WhiteFossa/yiff-l/Hardware/Antennas equivalents/photo_2020-12-26_08-08-45.jpg

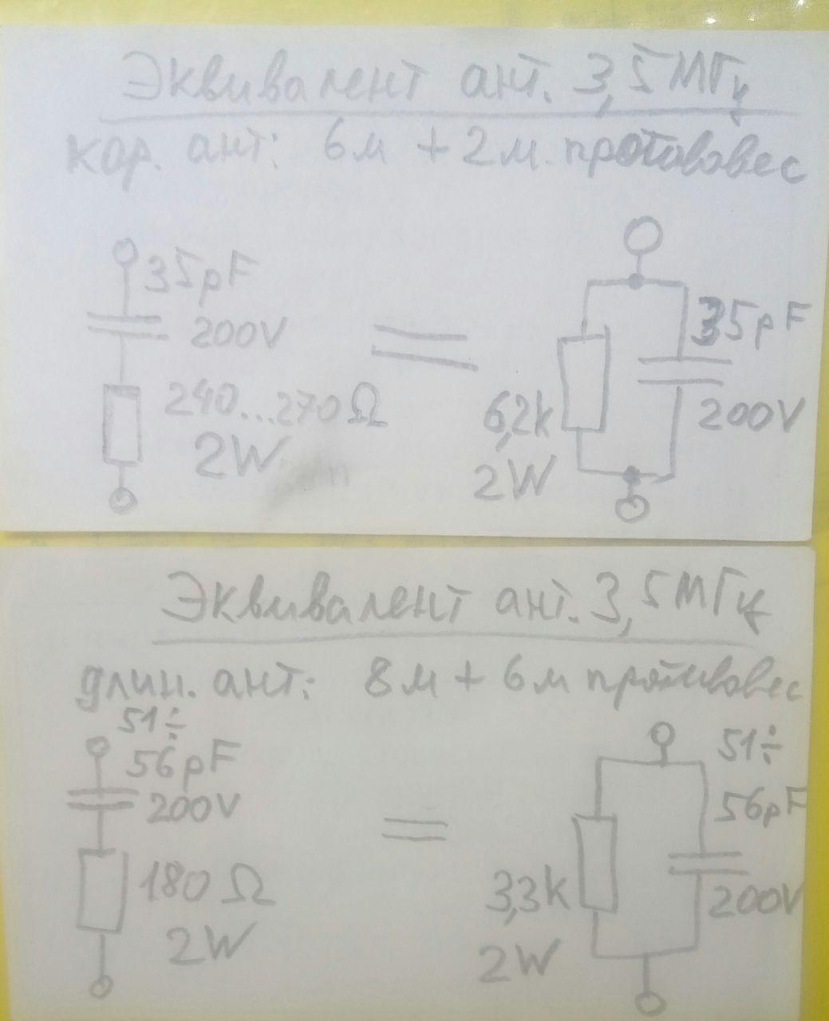
Hardware/Antennas equivalents/photo_2020-12-26_08-08-45.jpg
