WhiteFossa/yiff-l/README.md

3rd party code used:
https://github.com/mpaland/printf - MIT
