WhiteFossa/yiff-l/Hardware/Schematic v1/Full schematic/Full schematic.html

# /mnt/nfs/th/sps/fossa/Projects/Electronics/yiff-l/Hardware/Full schematic/Full schematic/Full schematic.sch

Чт 24 июн 2021 15:16:40

Eeschema 5.1.10-1.fc34

Component Count:329

Ref | Qnty | Value | Part | Datasheet | Description | Vendor
C1 | 1 | 100uFx16V | Device:CP | ~ | Polarized capacitor
C2, C3, C4, C5, C7, C8, C18, C24, C54, C56, C59, C61, C62, C64, C65, C66, C68, C69, C70, C74, C86, C94, C98, C99, C100, C108, C109, C112 | 28 | 0.1uF | Device:C | ~ | Unpolarized capacitor
C6, C30, C37, C38, C39, C41, C42, C43, C51, C55, C71, C77, C96, C97 | 14 | 1nF | Device:C | ~ | Unpolarized capacitor
C9, C10, C11, C12 | 4 | 22uFx16V | Device:CP | ~ | Polarized capacitor
C13 | 1 | 1uF | Device:C | ~ | Unpolarized capacitor
C14, C15, C16, C17, C23, C34, C35, C45, C46, C47, C52, C57, C60, C67, C85 | 15 | 4.7uF | Device:C | ~ | Unpolarized capacitor
C19 | 1 | 150pF | Device:C | ~ | Unpolarized capacitor
C20 | 1 | 220pF | Device:C | ~ | Unpolarized capacitor
C21, C22, C26, C27, C28, C32, C63, C73, C76, C78, C81, C93, C95 | 13 | 10nF | Device:C | ~ | Unpolarized capacitor
C25 | 1 | 180pF | Device:C | ~ | Unpolarized capacitor
C29 | 1 | 1000uF x 10V | Device:CP | ~ | Polarized capacitor
C31, C44, C120, C121, C122, C123, C124, C125 | 8 | 47pF | Device:C | ~ | Unpolarized capacitor
C33, C114, C115, C116, C117, C118, C119 | 7 | 100pF | Device:C | ~ | Unpolarized capacitor
C36, C113 | 2 | 56pF | Device:C | ~ | Unpolarized capacitor
C40 | 1 | 10uFx25V tantalum | Device:CP | ~ | Polarized capacitor
C48, C49, C50 | 3 | 220uFx6.3V | Device:CP | ~ | Polarized capacitor
C53, C58 | 2 | 1000uF x 25V | Device:CP | ~ | Polarized capacitor
C72, C84 | 2 | 75pF | Device:C | ~ | Unpolarized capacitor
C75 | 1 | 100uFx6.3V | Device:CP | ~ | Polarized capacitor
C79, C80 | 2 | 22pF | Device:C | ~ | Unpolarized capacitor
C82, C83 | 2 | 8pF | Device:C | ~ | Unpolarized capacitor
C87, C88, C89, C90, C91, C92 | 6 | 390pF | Device:C | ~ | Unpolarized capacitor
C101 | 1 | 20pF | Device:C | ~ | Unpolarized capacitor
C102, C103, C104, C105, C106, C107 | 6 | 200pF | Device:C | ~ | Unpolarized capacitor
C110 | 1 | 100uF x 16V | Device:CP | ~ | Polarized capacitor
C111 | 1 | 22uF x 10V | Device:CP | ~ | Polarized capacitor
C126, C127, C128, C129, C130, C131 | 6 | 24pF | Device:C | ~ | Unpolarized capacitor
C132, C133, C134, C135, C136, C137 | 6 | 12pF | Device:C | ~ | Unpolarized capacitor
D1, D2, D3, D8, D9, D10, D11, D13 | 8 | 1N4148W | Diode:1N4148W | https://www.vishay.com/docs/85748/1n4148w.pdf | 75V 0.15A Fast Switching Diode, SOD-123
D4, D5, D6, D7 | 4 | MBR0520 | Device:D_Schottky | ~ | Schottky diode
D12 | 1 | 1N5819 | Device:D_Schottky | ~ | Schottky diode
D14 | 1 | 1N4728A | Diode:1N47xxA | https://www.vishay.com/docs/85816/1n4728a.pdf | 1300mW Silicon planar power Zener diodes, DO-41
DA1 | 1 | AD825 | Fossa_library:AD825
J1, J6, J9 | 3 | Conn_01x02_Male | Connector:Conn_01x02_Male | ~ | Generic connector, single row, 01x02, script generated (kicad-library-utils/schlib/autogen/connector/)
J2 | 1 | Reset | Connector:Conn_01x02_Male | ~ | Generic connector, single row, 01x02, script generated (kicad-library-utils/schlib/autogen/connector/)
J3 | 1 | Encoder | Connector:Conn_01x04_Male | ~ | Generic connector, single row, 01x04, script generated (kicad-library-utils/schlib/autogen/connector/)
J4 | 1 | Failure LED | Connector:Conn_01x02_Male | ~ | Generic connector, single row, 01x02, script generated (kicad-library-utils/schlib/autogen/connector/)
J5 | 1 | Bluetooth | Connector:Conn_01x04_Male | ~ | Generic connector, single row, 01x04, script generated (kicad-library-utils/schlib/autogen/connector/)
J7 | 1 | Display | Connector:Conn_01x04_Male | ~ | Generic connector, single row, 01x04, script generated (kicad-library-utils/schlib/autogen/connector/)
J8 | 1 | Buttons | Connector:Conn_01x03_Male | ~ | Generic connector, single row, 01x03, script generated (kicad-library-utils/schlib/autogen/connector/)
J10 | 1 | Conn_01x01_Male | Connector:Conn_01x01_Male | ~ | Generic connector, single row, 01x01, script generated (kicad-library-utils/schlib/autogen/connector/)
JP1 | 1 | BOOT0 | Jumper:Jumper_3_Bridged12 | ~ | Jumper, 3-pole, pins 1+2 closed/bridged
JP2 | 1 | BOOT1 | Jumper:Jumper_3_Bridged12 | ~ | Jumper, 3-pole, pins 1+2 closed/bridged
JP3 | 1 | SWDIO | Device:Jumper | ~ | Jumper, normally closed
JP4 | 1 | SWCLK | Device:Jumper | ~ | Jumper, normally closed
K1, K2, K3, K4, K5, K6 | 6 | EDR101A0500 | Fossa_library:EDR101A0500 | https://standexelectronics.com/de/produkte/ms-reed-relais/ | Standex Meder MS reed relay, SPST, Closing Contact
L1, L3, L4, L5, L11 | 5 | 10uH | Device:L | ~ | Inductor
L2, L9 | 2 | 3.3uH | Device:L | ~ | Inductor
L6, L7 | 2 | 4.7uH | Device:L | ~ | Inductor
L8 | 1 | 50uH | Device:L | ~ | Inductor
L10 | 1 | 150uH | Device:L | ~ | Inductor
L12 | 1 | 21uH | Device:L | ~ | Inductor
L13 | 1 | 200nH | Device:L | ~ | Inductor
L14 | 1 | 300nH | Device:L | ~ | Inductor
L15 | 1 | 23.5nH | Device:L | ~ | Inductor
Q1, Q2, Q3, Q4, Q5, Q11, Q13, Q15, Q17, Q19 | 10 | BC847 | Transistor_BJT:BC847 | http://www.infineon.com/dgdl/Infineon-BC847SERIES_BC848SERIES_BC849SERIES_BC850SERIES-DS-v01_01-en.pdf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 | 0.1A Ic, 45V Vce, NPN Transistor, SOT-23
Q6, Q8, Q9, Q10, Q18, Q21 | 6 | IRLML6402 | Transistor_FET:IRLML6402 | https://www.infineon.com/dgdl/irlml6402pbf.pdf?fileId=5546d462533600a401535668d5c2263c | -3.7A Id, -20V Vds, 65mOhm Rds, P-Channel HEXFET Power MOSFET, SOT-23
Q7 | 1 | IRF4905 | Transistor_FET:IRF4905 | http://www.infineon.com/dgdl/irf4905.pdf?fileId=5546d462533600a4015355e32165197c | -74A Id, -55V Vds, Single P-Channel HEXFET Power MOSFET, 20mOhm Ron, TO-220AB
Q12 | 1 | IRFZ44 | Device:Q_NMOS_GDS | ~ | N-MOSFET transistor, gate/drain/source
Q14 | 1 | BSS138 | Transistor_FET:BSS138 | https://www.onsemi.com/pub/Collateral/BSS138-D.PDF | 50V Vds, 0.22A Id, N-Channel MOSFET, SOT-23
Q16 | 1 | IRF610 | Device:Q_NMOS_GDS | ~ | N-MOSFET transistor, gate/drain/source
Q20 | 1 | BFS17 | Device:Q_NPN_BEC | ~ | NPN transistor, base/emitter/collector
Q22 | 1 | AFT05MS003N | Device:Q_NMOS_GSD | ~ | N-MOSFET transistor, gate/source/drain
Q23, Q24, Q25, Q26, Q27, Q28 | 6 | IRLML2502 | Device:Q_NMOS_GSD | ~ | N-MOSFET transistor, gate/source/drain
R1, R2, R3, R25, R26, R27, R52, R54, R61, R89, R93, R94, R95, R96, R97 | 15 | 100 | Device:R | ~ | Resistor
R4, R5, R11, R17 | 4 | 47k | Device:R | ~ | Resistor
R6, R7, R8, R9, R10, R12, R13, R14, R15, R16, R23, R37, R39, R41, R43, R68, R69, R77, R79, R81 | 20 | 10k | Device:R | ~ | Resistor
R18, R19, R20, R21, R22, R42, R74, R85 | 8 | 10 | Device:R | ~ | Resistor
R24, R48, R64, R65, R67, R70, R73, R78, R80, R84, R86, R87, R88, R90, R91, R92 | 16 | 4.7k | Device:R | ~ | Resistor
R28 | 1 | 1.3k | Device:R | ~ | Resistor
R29 | 1 | 150k | Device:R | ~ | Resistor
R30 | 1 | 12k | Device:R | ~ | Resistor
R31 | 1 | 300 | Device:R | ~ | Resistor
R32, R35 | 2 | 13k | Device:R | ~ | Resistor
R33, R62 | 2 | 3.9k | Device:R | ~ | Resistor
R34 | 1 | 120k | Device:R | ~ | Resistor
R36 | 1 | 51k | Device:R | ~ | Resistor
R38, R75 | 2 | 39k | Device:R | ~ | Resistor
R40, R50, R58 | 3 | 30k | Device:R | ~ | Resistor
R44, R53, R60, R83 | 4 | 1k | Device:R | ~ | Resistor
R45, R46, R47, R49 | 4 | 1 | Device:R | ~ | Resistor
R51, R59 | 2 | 6.8k | Device:R | ~ | Resistor
R55 | 1 | 36k | Device:R | ~ | Resistor
R56 | 1 | 4.3k | Device:R | ~ | Resistor
R57 | 1 | 56k | Device:R | ~ | Resistor
R63 | 1 | 2k | Device:R | ~ | Resistor
R66 | 1 | 33k | Device:R | ~ | Resistor
R71 | 1 | 220k | Device:R | ~ | Resistor
R72 | 1 | 11k | Device:R | ~ | Resistor
R76 | 1 | 33 | Device:R | ~ | Resistor
R82 | 1 | 6.2k | Device:R | ~ | Resistor
RV1, RV2 | 2 | 20k | Device:R_POT | ~ | Potentiometer
U1, U2 | 2 | 74LVC2T45DC | Logic_LevelTranslator:74LVC2T45DC | https://assets.nexperia.com/documents/data-sheet/74LVC_LVCH2T45.pdf | Dual supply translating transceiver, 3-state, 2-bit, VSSOP-8
U3 | 1 | AD9835 | Fossa_library:AD9835
U4 | 1 | LM27313XMF | Regulator_Switching:LM27313XMF | http://www.ti.com/lit/ds/symlink/lm27313.pdf | 1A, 28Vout Boost Voltage Regulator, 1.6MHz Frequency, SOT-23-5
U5, U6, U7 | 3 | LM2734X | Regulator_Switching:LM2734X | http://www.ti.com/lit/ds/symlink/lm2734.pdf | 1A Step-Down DC-DC Regulator, Adjustable Output Voltage, 1.6MHz, TSOT-23-5
U8 | 1 | UC3843_SOIC8 | Regulator_Controller:UC3843_SOIC8 | http://www.ti.com/lit/ds/symlink/uc3842.pdf | Current-Mode PWM Controllers, 100% Duty Cycle, 8.4V/7.6V UVLO, SOIC-8
U9 | 1 | AD5245BRJZ10 | Fossa_library:AD5245
U10 | 1 | ICS501 | Fossa_library:ICS501
U11 | 1 | STM32F103C8Tx | MCU_ST_STM32F1:STM32F103C8Tx | http://www.st.com/st-web-ui/static/active/en/resource/technical/document/datasheet/CD00161566.pdf | ARM Cortex-M3 MCU, 64KB flash, 20KB RAM, 72MHz, 2-3.6V, 37 GPIO, LQFP-48
U12 | 1 | CAT24C256 | Memory_EEPROM:CAT24C256 | https://www.onsemi.cn/PowerSolutions/document/CAT24C256-D.PDF | 256 kb CMOS Serial EEPROM, DIP-8/SOIC-8/TSSOP-8/DFN-8
X1 | 1 | 50MHz | Oscillator:CXO_DIP8 | http://cdn-reichelt.de/documents/datenblatt/B400/OSZI.pdf | Crystal Clock Oscillator, DIP8-style metal package
Y1 | 1 | 8MHz | Device:Crystal | ~ | Two pin crystal
Y2 | 1 | 32768Hz | Device:Crystal | ~ | Two pin crystal
