WhiteFossa/yiff-l/Software/Docs/Smartphone to Fox protocol.odt

Smartphone to Fox communication protocol description

by White Fossa aka Artyom Vetrov.

License: AGPLv3+

# Common packet format

Exchange between smartphone and fox is made via Bluetooth-RFCOMM (i.e. via virtual UART).

All packets (both directions) have the same basic structure:

| Full packet length | Payload | CRC
Size | 1 byte | 1-59 bytes | 4 bytes
Description | Full packet length (i.e. including CRC and packet length byte). Value must be [6-64] (fox-side buffer is 64 bytes length). | Just a payload, here can be anything. | Standard CRC32, calculated over full packet length and payload fields.

Packets with wrong full length (i.e. not from [6-64] range) is discarded immediately.

CRC32 is re-calculated on the receiving side after packet reception, packets with incorrect CRC is discarded too.

# Payload type

First byte of payload always specify type of it. Next types are currently supported:

Payload type | Description | First byte value
Command to fox | Command, issued by smartphone. This type of packet is always sent by smartphone and never by the fox. | 0x00
Response to command | Response to the command from smartphone. Can be sent only by the fox and only as a response to command. | 0x01
Event from fox | Issued by fox when something is happened. Always issued without previous command. | 0x02

# Sleepmodes

All commands with correct CRC reset sleepmodes timer, causing fox to remain active with display turned on. To avoid sleeping it is recommended to use “No operation” command.

# Set date and time

Issue this command to set fox date and time.

This command will fail if fox is armed!

Payload format:

Payload byte | Value | Description
0 | 0x00 | Command to fox
1 | 0x00 | Set date and time
2 | 0-99 | Year of XXI century
3 | 1-12 | Month (1 is January)
4 | 1-31 | Day of month
5 | 1-7 | Day of week (1 is Monday)
6 | 0-23 | Hour
7 | 0-59 | Minute
8 | 0-59 | Second

Total payload length: 9 bytes.

Fox will answer:

Payload byte | Value | Description
0 | 0x01 | Response to command
1 | 0x00 | Set date and time
2 | 0x00 or 0x01 | Is successful? 0x00 if successful, 0x01 if not (for example if time is incorrect).

# Set fox name

Issue this command to set fox name. Note, that setting name also update the bluetooth device name, so it is possible that new pairing will be required.

This command will fail if fox is armed!

Payload format:

Payload byte | Value | Description
0 | 0x00 | Command to fox
1 | 0x01 | Set fox name
2 | 1-32 | Name length
3-35 | Name bytes | Fox name (without null termination)

Fox will answer:

Payload byte | Value | Description
0 | 0x01 | Response to command
1 | 0x01 | Set fox name
2 | 0x00 or 0x01 | Is successful? 0x00 if successful, 0x01 if not (for example if name is too long).

# Get fox name

Issue this command to get fox name.

Payload format:

Payload byte | Value | Description
0 | 0x00 | Command to fox
1 | 0x02 | Get fox name

Fox will answer:

Payload byte | Value | Description
0 | 0x01 | Response to command
1 | 0x02 | Get fox name
2 | 1-32 | Fox name length
3-35 | Name bytes | Fox name (without null termination)

# Get profiles count

Issue this command to get count of profiles inside a fox.

Payload format:

Payload byte | Value | Description
0 | 0x00 | Command to fox
1 | 0x03 | Get profiles count

Fox will answer:

Payload byte | Value | Description
0 | 0x01 | Response to command
1 | 0x03 | Get profiles count
2 | 1-255 | Profiles count

# Get profile name

Issue this command to given profile name.

Payload format:

Payload byte | Value | Description
0 | 0x00 | Command to fox
1 | 0x04 | Get profile name
2 | 0-255 | Profile ID

Fox will answer:

Payload byte | Value | Description
0 | 0x01 | Response to command
1 | 0x04 | Get profile name
2 | 0x00 or 0x01 | Is successful? 0x00 if successful, 0x01 if not (when profile ID is wrong).
3 | 0-255 | Profile ID
4 | 1-16 | Profile name length (have no meaning if not successful)
5-21 | Name bytes | Profile name (without null termination)

# Add new profile

Issue this command to add a new profile.

This command will fail if fox is armed!

Payload format:

Payload byte | Value | Description
0 | 0x00 | Command to fox
1 | 0x05 | Add profile

Fox will answer:

Payload byte | Value | Description
0 | 0x01 | Response to command
1 | 0x05 | Add profile
2 | 0x00 or 0x01 | Is successful? 0x00 if successful, 0x01 if not (when there is too much profiles).

# Get current profile ID

Issue this command to get current profile ID

Payload format:

Payload byte | Value | Description
0 | 0x00 | Command to fox
1 | 0x06 | Get current profile ID

Fox will answer:

Payload byte | Value | Description
0 | 0x01 | Response to command
1 | 0x06 | Get current profile ID
2 | 0-255 | Current profile ID

# Switch to profile

Issue this command to switch to given profile and load fox settings from it.

This command will fail if fox is armed!

Payload format:

Payload byte | Value | Description
0 | 0x00 | Command to fox
1 | 0x07 | Switch to profile
2 | 0-255 | Profile ID to switch

Fox will answer:

Payload byte | Value | Description
0 | 0x01 | Response to command
1 | 0x07 | Switch to profile
2 | 0x00 or 0x01 | Is successful? 0x00 if successful, 0x01 if not (when profile ID is incorrect).

# Set profile name

Issue this command to set current profile name.

This command will fail if fox is armed!

Payload format:

Payload byte | Value | Description
0 | 0x00 | Command to fox
1 | 0x08 | Set profile name
2 | 1-16 | Profile name length
3-18 | Name bytes | Profile name

Fox will answer:

Payload byte | Value | Description
0 | 0x01 | Response to command
1 | 0x08 | Set profile name
2 | 0x00 or 0x01 | Is successful? 0x00 if successful, 0x01 if not (if name length is incorrect).

# Get frequency

Issue this command to get fox frequency

Payload format:

Payload byte | Value | Description
0 | 0x00 | Command to fox
1 | 0x09 | Get frequency

Fox will answer:

Payload byte | Value | Description
0 | 0x01 | Response to command
1 | 0x09 | Get frequency
2 | 0x00 or 0x01 | Is 144MHz? If 0x00 then fox in 3.5MHz range (80m), if 0x01 – then in 144MHz range (2m)
3-6 | uint32_t with frequency, least significant byte first | Fox frequency in Hz

# Set frequency

Issue this command to set fox frequency.

Allowed frequency ranges:

- 3500000 – 3650000 Hz for 3.5MHz range
- 144000000 – 146000000 Hz for 144MHz range

This command will fail if fox is armed!

Payload format:

Payload byte | Value | Description
0 | 0x00 | Command to fox
1 | 0x0A | Set frequency
2 | 0x00 or 0x01 | Is 144MHz? If 0x00 then fox in 3.5MHz range (80m), if 0x01 – then in 144MHz range (2m)
3-6 | uint32_t with frequency, least significant byte first | Fox frequency in Hz

Fox will answer:

Payload byte | Value | Description
0 | 0x01 | Response to command
1 | 0x0A | Set frequency
2 | 0x00 or 0x01 | Is successful? 0x00 if successful, 0x01 if not (if frequency outside allowed ranges).

# Get code

Issue this command to get fox code.

Payload format:

Payload byte | Value | Description
0 | 0x00 | Command to fox
1 | 0x0B | Get fox code

Fox will answer:

Payload byte | Value | Description
0 | 0x01 | Response to command
1 | 0x0B | Get fox code
2 | 0-6 | Fox code: 0 – Finish (MO) 1- Fox #1 (MOE) 2 – Fox #2 (MOI) 3 – Fox #3 (MOS) 4 – Fox #4 (MOH) 5 – Fox #5 (MO5) 6 – Beacon (S)

# Set code

Issue this command to set fox code.

This command will fail if fox is armed!

Payload format:

Payload byte | Value | Description
0 | 0x00 | Command to fox
1 | 0x0C | Set fox code
2 | 0-6 | Fox code: 0 – Finish (MO) 1- Fox #1 (MOE) 2 – Fox #2 (MOI) 3 – Fox #3 (MOS) 4 – Fox #4 (MOH) 5 – Fox #5 (MO5) 6 – Beacon (S)

Fox will answer:

Payload byte | Value | Description
0 | 0x01 | Response to command
1 | 0x0C | Set fox code
2 | 0x00 or 0x01 | Is successful? 0x00 if successful, 0x01 if not (if requested invalid code).

# Get speed

Issue this command to get fox speed.

Payload format:

Payload byte | Value | Description
0 | 0x00 | Command to fox
1 | 0x0D | Get fox speed

Fox will answer:

Payload byte | Value | Description
0 | 0x01 | Response to command
1 | 0x0D | Get fox speed
2 | 0x00 or 0x01 | Fox speed: 0x00 – slow, 0x01 – fast

# Set speed

Issue this command to set fox speed.

This command will fail if fox is armed!

Payload format:

Payload byte | Value | Description
0 | 0x00 | Command to fox
1 | 0x0E | Set fox speed
2 | 0x00 or 0x01 | Fox speed: 0x00 – slow, 0x01 – fast

Fox will answer:

Payload byte | Value | Description
0 | 0x01 | Response to command
1 | 0x0E | Set fox speed
2 | 0x00 or 0x01 | Is successful? 0x00 if successful, 0x01 if not (if requested invalid speed).

# Get cycle

Issue this command to get fox cycle parameters.

Payload format:

Payload byte | Value | Description
0 | 0x00 | Command to fox
1 | 0x0F | Get fox cycle parameters

Fox will answer:

Payload byte | Value | Description
0 | 0x01 | Response to command
1 | 0x0F | Get fox cycle parameters
2 | 0x00 or 0x01 | Is continuous transmission? 0x00 – cyclic transmission, 0x01 – continuous transmission
3-4 | uint16_t, least significant byte first | Transmission time (in seconds), applicable only for cyclic transmission
5-6 | uint16_t, least significant byte first | Pause time (in seconds), applicable only for cyclic transmission

# Set cycle

Issue this command to set fox cycle parameters.

This command will fail if fox is armed!

Payload format:

Payload byte | Value | Description
0 | 0x00 | Command to fox
1 | 0x10 | Set fox cycle parameters
2 | 0x00 or 0x01 | Is continuous transmission? 0x00 – cyclic transmission, 0x01 – continuous transmission
3-4 | uint16_t, least significant byte first | Transmission time (in seconds), applicable only for cyclic transmission, but you must send it in any cases
5-6 | uint16_t, least significant byte first | Pause time (in seconds), applicable only for cyclic transmission, but you must send it in any cases

Fox will answer:

Payload byte | Value | Description
0 | 0x01 | Response to command
1 | 0x10 | Set fox cycle parameters
2 | 0x00 or 0x01 | Is successful? 0x00 if successful, 0x01 if not (too short durations).

# Get ending tone duration

Issue this command to get ending tone duration.

Payload format:

Payload byte | Value | Description
0 | 0x00 | Command to fox
1 | 0x11 | Get ending tone duration

Fox will answer:

Payload byte | Value | Description
0 | 0x01 | Response to command
1 | 0x11 | Get ending tone duration
2 | uint8_t | Ending tone duration in seconds

# Set ending tone duration

Issue this command to set ending tone duration.

This command will fail if fox is armed!

Payload format:

Payload byte | Value | Description
0 | 0x00 | Command to fox
1 | 0x12 | Set ending tone duration
2 | uin8_t | Ending tone duration in seconds

Fox will answer:

Payload byte | Value | Description
0 | 0x01 | Response to command
1 | 0x12 | Set ending tone duration
2 | 0x00 or 0x01 | Is successful? 0x00 if successful, 0x01 if not (too long ending tone).

# Get begin and end times

Issue this command to get times when fox will turn on and off.

Payload format:

Payload byte | Value | Description
0 | 0x00 | Command to fox
1 | 0x13 | Get begin and end times

Fox will answer:

Payload byte | Value | Description
0 | 0x01 | Response to command
1 | 0x13 | Get begin and end times
2-5 | uint32_t, least significant byte first | Begin time (seconds since midnight)
6-9 | uin32_t, least significant byte first | End time (seconds since midnight)

# Is fox armed?

Issue this command to check is fox armed or not. If armed, then it will start to transmit at Begin Time and end at End Time (see “Get begin and end times” command). If fox not armed, it will be in standby forever.

Payload format:

Payload byte | Value | Description
0 | 0x00 | Command to fox
1 | 0x14 | Is fox armed?

Fox will answer:

Payload byte | Value | Description
0 | 0x01 | Response to command
1 | 0x14 | Is fox armed?
2 | 0x00 or 0x01 | 0x00 if not armed, 0x01 if armed

# Arm fox

Issue this command to arm fox. Armed fox will start to transmit at previously set time.

Payload format:

Payload byte | Value | Description
0 | 0x00 | Command to fox
1 | 0x15 | Arm fox

Fox will answer:

Payload byte | Value | Description
0 | 0x01 | Response to command
1 | 0x15 | Arm fox
2 | 0x00 or 0x01 | Is successful? 0x00 if successful, 0x01 if not (fox already armed, for example)

Note, that successful answer doesn’t mean that fox is armed, it just signalizing that arming process is started.

# Disarm fox

Issue this command to disarm fox. If fox in countdown before start, then countdown will be aborted and fox will switch to standby mode, if fox already transmitting – transmission will be cancelled.

This command will fail if fox is NOT armed!

This command will fail if antenna matching in progress!

Payload format:

Payload byte | Value | Description
0 | 0x00 | Command to fox
1 | 0x16 | Disarm fox

Fox will answer:

Payload byte | Value | Description
0 | 0x01 | Response to command
1 | 0x16 | Disarm fox
2 | 0x00 or 0x01 | Is successful? 0x00 if successful, 0x01 if not (internal error during disarming)

# Set begin and end times

Issue this command to set times when fox will turn on and off.

This command will fail if fox is armed!

Payload format:

Payload byte | Value | Description
0 | 0x00 | Command to fox
1 | 0x17 | Set begin and end times
2-5 | uint32_t, least significant byte first | Begin time (seconds since midnight)
6-9 | uin32_t, least significant byte first | End time (seconds since midnight)

Fox will answer:

Payload byte | Value | Description
0 | 0x01 | Response to command
1 | 0x17 | Set begin and end times
2 | 0x00 or 0x01 | Is successful? 0x00 if successful, 0x01 if not (End time is earlier or equal to begin time)

# Get output power

Issue this command to get fox output power (float, in watts). Note, that output power is determined only for 3.5MHz mode, for 144MHz fox just returns hardcoded value.

Payload format:

Payload byte | Value | Description
0 | 0x00 | Command to fox
1 | 0x18 | Get fox power

Fox will answer:

Payload byte | Value | Description
0 | 0x01 | Response to command
1 | 0x18 | Get fox power
2-5 | float | Fox power in watts

# Set output power

Issue this command to set fox output power (float, in watts). Note, that power is settable only for 3.5MHz mode, if fox in 144MHz mode, then this command will always fail.

This command will fail if fox is armed!

Payload format:

Payload byte | Value | Description
0 | 0x00 | Command to fox
1 | 0x19 | Set fox power
2-5 | float | Fox power in watts

Fox will answer:

Payload byte | Value | Description
0 | 0x01 | Response to command
1 | 0x19 | Set fox power
2 | 0x00 or 0x01 | Is successful? 0x00 if successful, 0x01 if not (incorrect power or 144MHz mode)

# Get battery level

Issue this command to get battery level. Level is represented as a float, where 0 is fully discharged and 1 is fully charged.

Payload format:

Payload byte | Value | Description
0 | 0x00 | Command to fox
1 | 0x1A | Get battery level

Fox will answer:

Payload byte | Value | Description
0 | 0x01 | Response to command
1 | 0x1A | Get battery level
2-5 | float | Battery level [0-1]

# Get 3.5MHz antenna voltage level (ADC)

This is service command, not intended to regular use. Issue it to get 3.5MHz antenna voltage level in ADC measurements (i.e. not in volts, but raw ADC value, averaged).

Payload format:

Payload byte | Value | Description
0 | 0x00 | Command to fox
1 | 0x1B | Get 3.5MHz antenna level (ADC)

Fox will answer:

Payload byte | Value | Description
0 | 0x01 | Response to command
1 | 0x1B | Get 3.5MHz antenna level (ADC)
2-5 | float | Averaged antenna voltage

# Get battery voltage level (ADC)

This is service command, not intended to regular use. Issue it to get battery voltage level in ADC measurements (i.e. not in volts, but raw ADC value, averaged).

Payload format:

Payload byte | Value | Description
0 | 0x00 | Command to fox
1 | 0x1C | Get battery level (ADC)

Fox will answer:

Payload byte | Value | Description
0 | 0x01 | Response to command
1 | 0x1C | Get battery level (ADC)
2-5 | float | Averaged battery voltage

# Get 3.5MHz output stage power voltage level (ADC)

This is service command, not intended to regular use. Issue it to get 3.5MHz output stage power voltage level in ADC measurements (i.e. not in volts, but raw ADC value, averaged).

Payload format:

Payload byte | Value | Description
0 | 0x00 | Command to fox
1 | 0x1D | Get 3.5MHz output stage power voltage (ADC)

Fox will answer:

Payload byte | Value | Description
0 | 0x01 | Response to command
1 | 0x1D | Get 3.5MHz output stage power voltage (ADC)
2-5 | float | Averaged power source voltage

# Get battery voltage level

This is service command, not intended to regular use. Issue it to get battery voltage level in volts.

Payload format:

Payload byte | Value | Description
0 | 0x00 | Command to fox
1 | 0x1E | Get battery level (volts)

Fox will answer:

Payload byte | Value | Description
0 | 0x01 | Response to command
1 | 0x1E | Get battery level (volts)
2-5 | float | Averaged battery voltage

# Get 3.5MHz output stage power voltage level

This is service command, not intended to regular use. Issue it to get 3.5MHz output stage power voltage level in volts.

Payload format:

Payload byte | Value | Description
0 | 0x00 | Command to fox
1 | 0x1F | Get 3.5MHz output stage power voltage (volts)

Fox will answer:

Payload byte | Value | Description
0 | 0x01 | Response to command
1 | 0x1F | Get 3.5MHz output stage power voltage (volts)
2-5 | float | Averaged power source voltage

# Get last failure code

This is service command, not intended to regular use. Issue it to get last failure code from fox.

Payload format:

Payload byte | Value | Description
0 | 0x00 | Command to fox
1 | 0x20 | Get last failure code

Fox will answer:

Payload byte | Value | Description
0 | 0x01 | Response to command
1 | 0x20 | Get last failure code
2-5 | uint32_t | Last failure code

# No operation

This command causes no operation. Execute it just to prevent fox from going to sleepmode.

Payload format:

Payload byte | Value | Description
0 | 0x00 | Command to fox
1 | 0x21 | No operation

Fox will answer:

Payload byte | Value | Description
0 | 0x01 | Response to command
1 | 0x21 | No operation

# Get identification data

This command causes fox to identify herself.

Payload format:

Payload byte | Value | Description
0 | 0x00 | Command to fox
1 | 0x22 | Get identification data

Fox will answer:

Payload byte | Value | Description
0 | 0x01 | Response to command
1 | 0x22 | Get identification data
2-5 | uint32_t | Signature. Must be 0xF055AF06 if this device is a fox
6-7 | uint16_t | Protocol version, must be 0x01
8-9 | uint16_t | Hardware revision
10-11 | uint16_t | Software version (for given hardware). It is possible that two versions can exist with the same number for different hardware revisions.
12-15 | uint32_t | Fox serial number.

# Get antenna matching status

This command causes fox to provide antenna matching status.

Payload format:

Payload byte | Value | Description
0 | 0x00 | Command to fox
1 | 0x23 | Get antenna matching status

Fox will answer:

Payload byte | Value | Description
0 | 0x01 | Response to command
1 | 0x23 | Get antenna matching status
2 | uint8_t | Status: 0 – matching never was initiated 1 – matching in progress 2 – matching completed
3 | uint8_t | New for app: 0x00 if app saw this matching 0x01 if not
4 | uint8_t | Total matcher positions
5 | uint8_t | Current matcher position (starting from 0)
6-9 | float | Current antenna voltage
10 | uint8_t | Current best match position
11-14 | float | Current best match voltage (in volts)

# Get antenna matching data

This command causes fox to return data about one matcher position.

Payload format:

Payload byte | Value | Description
0 | 0x00 | Command to fox
1 | 0x24 | Get antenna matching data
2 | uint8_t | Requested position

Fox will answer:

Payload byte | Value | Description
0 | 0x01 | Response to command
1 | 0x24 | Get antenna matching data
2 | uint8_t | 0x00 if successful 0x01 if requested position is incorrect
3-6 | float | Requested position antenna voltage (in volts)

# Mark matching data as seen

This command marks matching data as seen by app

Payload format:

Payload byte | Value | Description
0 | 0x00 | Command to fox
1 | 0x25 | Mark matching as seen

Fox will answer:

Payload byte | Value | Description
0 | 0x01 | Response to command
1 | 0x25 | Mark matching as seen

# Check for profile settings changes

This command checks if there are any profile settings changes since last call of this command. Only changes, made via fox controls will be reported. Profile switch itself doesn’t count as change.

Payload format:

Payload byte | Value | Description
0 | 0x00 | Command to fox
1 | 0x26 | Check for profile settings changes

Fox will answer:

Payload byte | Value | Description
0 | 0x01 | Response to command
1 | 0x26 | Check for profile settings changes
2 | uint8_t | 0x00 – no changes 0x01 – there were some changes

# Reset last failure code

This command resets last failure code to 0 (i.e. to OK).

Payload format:

Payload byte | Value | Description
0 | 0x00 | Command to fox
1 | 0x27 | Reset last failure code

Fox will answer:

Payload byte | Value | Description
0 | 0x01 | Response to command
1 | 0x27 | Reset last failure code

# Update serial number

Use this command to update fox serial number (for example after EEPROM damage).

Payload format:

Payload byte | Value | Description
0 | 0x00 | Command to fox
1 | 0x28 | Update serial number
2-5 | uint32_t | New serial number

Fox will answer:

Payload byte | Value | Description
0 | 0x01 | Response to command
1 | 0x28 | Update serial number

# Get Ubatt(ADC) to Ubatt(Volts) factors

Use this command to get factors, used to convert ADC value to battery voltage. Ubatt(Volts) = A * Ubatt(ADC) + B

Payload format:

Payload byte | Value | Description
0 | 0x00 | Command to fox
1 | 0x29 | Get Ubatt(ADC) to Ubatt(Volts) factors

Fox will answer:

Payload byte | Value | Description
0 | 0x01 | Response to command
1 | 0x29 | Get Ubatt(ADC) to Ubatt(Volts) factors
2-5 | float | Factor A
6-9 | float | Factor B

# Set Ubatt(ADC) to Ubatt(Volts) factors

Use this command to set factors, used to convert ADC value to battery voltage. Ubatt(Volts) = A * Ubatt(ADC) + B. Note, that there is no values control at the fox side.

Payload format:

Payload byte | Value | Description
0 | 0x00 | Command to fox
1 | 0x2A | Set Ubatt(ADC) to Ubatt(Volts) factors
2 | uint8_t | Reset: 0x00 – do not reset factors to factory defaults; 0x01 – reset factors to factory defaults. In case of reset Factor A and Factor B are ignored.
3-6 | float | Factor A
7-10 | float | Factor B

Fox will answer:

Payload byte | Value | Description
0 | 0x01 | Response to command
1 | 0x2A | Set Ubatt(ADC) to Ubatt(Volts) factors
2 | uint8_t | 0x00 if successful, 0x01 if not. For now it always successful.

# Get Ubatt(Volts) to battery level factors

Use this command to get factors, used to convert battery voltage to battery level. Level = A * Ubatt(Volts) + B

Payload format:

Payload byte | Value | Description
0 | 0x00 | Command to fox
1 | 0x2B | Get Ubatt(Volts) to level factors

Fox will answer:

Payload byte | Value | Description
0 | 0x01 | Response to command
1 | 0x2B | Get Ubatt(Volts) to level factors
2-5 | float | Factor A
6-9 | float | Factor B

# Set Ubatt(Volts) to battery level factors

Use this command to set factors, used to convert battery voltage to battery level. Level = A * Ubatt(Volts) + B. Note, that there is no values control at the fox side.

Payload format:

Payload byte | Value | Description
0 | 0x00 | Command to fox
1 | 0x2C | Set Ubatt(Volts) to level factors
2 | uint8_t | Reset: 0x00 – do not reset factors to factory defaults; 0x01 – reset factors to factory defaults. In case of reset Factor A and Factor B are ignored.
3-6 | float | Factor A
7-10 | float | Factor B

Fox will answer:

Payload byte | Value | Description
0 | 0x01 | Response to command
1 | 0x2C | Set Ubatt(Volts) to level factors
2 | uint8_t | 0x00 if successful, 0x01 if not. For now it always successful.

# Get U80m(ADC) to U80m(Volts) factors

Use this command to get factors, used to convert ADC measurements to 80 meters output stage supply voltage. U80m(Volts) = A * U80m(ADC) + B

Payload format:

Payload byte | Value | Description
0 | 0x00 | Command to fox
1 | 0x2D | Get U80m(ADC) to U80m(Volts) factors

Fox will answer:

Payload byte | Value | Description
0 | 0x01 | Response to command
1 | 0x2D | Get U80m(ADC) to U80m(Volts) factors
2-5 | float | Factor A
6-9 | float | Factor B

# Set U80m(ADC) to U80m(Volts) factors

Use this command to set factors, used to convert ADC measurements to 80 meters output stage supply voltage. U80m(Volts) = A * U80m(ADC) + B Note, that there is no values control at the fox side.

Payload format:

Payload byte | Value | Description
0 | 0x00 | Command to fox
1 | 0x2E | Set U80m(ADC) to U80m(Volts) factors
2 | uint8_t | Reset: 0x00 – do not reset factors to factory defaults; 0x01 – reset factors to factory defaults. In case of reset Factor A and Factor B are ignored.
3-6 | float | Factor A
7-10 | float | Factor B

Fox will answer:

Payload byte | Value | Description
0 | 0x01 | Response to command
1 | 0x2E | Set U80m(ADC) to U80m(Volts) factors
2 | uint8_t | 0x00 if successful, 0x01 if not. For now it always successful.

# Get P80m to U80m factors

Use this command to get factors, used to convert 80 meters output power to 80 meters output stage supply voltage. U80m = A * P80m + B

Payload format:

Payload byte | Value | Description
0 | 0x00 | Command to fox
1 | 0x2F | Get P80m to U80m factors

Fox will answer:

Payload byte | Value | Description
0 | 0x01 | Response to command
1 | 0x2F | Get P80m to U80m factors
2-5 | float | Factor A
6-9 | float | Factor B

# Set P80m to U80m factors

Use this command to set factors, used to convert 80 meters output power to 80 meters output stage supply voltage. U80m = A * P80m + B Note, that there is no values control at the fox side.

Payload format:

Payload byte | Value | Description
0 | 0x00 | Command to fox
1 | 0x30 | Set P80m to U80m factors
2 | uint8_t | Reset: 0x00 – do not reset factors to factory defaults; 0x01 – reset factors to factory defaults. In case of reset Factor A and Factor B are ignored.
3-6 | float | Factor A
7-10 | float | Factor B

Fox will answer:

Payload byte | Value | Description
0 | 0x01 | Response to command
1 | 0x30 | Set P80m to U80m factors
2 | uint8_t | 0x00 if successful, 0x01 if not. For now it always successful.

# Get 3.5MHz antenna voltage level

This is service command, not intended to regular use. Issue it to get 3.5MHz antenna voltage level in volts (averaged).

Payload format:

Payload byte | Value | Description
0 | 0x00 | Command to fox
1 | 0x31 | Get 3.5MHz antenna level (volts)

Fox will answer:

Payload byte | Value | Description
0 | 0x01 | Response to command
1 | 0x31 | Get 3.5MHz antenna level (volts)
2-5 | float | Averaged antenna voltage

# Get Uant(ADC) to Uant(volts) factors

Use this command to get factors, used to convert raw ADC value to 80 meters antenna voltage. Uant(volts) = A * Uant(ADC) + B

Payload format:

Payload byte | Value | Description
0 | 0x00 | Command to fox
1 | 0x32 | Get Uant(ADC) to Uant(volts) factors

Fox will answer:

Payload byte | Value | Description
0 | 0x01 | Response to command
1 | 0x32 | Get Uant(ADC) to Uant(volts) factors
2-5 | float | Factor A
6-9 | float | Factor B

# Set Uant(ADC) to Uant(volts) factors

Use this command to set factors, used to convert raw ADC value to 80 meters antenna voltage. Uant(volts) = A * Uant(ADC) + B Note, that there is no values control at the fox side.

Payload format:

Payload byte | Value | Description
0 | 0x00 | Command to fox
1 | 0x33 | Set Uant(ADC) to Uant(volts) factors
2 | uint8_t | Reset: 0x00 – do not reset factors to factory defaults; 0x01 – reset factors to factory defaults. In case of reset Factor A and Factor B are ignored.
3-6 | float | Factor A
7-10 | float | Factor B

Fox will answer:

Payload byte | Value | Description
0 | 0x01 | Response to command
1 | 0x33 | Set Uant(ADC) to Uant(volts) factors
2 | uint8_t | 0x00 if successful, 0x01 if not. For now it always successful.

# Force TX on

This is the service command, forcing fox to enable transmitter (carrier on 80m, modulated carrier on 2m). Fox must not be armed when this command is issued.

Payload format:

Payload byte | Value | Description
0 | 0x00 | Command to fox
1 | 0x34 | Force TX on

Fox will answer:

Payload byte | Value | Description
0 | 0x01 | Response to command
1 | 0x34 | Force TX on
2 | 0x00 or 0x01 | Is successful? 0x00 if successful, 0x01 if not (fox is armed, for example)

# Return to normal operations after force TX on

Issue this command to return to normal operations after forcing TX on.

Payload format:

Payload byte | Value | Description
0 | 0x00 | Command to fox
1 | 0x35 | Return to normal operations after forcing TX on

Fox will answer:

Payload byte | Value | Description
0 | 0x01 | Response to command
1 | 0x35 | Return to normal operations after forcing TX on
2 | 0x00 or 0x01 | Is successful? 0x00 if successful, 0x01 if not (fox was not in force TX mode, for example)

# Get RTC calibration value

This is service command, returning RTC calibration value.

Payload format:

Payload byte | Value | Description
0 | 0x00 | Command to fox
1 | 0x36 | Get RTC calibration value

Fox will answer:

Payload byte | Value | Description
0 | 0x01 | Response to command
1 | 0x36 | Get RTC calibration value
2 | [0x00;0x7F] | RTC calibration value. 0x00 – fastest RTC 0x7F – slowest RTC

# Set RTC calibration value

This is service command, used to set RTC calibration value.

Payload format:

Payload byte | Value | Description
0 | 0x00 | Command to fox
1 | 0x37 | Set RTC calibration value
1 | [0x00;0x7F] | RTC calibration value. 0x00 – fastest RTC 0x7F – slowest RTC

Fox will answer:

Payload byte | Value | Description
0 | 0x01 | Response to command
1 | 0x37 | Set RTC calibration value
2 | uint8_t | Is successful? 0x00 if successful, 0x01 if not (incorrect calibration value)

# Get disarm on discharge value

Service command. Get disarm-on discharge value, meaning if battery level drops to this (or below this) value (in percents), then armed fox will disarm.

Payload format:

Payload byte | Value | Description
0 | 0x00 | Command to fox
1 | 0x38 | Get disarm on discharge value

Fox will answer:

Payload byte | Value | Description
0 | 0x01 | Response to command
1 | 0x38 | Get disarm on discharge value
2-5 | float | Disarm on discharge value, where 0 is battery 0% and 1 is battery 100%.

# Set disarm on discharge value

Service command. Set disarm-on discharge value, meaning if battery level drops to this (or below this) value (in percents), then armed fox will disarm.

Payload format:

Payload byte | Value | Description
0 | 0x00 | Command to fox
1 | 0x39 | Set disarm on discharge value
2-5 | float | Disarm on discharge value, in battery percents / 100.

Fox will answer:

Payload byte | Value | Description
0 | 0x01 | Response to command
1 | 0x39 | Set disarm on discharge value
2 | uint8_t | Is successful? 0x00 if successful, 0x01 if not (incorrect value)

# Entering sleepmode event

This is an event, signalizing that fox is going to sleepmode immediately after it. Control software have to drop connection after it.

Payload byte | Value | Description
0 | 0x02 | Event
1 | 0x01 | Entering sleepmode
