WhiteFossa/yiff-l/Hardware/Prototype 2/Filter response.ods

Frequency (MHz) | Before | After | k
18 | 1 | 0.8 | 0.8
19 | 0.95 | 0.7 | 0.736842105263158
20 | 0.9 | 0.5 | 0.555555555555556
21 | 0.9 | 0.4 | 0.444444444444444
22 | 1 | 0.3 | 0.3
23 | 1.2 | 0.25 | 0.208333333333333
24 | 1.4 | 0.25 | 0.178571428571429
25 | 1.4 | 0.25 | 0.178571428571429
