WhiteFossa/yiff-l/Hardware/Old/Prototype 2/Full schematic/Full schematic.html

# /mnt/nfs/th/sps/fossa/Projects/Electronics/yiff-l/Hardware/Full schematic/Full schematic/Full schematic.sch

Ср 10 мар 2021 17:36:54

Eeschema 5.1.9-1.fc33

Component Count:163

Ref | Qnty | Value | Part | Datasheet | Description | Vendor
C1, C2, C3, C4, C5, C6, C7, C11, C16, C17, C18, C20, C21, C23, C24, C26, C27, C31, C43, C53 | 20 | 0.1uF | Device:C | ~ | Unpolarized capacitor
C8, C9, C22, C30 | 4 | 10nF | Device:C | ~ | Unpolarized capacitor
C10 | 1 | 470uF x 6V | Device:CP | ~ | Polarized capacitor
C12, C51 | 2 | 470uF x 10V | Device:CP | ~ | Polarized capacitor
C13, C15, C61, C62, C63, C64, C65, C66 | 8 | 47pF | Device:C | ~ | Unpolarized capacitor
C14, C54 | 2 | 56pF | Device:C | ~ | Unpolarized capacitor
C19 | 1 | 470uFx16V | Device:CP | ~ | Polarized capacitor
C25 | 1 | 1000uF x 25V | Device:CP | ~ | Polarized capacitor
C28, C33, C41, C42 | 4 | 1nF | Device:C | ~ | Unpolarized capacitor
C29, C34 | 2 | 75pF | Device:C | ~ | Unpolarized capacitor
C32, C52 | 2 | 470uFx6.3V | Device:CP | ~ | Polarized capacitor
C35, C36, C37, C38, C39, C40 | 6 | 390pF | Device:C | ~ | Unpolarized capacitor
C44 | 1 | 20pF | Device:C | ~ | Unpolarized capacitor
C45, C46, C47, C48, C49, C50 | 6 | 200pF | Device:C | ~ | Unpolarized capacitor
C55, C56, C57, C58, C59, C60 | 6 | 100pF | Device:C | ~ | Unpolarized capacitor
C67, C68, C69, C70, C71, C72 | 6 | 24pF | Device:C | ~ | Unpolarized capacitor
C73, C74, C75, C76, C77, C78 | 6 | 12pF | Device:C | ~ | Unpolarized capacitor
D1 | 1 | 1N4148W | Diode:1N4148W | https://www.vishay.com/docs/85748/1n4148w.pdf | 75V 0.15A Fast Switching Diode, SOD-123
D2 | 1 | 1N4728A | Diode:1N47xxA | https://www.vishay.com/docs/85816/1n4728a.pdf | 1300mW Silicon planar power Zener diodes, DO-41
DA1 | 1 | AD825 | Fossa_library:AD825
J1, J4 | 2 | Conn_01x04_Male | Connector:Conn_01x04_Male | ~ | Generic connector, single row, 01x04, script generated (kicad-library-utils/schlib/autogen/connector/)
J2, J5 | 2 | Conn_01x03_Male | Connector:Conn_01x03_Male | ~ | Generic connector, single row, 01x03, script generated (kicad-library-utils/schlib/autogen/connector/)
J3, J6, J7, J8 | 4 | Conn_01x02_Male | Connector:Conn_01x02_Male | ~ | Generic connector, single row, 01x02, script generated (kicad-library-utils/schlib/autogen/connector/)
J9 | 1 | Conn_01x07_Male | Connector:Conn_01x07_Male | ~ | Generic connector, single row, 01x07, script generated (kicad-library-utils/schlib/autogen/connector/)
K1, K2, K3, K4, K5, K6 | 6 | EDR101A0500 | Fossa_library:EDR101A0500 | https://standexelectronics.com/de/produkte/ms-reed-relais/ | Standex Meder MS reed relay, SPST, Closing Contact
L1, L4 | 2 | 3.3uH | Device:L | ~ | Inductor
L2, L3 | 2 | 4.7uH | Device:L | ~ | Inductor
L5 | 1 | 10uH | Device:L | ~ | Inductor
L6 | 1 | 21uH | Device:L | ~ | Inductor
L7 | 1 | 200nH | Device:L | ~ | Inductor
L8 | 1 | 300nH | Device:L | ~ | Inductor
L9 | 1 | 23.5nH | Device:L | ~ | Inductor
Q1, Q3 | 2 | BC847 | Transistor_BJT:BC847 | http://www.infineon.com/dgdl/Infineon-BC847SERIES_BC848SERIES_BC849SERIES_BC850SERIES-DS-v01_01-en.pdf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 | 0.1A Ic, 45V Vce, NPN Transistor, SOT-23
Q2, Q5 | 2 | BSS138 | Transistor_FET:BSS138 | https://www.onsemi.com/pub/Collateral/BSS138-D.PDF | 50V Vds, 0.22A Id, N-Channel MOSFET, SOT-23
Q4 | 1 | IRF610 | Device:Q_NMOS_GDS | ~ | N-MOSFET transistor, gate/drain/source
Q6 | 1 | BFS17 | Device:Q_NPN_BEC | ~ | NPN transistor, base/emitter/collector
Q7 | 1 | AFT05MS003N | Device:Q_NMOS_GSD | ~ | N-MOSFET transistor, gate/source/drain
Q8, Q9, Q10, Q11, Q12, Q13 | 6 | IRLML2502 | Device:Q_NMOS_GSD | ~ | N-MOSFET transistor, gate/source/drain
R1, R2, R3, R4, R5, R6, R12, R14, R19, R24, R33, R34, R35, R36, R37, R38 | 16 | 100 | Device:R | ~ | Resistor
R7 | 1 | 300 | Device:R | ~ | Resistor
R8, R20 | 2 | 3.9k | Device:R | ~ | Resistor
R9, R22, R23 | 3 | 4.7k | Device:R | ~ | Resistor
R10, R16 | 2 | 30k | Device:R | ~ | Resistor
R11, R17 | 2 | 6.8k | Device:R | ~ | Resistor
R13, R18, R32 | 3 | 1k | Device:R | ~ | Resistor
R15 | 1 | 56k | Device:R | ~ | Resistor
R21 | 1 | 2k | Device:R | ~ | Resistor
R25 | 1 | 47k | Device:R | ~ | Resistor
R26 | 1 | 220k | Device:R | ~ | Resistor
R27 | 1 | 11k | Device:R | ~ | Resistor
R28 | 1 | 39k | Device:R | ~ | Resistor
R29 | 1 | 33 | Device:R | ~ | Resistor
R30 | 1 | 10k | Device:R | ~ | Resistor
R31 | 1 | 6.2k | Device:R | ~ | Resistor
RV1, RV2 | 2 | 20k | Device:R_POT | ~ | Potentiometer
U1, U2 | 2 | 74LVC2T45DC | Logic_LevelTranslator:74LVC2T45DC | https://assets.nexperia.com/documents/data-sheet/74LVC_LVCH2T45.pdf | Dual supply translating transceiver, 3-state, 2-bit, VSSOP-8
U3 | 1 | AD9835 | Fossa_library:AD9835
U4 | 1 | ICS501 | Fossa_library:ICS501
X1 | 1 | 50MHz | Oscillator:CXO_DIP8 | http://cdn-reichelt.de/documents/datenblatt/B400/OSZI.pdf | Crystal Clock Oscillator, DIP8-style metal package
