WhiteFossa/yiff-l/Hardware/Old/Prototype 1/Power vs Upower.ods

Upower | Ur (p-p) | Urms | Pout | Iin | Pin | Efficiency
12 | 68 | 48.0832611206852 | 10.5090909090909 | 0.34 | 4.08 | 2.57575757575757
12.5 | 70 | 49.4974746830583 | 11.1363636363636 | 0.35 | 4.375 | 2.54545454545454
13 | 72 | 50.9116882454314 | 11.7818181818182 | 0.36 | 4.68 | 2.51748251748252
13.5 | 74 | 52.3259018078045 | 12.4454545454545 | 0.36 | 4.86 | 2.56079311634867
14 | 76 | 53.7401153701776 | 13.1272727272727 | 0.37 | 5.18 | 2.53422253422253
14.5 | 78 | 55.1543289325507 | 13.8272727272727 | 0.38 | 5.51 | 2.50948688335258
15 | 80 | 56.5685424949238 | 14.5454545454545 | 0.38 | 5.7 | 2.5518341307815
15.5 | 82 | 57.9827560572969 | 15.2818181818182 | 0.4 | 6.2 | 2.46480938416422
16 | 82 | 57.9827560572969 | 15.2818181818182 | 0.4 | 6.4 | 2.38778409090909
16.5 | 84 | 59.39696961967 | 16.0363636363636 | 0.4 | 6.6 | 2.4297520661157
17 | 86 | 60.8111831820431 | 16.8090909090909 | 0.41 | 6.97 | 2.41163427677057
17.5 | 86 | 60.8111831820431 | 16.8090909090909 | 0.41 | 7.175 | 2.34273044029142
18 | 88 | 62.2253967444162 | 17.6 | 0.42 | 7.56 | 2.32804232804233
18.5 | 90 | 63.6396103067893 | 18.4090909090909 | 0.42 | 7.77 | 2.36925236925237
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
