WhiteFossa/yiff-l/Hardware/3D Printable/Antenna 2m/Antenna 2m - base.FCStd

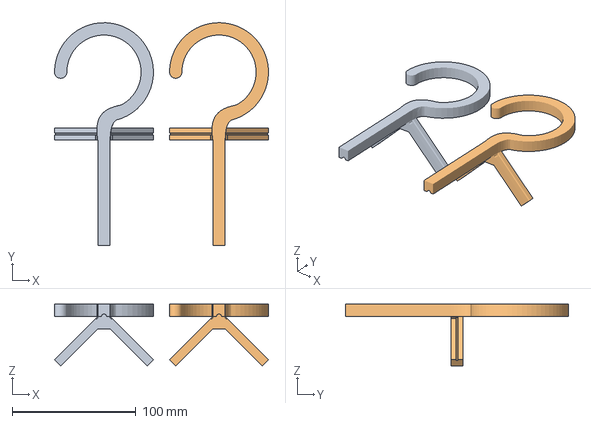
[picture p2: CAD file, 2022-02-08]
Hardware/3D Printable/Antenna 2m/Antenna 2m - base.FCStd
173.0 x 180.0 x 50.0 mm
Fusion (Meshed)
