WhiteFossa/yiff-l/Hardware/3D Printable/Case - top (Meshed).stl

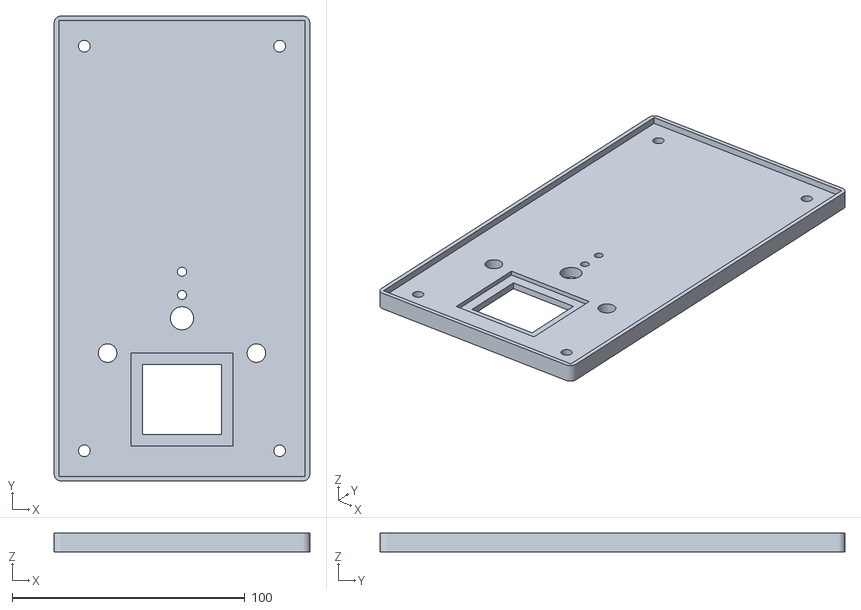
[picture p3: CAD file, 2021-07-16]
Hardware/3D Printable/Case - top (Meshed).stl
110.0 x 200.0 x 8.00
