WhiteFossa/yiff-l/Hardware/3D Printable/Antenna 2m/Antenna 2m - wire tip.FCStd

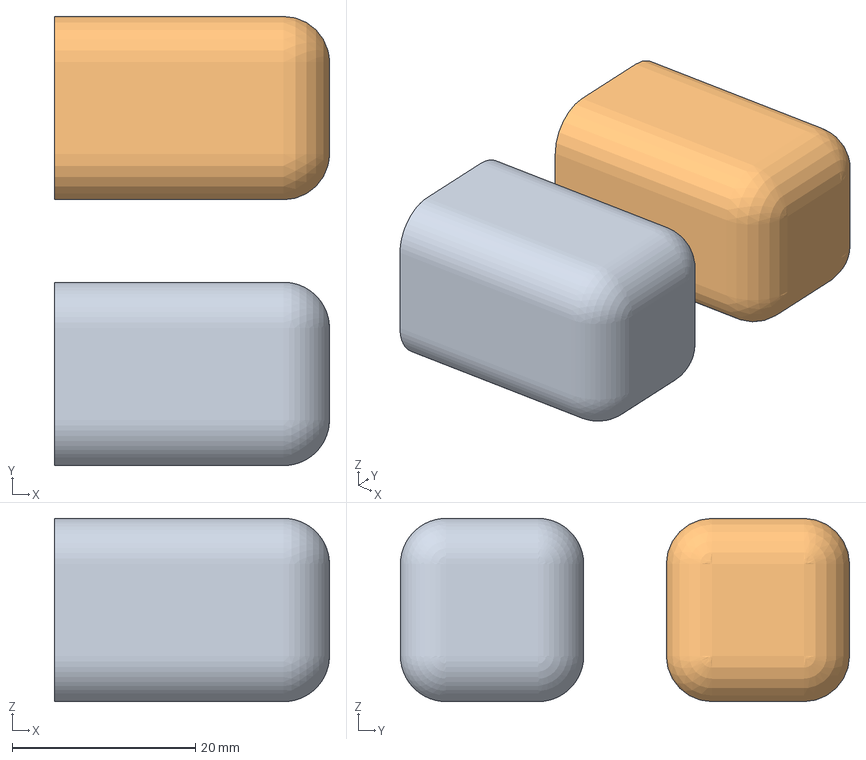
[picture p4: CAD file, 2022-02-08]
Hardware/3D Printable/Antenna 2m/Antenna 2m - wire tip.FCStd
30.0 x 49.0 x 20.0 mm
Fillet001 (Meshed)
