WhiteFossa/yiff-l/Hardware/3D Printable/Case - top.FCStd

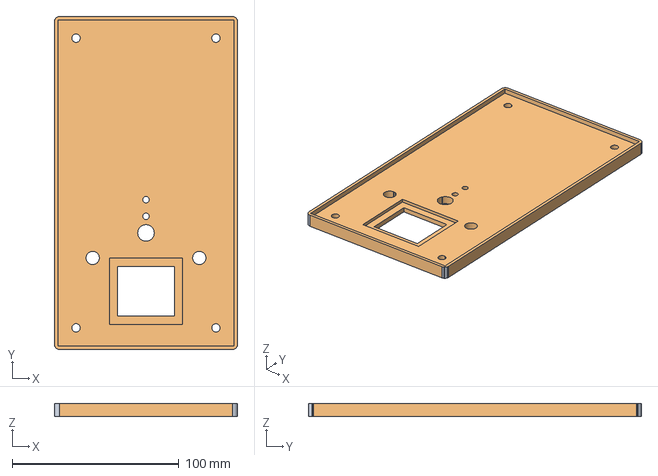
[picture p5: CAD file, 2021-07-16]
Hardware/3D Printable/Case - top.FCStd
110.0 x 200.0 x 8.00 mm
Case - top (Meshed)
