WhiteFossa/yiff-l/Hardware/3D Printable/PCB fixers.FCStd

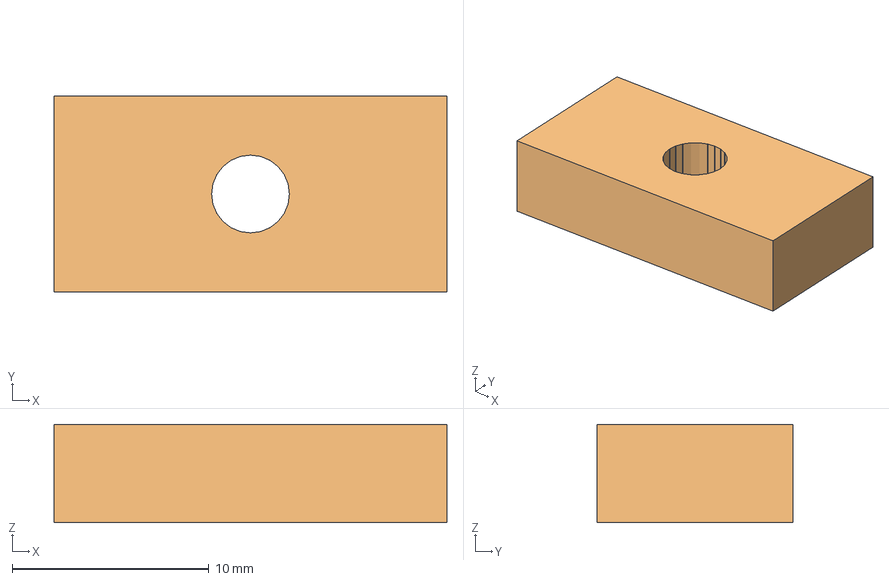
[picture p6: CAD file, 2021-07-13]
Hardware/3D Printable/PCB fixers.FCStd
20.0 x 10.0 x 5.00 mm
PCB Fixer (Meshed)
