WhiteFossa/yiff-l/Hardware/3D Printable/PCB Fixer (Meshed).stl

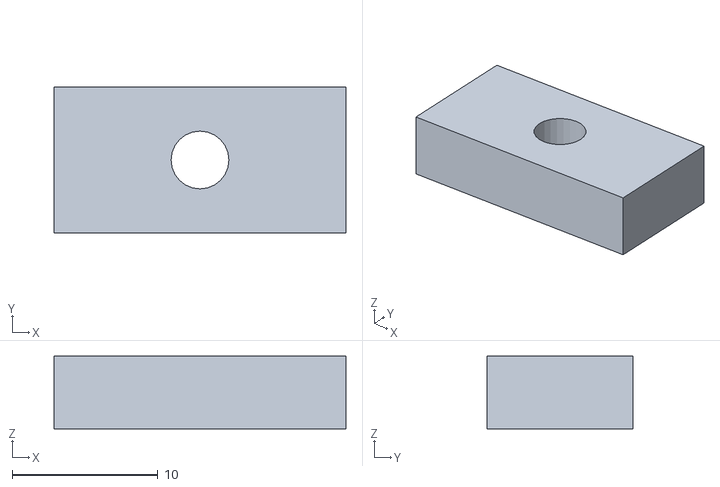
[picture p7: CAD file, 2021-07-13]
Hardware/3D Printable/PCB Fixer (Meshed).stl
20.0 x 10.0 x 5.00
