WhiteFossa/yiff-l/Hardware/3D Printable/Case - bottom.FCStd

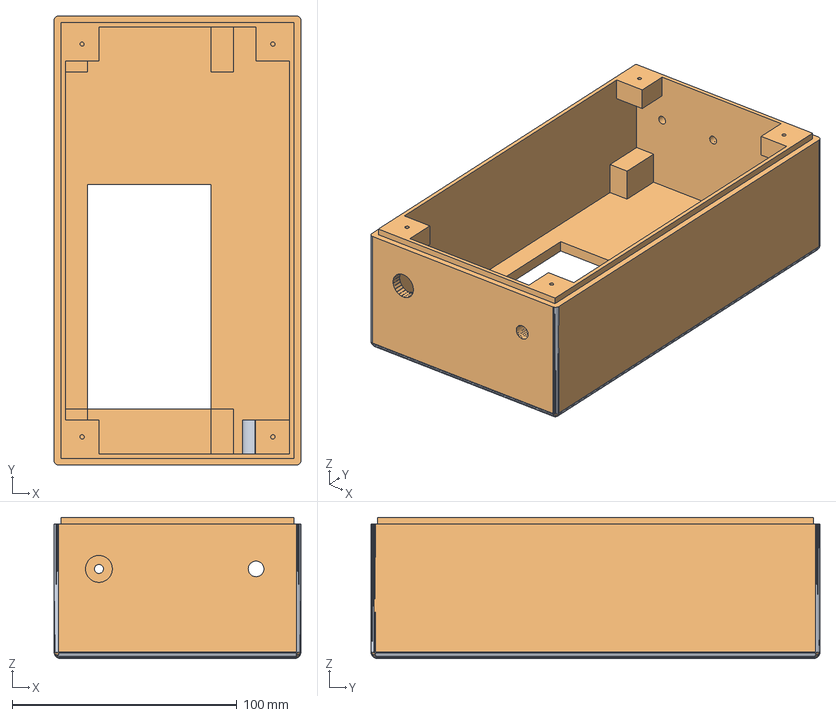
[picture p8: CAD file, 2021-07-10]
Hardware/3D Printable/Case - bottom.FCStd
110.0 x 200.0 x 63.0 mm
Case - bottom (Meshed)
