WhiteFossa/yiff-l/Hardware/3D Printable/Case - bottom (Meshed).stl

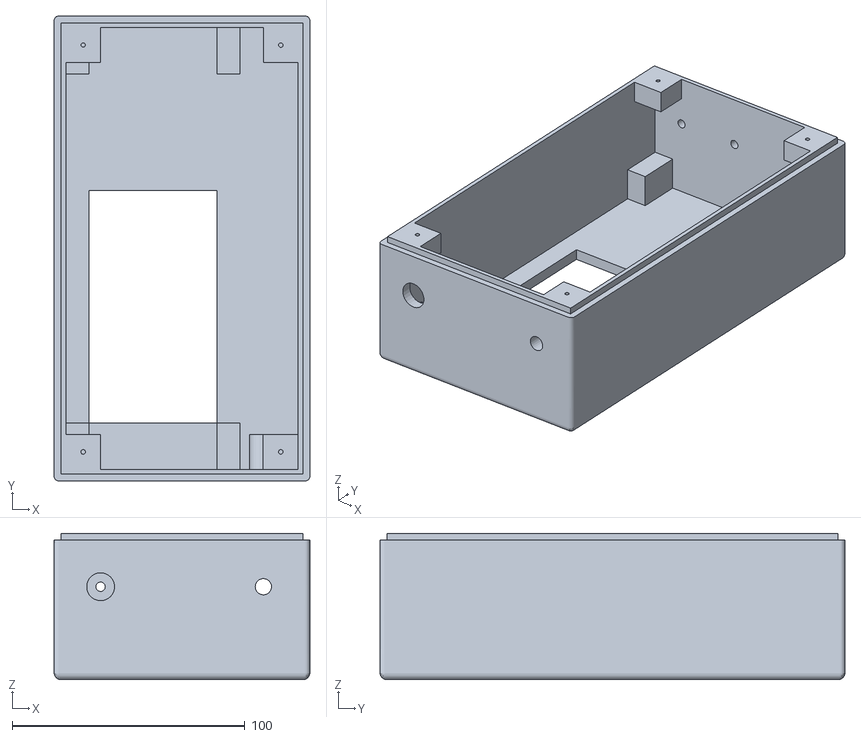
[picture p9: CAD file, 2021-07-10]
Hardware/3D Printable/Case - bottom (Meshed).stl
110.0 x 200.0 x 63.0
