WhiteFossa/yiff-l/(list of files, cad)

Other CAD files:
Hardware/3D Printable/Antenna 2m/Antenna 2m - base.stl
Hardware/3D Printable/Antenna 2m/Antenna 2m - wire tip.stl
