WhiteFossa/yiff-l/Hardware/Schematic v1/Calibrations/U80m calibration.odt

3.5MHz output stage power source calibration

Voltage vs ADC measurement:

U80m (volts) | Power (watts)
12 | 2.62727272727273
12.5 | 2.78409090909091
13 | 2.94545454545455
13.5 | 3.11136363636364
14 | 3.28181818181818
14.5 | 3.45681818181818
15 | 3.63636363636364
15.5 | 3.82045454545455
16 | 3.82045454545455
16.5 | 4.00909090909091
17 | 4.20227272727273
17.5 | 4.20227272727273
18 | 4.4
18.5 | 4.60227272727273
19 | 4.60227272727273
19.5 | 4.80909090909091

U = aP + b, where P is 3.5MHz tract output power.

a= {Umax-Umin} over {Pmax-Pmin} b= {Umin cdot Pmax-Umax cdot Pmin} over {Pmax-Pmin}

For mine, pre-series exemplar, a = 3.440, b= 2.952
