WhiteFossa/yiff-l/Hardware/Schematic v1/Calibrations/Power 80m calibration.odt

3.5MHz output stage power source calibration

DAC | ADC | Voltage
0 | 3357 | 21.5
16 | 3008 | 19.3
32 | 2731 | 17.6
48 | 2507 | 16.2
64 | 2322 | 15.0
80 | 2168 | 14.0
96 | 2033 | 13.2
112 | 1919 | 12.5
128 | 1821 | 11.9
144 | 1734 | 11.3
160 | 1657 | 10.8
176 | 1589 | 10.4
192 | 1527 | 10.0
208 | 1471 | 9.7
224 | 1421 | 9.3
240 | 1375 | 9.0
255 | 1335 | 8.8

Voltage vs ADC measurement:

ADC | Voltage
3357 | 21.5
3008 | 19.3
2731 | 17.6
2507 | 16.2
2322 | 15.0
2168 | 14.0
2033 | 13.2
1919 | 12.5
1821 | 11.9
1734 | 11.3
1657 | 10.8
1589 | 10.4
1527 | 10.0
1471 | 9.7
1421 | 9.3
1375 | 9.0
1335 | 8.8

U = aX + b, where X is ADC measurement.

a= {Umax-Umin} over {Xmax-Xmin} b= {Umin cdot Xmax-Umax cdot Xmin} over {Xmax-Xmin}

For mine, pre-series exemplar, a = 0.006281, b=0.4150

Voltage vs DAC value:

DAC | Voltage
0 | 21.5
16 | 19.3
32 | 17.6
48 | 16.2
64 | 15.0
80 | 14.0
96 | 13.2
112 | 12.5
128 | 11.9
144 | 11.3
160 | 10.8
176 | 10.4
192 | 10.0
208 | 9.7
224 | 9.3
240 | 9.0
255 | 8.8
