WhiteFossa/yiff-l/Hardware/Schematic v1/Calibrations/Battery calibration.odt

Battery calibration.

Assuming 6V as fully drained battery and 8V as fully charged.

ADC | Voltage | Charge percent
2302 | 6.0 | 0
2381 | 6.2 | 10
2462 | 6.4 | 20
2553 | 6.6 | 30
2624 | 6.8 | 40
2706 | 7.0 | 50
2790 | 7.2 | 60
2871 | 7.4 | 70
2959 | 7.6 | 80
3036 | 7.8 | 90
3119 | 8.0 | 100

U = aX + b, where X is ADC measurement.

a= {Umax-Umin} over {Xmax-Xmin} b= {Umin cdot Xmax-Umax cdot Xmin} over {Xmax-Xmin}

For mine, pre-series exemplar, a = 0.002448, b=0.3647
