WhiteFossa/yiff-l/Hardware/Schematic v1/Calibrations/Power vs Upower.ods

Upower | Ur (p-p) | Urms | Pout | Iin | Pin | Efficiency
12 | 68 | 24.0416305603426 | 2.62727272727273 | 0.34 | 4.08 | 0.643939393939394
12.5 | 70 | 24.7487373415292 | 2.78409090909091 | 0.35 | 4.375 | 0.636363636363636
13 | 72 | 25.4558441227157 | 2.94545454545455 | 0.36 | 4.68 | 0.629370629370629
13.5 | 74 | 26.1629509039023 | 3.11136363636364 | 0.36 | 4.86 | 0.640198279087168
14 | 76 | 26.8700576850888 | 3.28181818181818 | 0.37 | 5.18 | 0.633555633555633
14.5 | 78 | 27.5771644662754 | 3.45681818181818 | 0.38 | 5.51 | 0.627371720838145
15 | 80 | 28.2842712474619 | 3.63636363636364 | 0.38 | 5.7 | 0.637958532695375
15.5 | 82 | 28.9913780286484 | 3.82045454545455 | 0.4 | 6.2 | 0.616202346041056
16 | 82 | 28.9913780286484 | 3.82045454545455 | 0.4 | 6.4 | 0.596946022727273
16.5 | 84 | 29.698484809835 | 4.00909090909091 | 0.4 | 6.6 | 0.607438016528926
17 | 86 | 30.4055915910215 | 4.20227272727273 | 0.41 | 6.97 | 0.602908569192644
17.5 | 86 | 30.4055915910215 | 4.20227272727273 | 0.41 | 7.175 | 0.585682610072854
18 | 88 | 31.1126983722081 | 4.4 | 0.42 | 7.56 | 0.582010582010582
18.5 | 90 | 31.8198051533946 | 4.60227272727273 | 0.42 | 7.77 | 0.592313092313092
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
