WhiteFossa/yiff-l/Hardware/Schematic v1/Full schematic/Full schematic.pdf

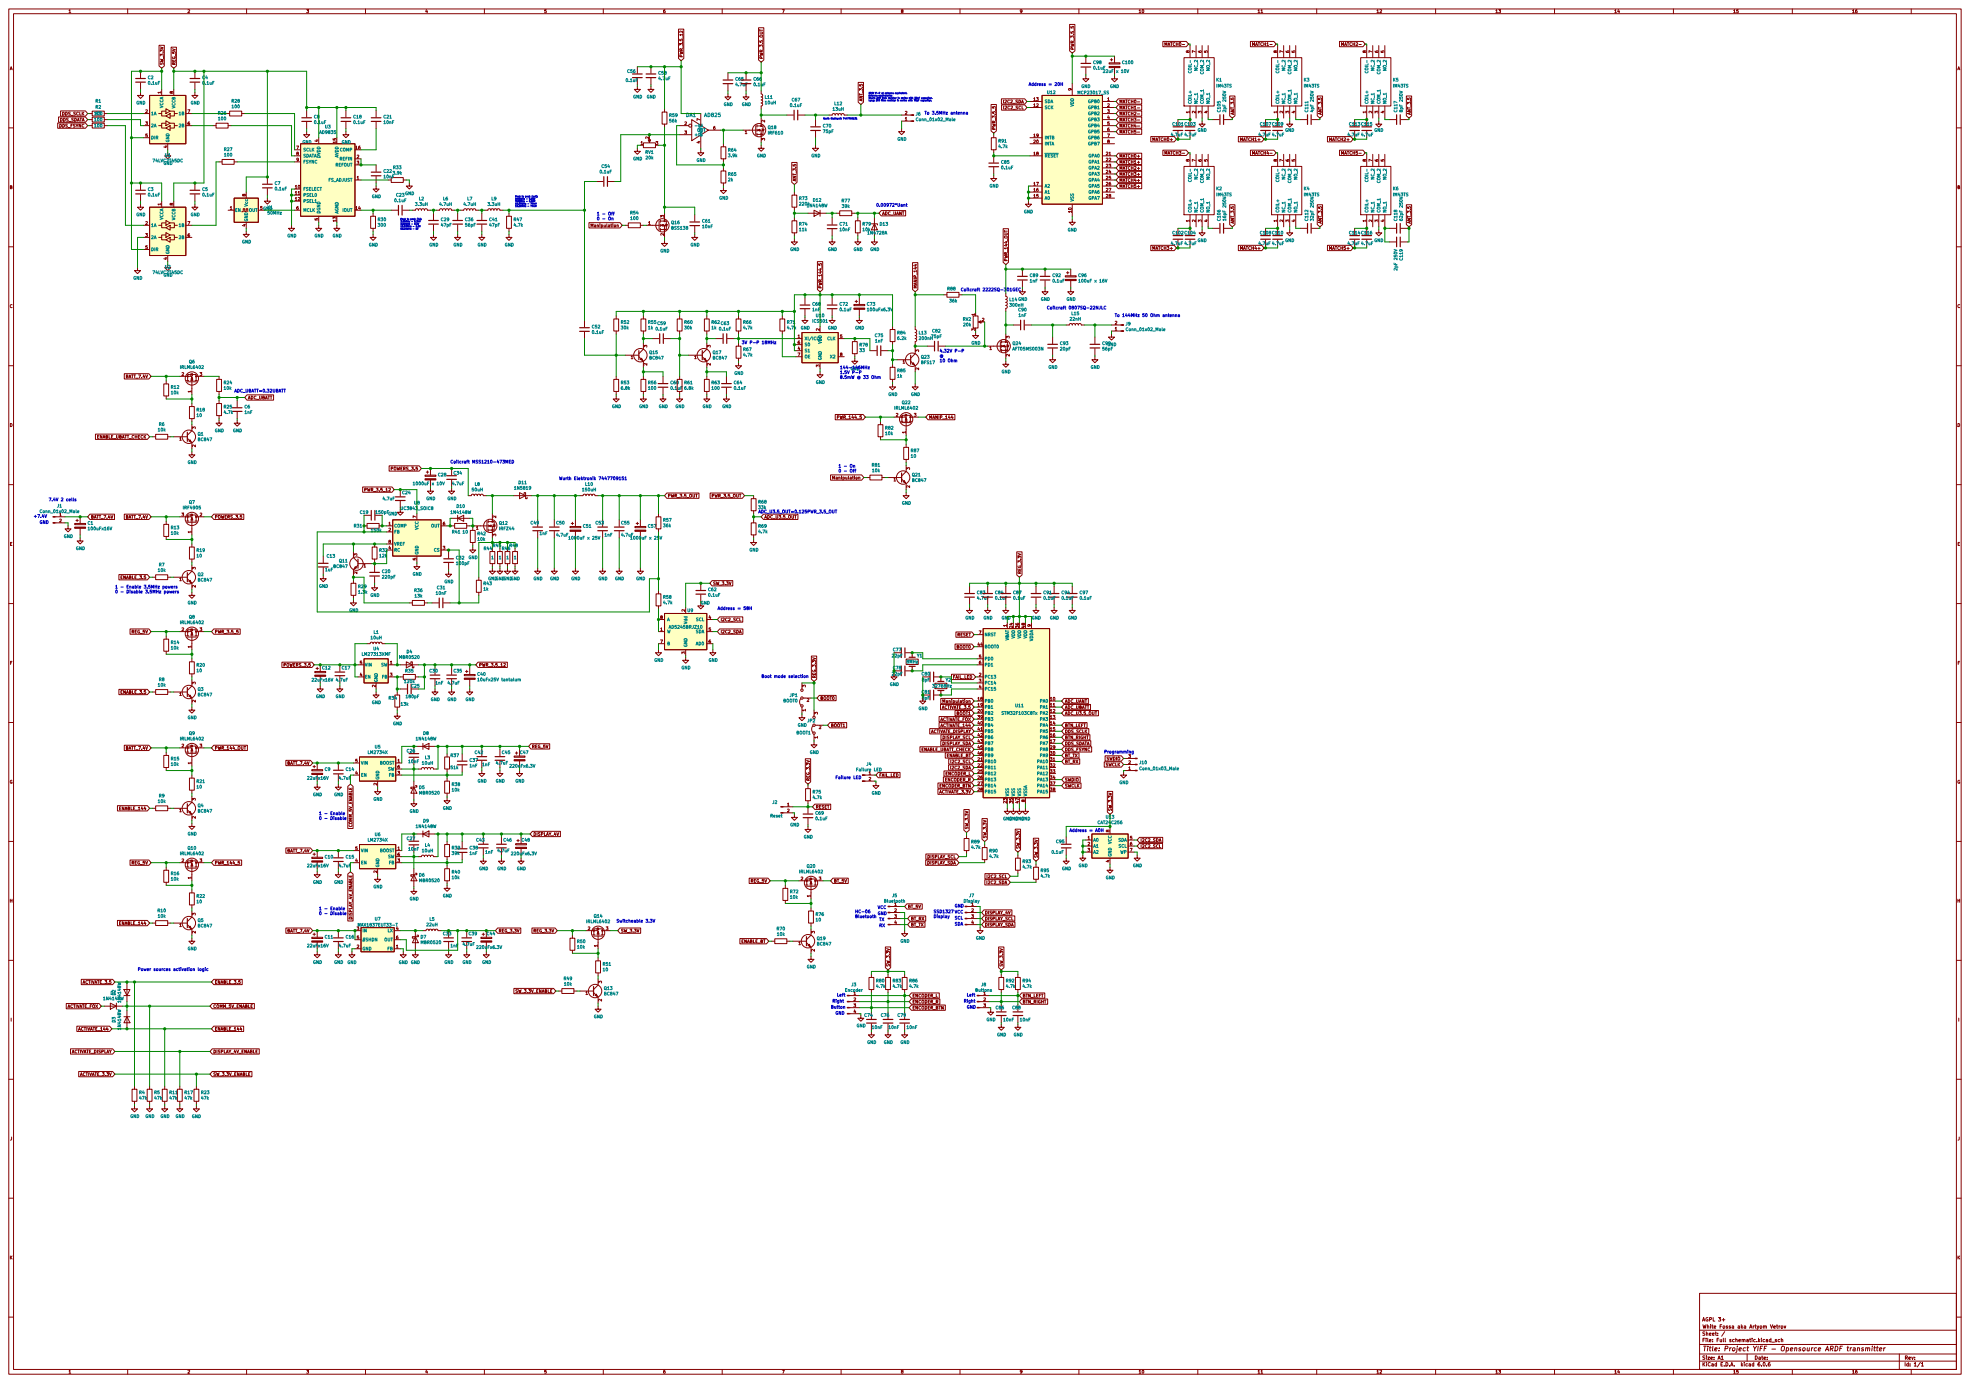
[picture p14: page 1]

5 MCLK 6 SCLK 7 SDATA 8 FSYNC 9 U3 AD9835 C8

To 3.5MHz antenna Wurth Elektronik 7447709151

Peak to peak (out): 3.50MHz - 0.96V

Peak to peak (in): 3.50MHz - 0.34V

2 FB 3 EN 4 VIN 5 SW 6 U5
ENABLE_BT COMM_5V_ENABLE

2 FB 3 EN 4 VIN 5 SW 6 U6

File: Full schematic.kicad_sch Sheet: / White Fossa aka Artyom Vetrov AGPL 3+

Id: 1/1 Title: Project YIFF - Opensource ARDF transmitter
