WhiteFossa/yiff-l/Hardware/Schematic v0/Full schematic/Full schematic.pdf

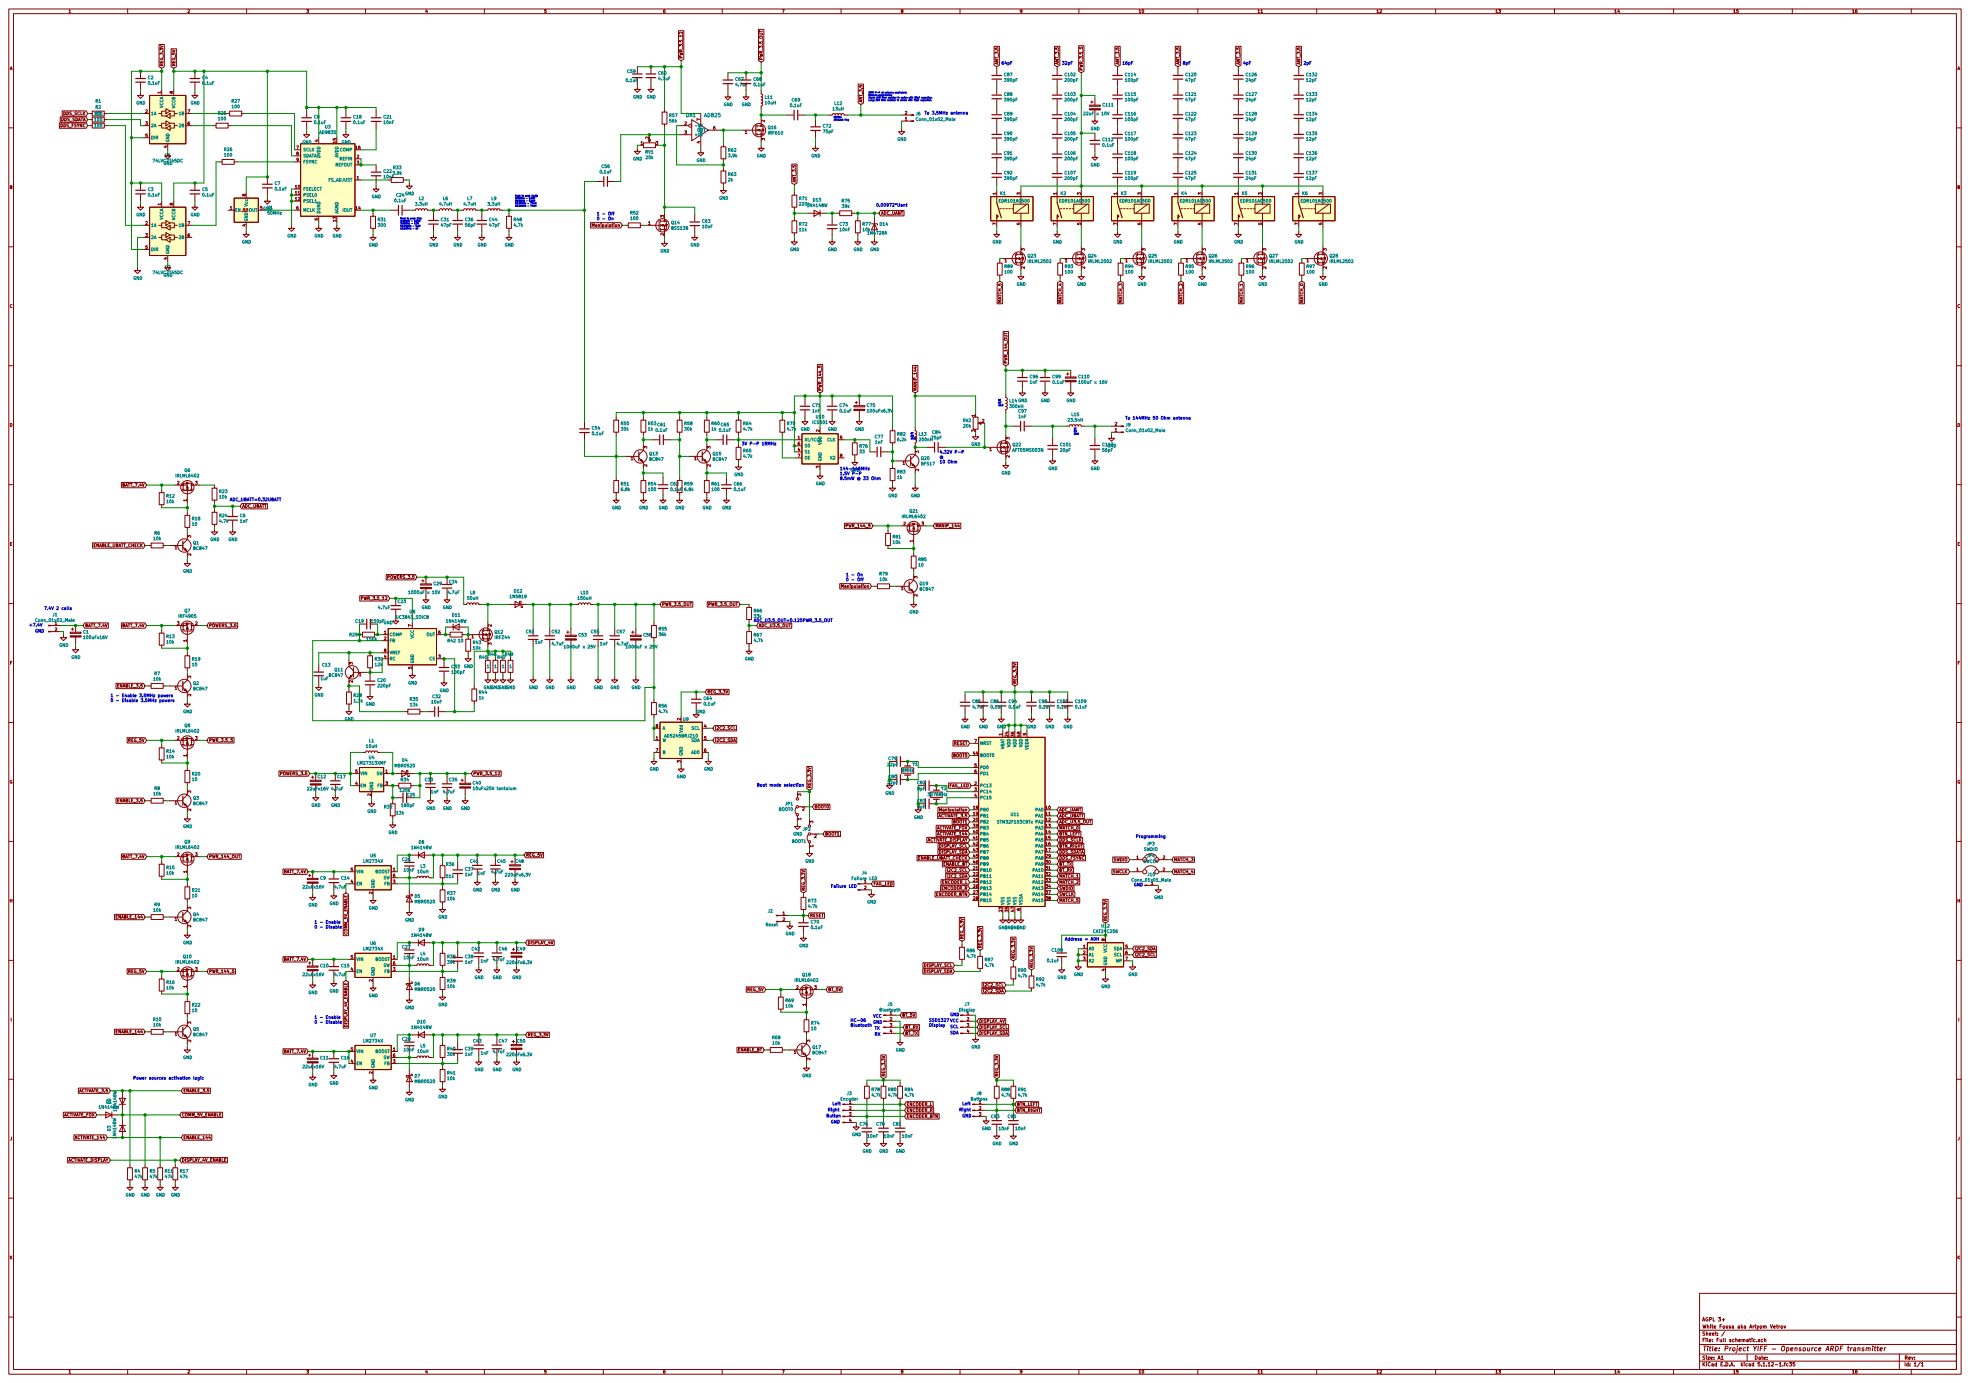
[picture p15: page 1]

Peak to peak (out): 3.50MHz - 0.96V

Peak to peak (in): 3.50MHz - 0.34V

Id: 1/1 Title: Project YIFF - Opensource ARDF transmitter File: Full schematic.sch Sheet: / White Fossa aka Artyom Vetrov AGPL 3+
