WhiteFossa/yiff-l/Hardware/Old/Prototype 1/Full schematic/Full schematic.pdf

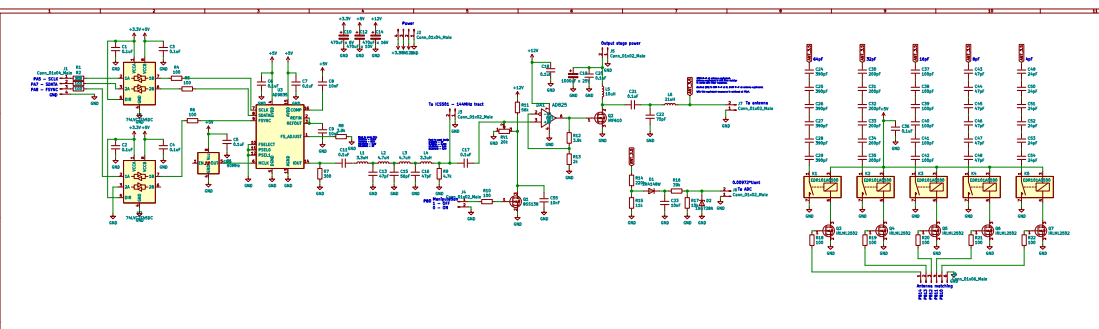
[picture p16: page 1]

200V P-P at antenna equivalent. Antenna equivalent is 240 Ohm resistor

5 MCLK 6 SCLK 7 SDATA 8 FSYNC 9 U3 AD9835 R18

Id: 1/1 Title: File: Full schematic.sch Sheet: /
