WhiteFossa/yiff-l/Hardware/Prototype 2/Full schematic/Full schematic.kicad_pcb

## KiCad design Hardware/Prototype 2/Full schematic/Full schematic.kicad_pcb (2021-03-25, an earlier design)

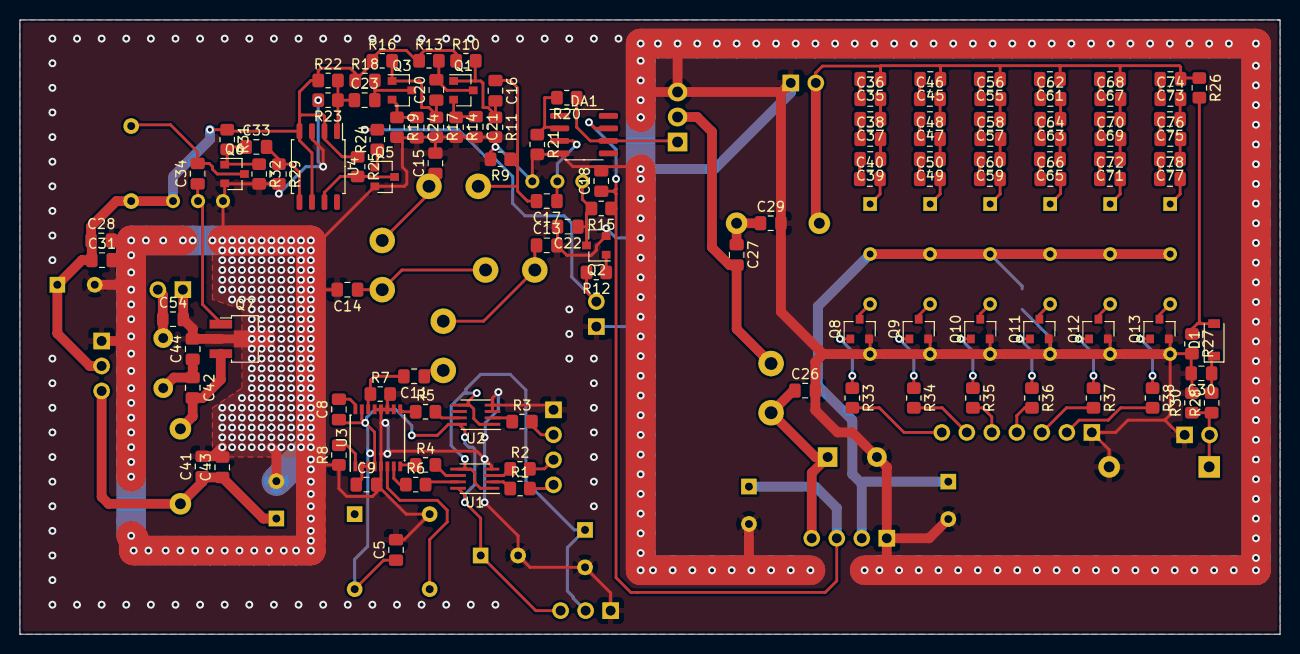
[picture p29: board Hardware/Prototype 2/Full schematic/Full schematic.kicad_pcb from above]

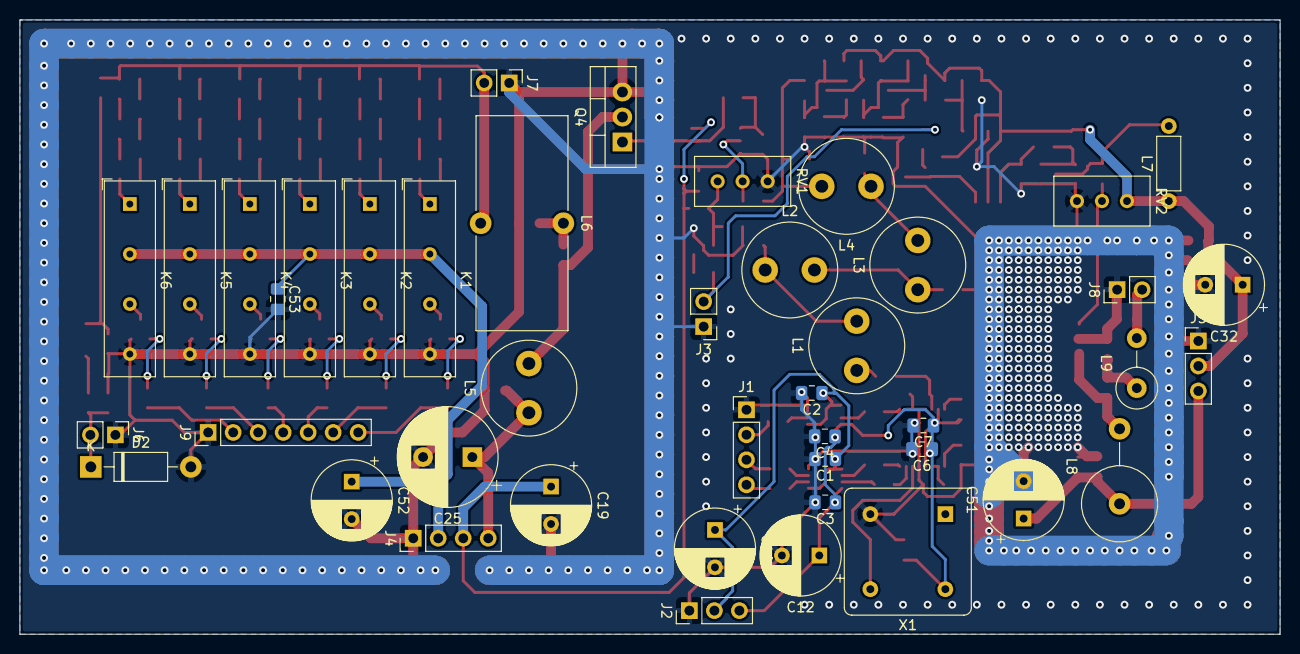
[picture p30: board Hardware/Prototype 2/Full schematic/Full schematic.kicad_pcb from below]

Board: 2 copper layers, 128.0 x 62.4 mm, 163 parts (43 on the bottom side), 112 nets.

Parts:
C1, C2, C3, C4, C5, C6, C7, C11, C16, C17, C18, C20, C21, C23, C24, C26, C27, C31, C43, C53: 0.1uF; C_0805_2012Metric_Pad1.18x1.45mm_HandSolder
C8, C9, C22, C30: 10nF; C_0805_2012Metric_Pad1.18x1.45mm_HandSolder
C10: 470uF x 6V; CP_Radial_D8.0mm_P3.80mm
C12, C51: 470uF x 10V; CP_Radial_D8.0mm_P3.80mm
C13, C15, C61, C62, C63, C64, C65, C66: 47pF; C_0805_2012Metric_Pad1.18x1.45mm_HandSolder
C14, C54: 56pF; C_0805_2012Metric_Pad1.18x1.45mm_HandSolder
C19: 470uFx16V; CP_Radial_D8.0mm_P3.80mm
C25: 1000uF x 25V; CP_Radial_D10.0mm_P5.00mm
C28, C33, C41, C42: 1nF; C_0805_2012Metric_Pad1.18x1.45mm_HandSolder
C29, C34: 75pF; C_0805_2012Metric_Pad1.18x1.45mm_HandSolder
C32, C52: 470uFx6.3V; CP_Radial_D8.0mm_P3.80mm
C35, C36, C37, C38, C39, C40: 390pF; C_0805_2012Metric_Pad1.18x1.45mm_HandSolder
C44: 20pF; C_0805_2012Metric_Pad1.18x1.45mm_HandSolder
C45, C46, C47, C48, C49, C50: 200pF; C_0805_2012Metric_Pad1.18x1.45mm_HandSolder
C55, C56, C57, C58, C59, C60: 100pF; C_0805_2012Metric_Pad1.18x1.45mm_HandSolder
C67, C68, C69, C70, C71, C72: 24pF; C_0805_2012Metric_Pad1.18x1.45mm_HandSolder
C73, C74, C75, C76, C77, C78: 12pF; C_0805_2012Metric_Pad1.18x1.45mm_HandSolder
D1: 1N4148W; D_SOD-123
D2: 1N4728A; D_DO-41_SOD81_P10.16mm_Horizontal
DA1: AD825; SOIC-8_3.9x4.9mm_P1.27mm
J1, J4: Conn_01x04_Male; PinHeader_1x04_P2.54mm_Vertical
J2, J5: Conn_01x03_Male; PinHeader_1x03_P2.54mm_Vertical
J3, J6, J7, J8: Conn_01x02_Male; PinHeader_1x02_P2.54mm_Vertical
J9: Conn_01x07_Male; PinHeader_1x07_P2.54mm_Vertical
K1, K2, K3, K4, K5, K6: EDR101A0500; Relay_SPST_StandexMeder_SIL_Form1A
L1, L4: 3.3uH; L_Radial_D9.5mm_P5.00mm_Fastron_07HVP
L2, L3: 4.7uH; L_Radial_D9.5mm_P5.00mm_Fastron_07HVP
L5: 10uH; L_Radial_D9.5mm_P5.00mm_Fastron_07HVP
L6: 21uH; L_Toroid_Vertical_L21.6mm_W9.1mm_P8.40mm_Bourns_5700
L7: 200nH; L_Axial_L5.3mm_D2.2mm_P7.62mm_Horizontal_Vishay_IM-1
L8: 300nH; L_Axial_L16.0mm_D7.5mm_P7.62mm_Vertical_Fastron_XHBCC
L9: 23.5nH; L_Axial_L9.5mm_D4.0mm_P5.08mm_Vertical_Fastron_SMCC
Q1, Q3: BC847; SOT-23
Q2, Q5: BSS138; SOT-23
Q4: IRF610; TO-220-3_Vertical
Q6: BFS17; SOT-23
Q7: AFT05MS003N; SOT-89-3_Handsoldering
Q8, Q9, Q10, Q11, Q12, Q13: IRLML2502; SOT-23
R1, R2, R3, R4, R5, R6, R12, R14, R19, R24, R33, R34, R35, R36, R37, R38: 100; R_0805_2012Metric_Pad1.20x1.40mm_HandSolder
R7: 300; R_0805_2012Metric_Pad1.20x1.40mm_HandSolder
R8, R20: 3.9k; R_0805_2012Metric_Pad1.20x1.40mm_HandSolder
R9, R22, R23: 4.7k; R_0805_2012Metric_Pad1.20x1.40mm_HandSolder
R10, R16: 30k; R_0805_2012Metric_Pad1.20x1.40mm_HandSolder
R11, R17: 6.8k; R_0805_2012Metric_Pad1.20x1.40mm_HandSolder
R13, R18, R32: 1k; R_0805_2012Metric_Pad1.20x1.40mm_HandSolder
R15: 56k; R_0805_2012Metric_Pad1.20x1.40mm_HandSolder
R21: 2k; R_0805_2012Metric_Pad1.20x1.40mm_HandSolder
R25: 47k; R_0805_2012Metric_Pad1.20x1.40mm_HandSolder
R26: 220k; R_0805_2012Metric_Pad1.20x1.40mm_HandSolder
R27: 11k; R_0805_2012Metric_Pad1.20x1.40mm_HandSolder
R28: 39k; R_0805_2012Metric_Pad1.20x1.40mm_HandSolder
R29: 33; R_0805_2012Metric_Pad1.20x1.40mm_HandSolder
R30: 10k; R_0805_2012Metric_Pad1.20x1.40mm_HandSolder
R31: 6.2k; R_0805_2012Metric_Pad1.20x1.40mm_HandSolder
RV1, RV2: 20k; Potentiometer_Bourns_3386C_Horizontal
U1, U2: 74LVC2T45DC; SSOP-8_2.95x2.8mm_P0.65mm
U3: AD9835; SSOP-16_4.4x5.2mm_P0.65mm
U4: ICS501; SOIC-8_5.23x5.23mm_P1.27mm
X1: 50MHz; Oscillator_DIP-8

Connections:
ANT_3.5: C35.1, C45.1, C55.1, C61.1, C67.1, C73.1, J7.2, L6.2, R26.1
GND: C1.2, C2.2, C3.2, C4.2, C5.2, C6.2, C7.2, C9.2, C10.2, C12.2, C13.2, C14.2, C15.2, C18.2, C19.2, C21.2, C22.2, C24.2, C25.2, C26.2, C28.2, C29.2, C30.2, C31.2, C32.2, C41.2, C43.2, C44.2, C51.2, C52.2, C53.2, C54.2, D2.2, DA1.4, J1.1, J2.1, J3.1, J4.1, J5.1, J6.1, J7.1, J8.1, J9.1, K1.7, K2.7, K3.7, K4.7, K5.7, K6.7, Q2.2, Q4.3, Q5.2, Q6.2, Q7.2, Q8.2, Q9.2, Q10.2, Q11.2, Q12.2, Q13.2, R7.2, R8.1, R9.2, R11.2, R14.2, R17.2, R19.2, R21.2, R23.2, R27.2, R29.2, R30.2, R32.2, RV1.1, RV2.3, U1.4, U2.3, U2.4, U3.5, U3.10, U3.11, U3.12, U3.13, U4.3, X1.4
Manipulation: J3.2, R12.2, R24.2
unnamed: C8.2, U3.16
unnamed: C9.1, U3.2, U3.3
unnamed: C11.1, L1.1
unnamed: C11.2, R7.1, U3.14
unnamed: C13.1, L1.2, L2.1
unnamed: C14.1, L2.2, L3.1
unnamed: C15.1, L3.2, L4.1
unnamed: C16.1, C17.2, L4.2, R9.1
unnamed: C16.2, Q1.1, R10.2, R11.1
unnamed: C17.1, DA1.3, RV1.2
unnamed: C20.1, Q3.1, R16.2, R17.1
unnamed: C20.2, Q1.3, R13.2
unnamed: C21.1, Q1.2, R14.1
unnamed: C22.1, Q2.3, R15.2, RV1.3
unnamed: C23.1, R22.2, R23.1, U4.1
unnamed: C23.2, Q3.3, R18.2
unnamed: C24.1, Q3.2, R19.1
unnamed: C27.1, C29.1, L6.1
unnamed: C27.2, L5.2, Q4.2
unnamed: C30.1, D1.1, R28.2
unnamed: C33.1, Q6.1, R31.2, R32.1
unnamed: C33.2, R29.1, U4.5
unnamed: C34.1, Q7.1, RV2.2
unnamed: C34.2, L7.2, Q6.3
unnamed: C35.2, C36.1
unnamed: C36.2, C37.1
unnamed: C37.2, C38.1
unnamed: C38.2, C39.1
unnamed: C39.2, C40.1
unnamed: C40.2, K1.1
unnamed: C42.1, C44.1, L9.1
unnamed: C42.2, L8.2, Q7.3
unnamed: C45.2, C46.1
unnamed: C46.2, C47.1
unnamed: C47.2, C48.1
unnamed: C48.2, C49.1
unnamed: C49.2, C50.1
unnamed: C50.2, K2.1
unnamed: C54.1, J8.2, L9.2
unnamed: C55.2, C56.1
unnamed: C56.2, C57.1
unnamed: C57.2, C58.1
unnamed: C58.2, C59.1
unnamed: C59.2, C60.1
unnamed: C60.2, K3.1
unnamed: C61.2, C62.1
unnamed: C62.2, C63.1
unnamed: C63.2, C64.1
unnamed: C64.2, C65.1
unnamed: C65.2, C66.1
unnamed: C66.2, K4.1
unnamed: C67.2, C68.1
unnamed: C68.2, C69.1
unnamed: C69.2, C70.1
unnamed: C70.2, C71.1
unnamed: C71.2, C72.1
unnamed: C72.2, K5.1
unnamed: C73.2, C74.1
unnamed: C74.2, C75.1
unnamed: C75.2, C76.1
unnamed: C76.2, C77.1
unnamed: C77.2, C78.1
unnamed: C78.2, K6.1
unnamed: D1.2, R26.2, R27.1
unnamed: D2.1, J6.2, R28.1, R30.1
unnamed: DA1.2, R20.2, R21.1
unnamed: DA1.6, Q4.1, R20.1
unnamed: J1.2, R3.2
unnamed: J1.3, R2.2
unnamed: J1.4, R1.2
unnamed: J9.2, R38.2
unnamed: J9.3, R37.2
unnamed: J9.4, R36.2
unnamed: J9.5, R35.2
unnamed: J9.6, R34.2
unnamed: J9.7, R33.2
unnamed: K1.5, Q8.3
unnamed: K2.5, Q9.3
unnamed: K3.5, Q10.3
unnamed: K4.5, Q11.3
unnamed: K5.5, Q12.3
unnamed: K6.5, Q13.3
unnamed: Q2.1, R12.1
unnamed: Q5.1, R24.1
unnamed: Q5.3, R25.2, U4.7
unnamed: Q8.1, R33.1
unnamed: Q9.1, R34.1
unnamed: Q10.1, R35.1
unnamed: Q11.1, R36.1
unnamed: Q12.1, R37.1
unnamed: Q13.1, R38.1
unnamed: R1.1, U1.2
unnamed: R2.1, U1.3
unnamed: R3.1, U2.2
unnamed: R4.1, U3.8
unnamed: R4.2, U1.6
unnamed: R5.1, U3.9
unnamed: R5.2, U2.7
unnamed: R6.1, U3.7
unnamed: R6.2, U1.7
unnamed: R8.2, U3.1
unnamed: U3.6, X1.5
PWR_3.5_5: C52.1, C53.1, J4.2, K1.3, K2.3, K3.3, K4.3, K5.3, K6.3
PWR_3.5_12: C18.1, C19.1, DA1.7, J4.3, R15.1
PWR_3.5_OUT: C25.1, C26.1, J4.4, L5.1
PWR_144_5: C28.1, C31.1, C32.1, J5.2, L7.1, R10.1, R13.1, R16.1, R18.1, R22.1, R25.1, R31.1, RV2.1, U4.2, U4.4, U4.6
PWR_144_OUT: C41.1, C43.1, C51.1, J5.3, L8.1
PWR_CMN_3.3: C1.1, C2.1, C10.1, J2.2, U1.1, U1.5, U2.1, U2.5
PWR_CMN_5: C3.1, C4.1, C5.1, C6.1, C7.1, C8.1, C12.1, J2.3, U1.8, U2.8, U3.4, U3.15, X1.8
