WhiteFossa/yiff-l/Hardware/Prototype 1/Full schematic/Full schematic.kicad_pcb

## KiCad design Hardware/Prototype 1/Full schematic/Full schematic.kicad_pcb (2021-01-17, an earlier design)

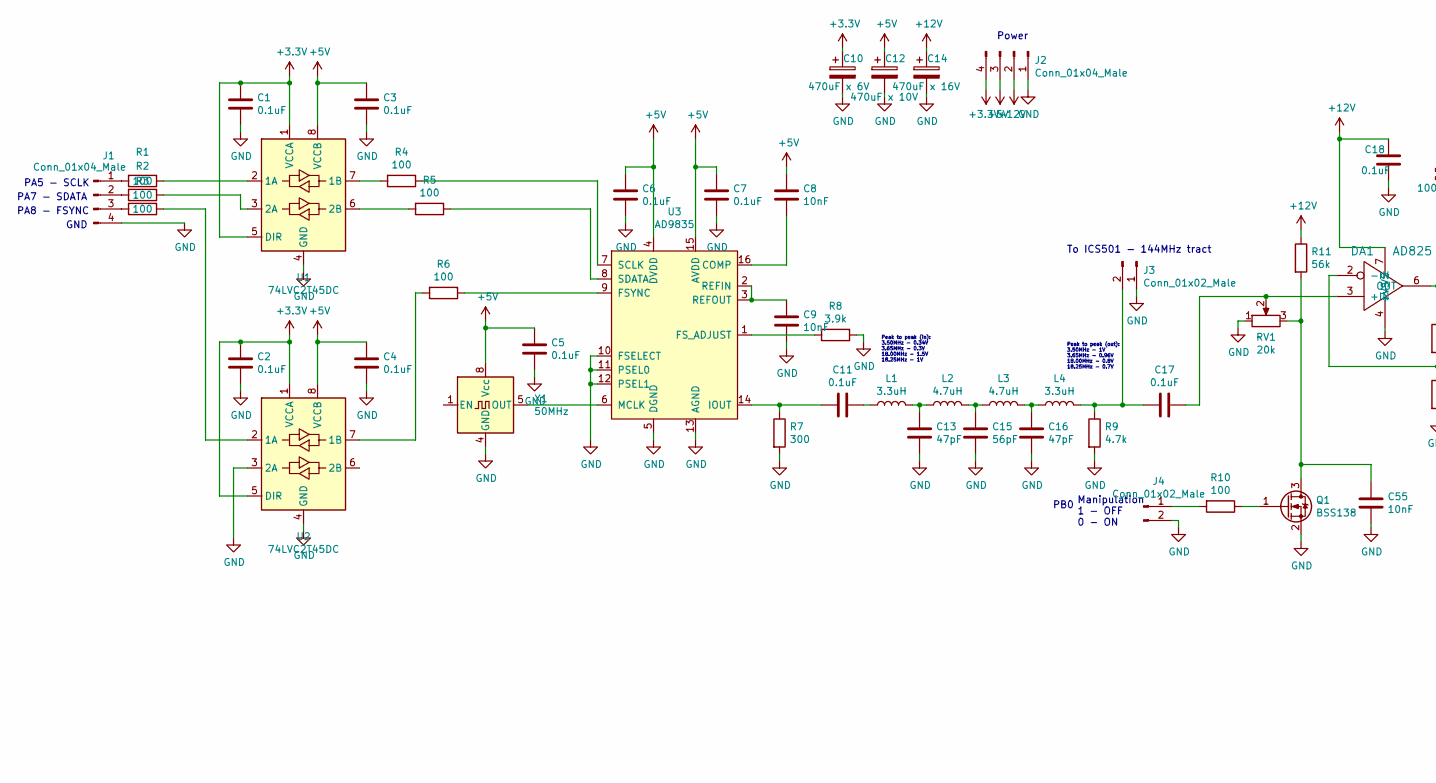
[picture p31: schematic Full schematic.sch, part in row 1, column 1]

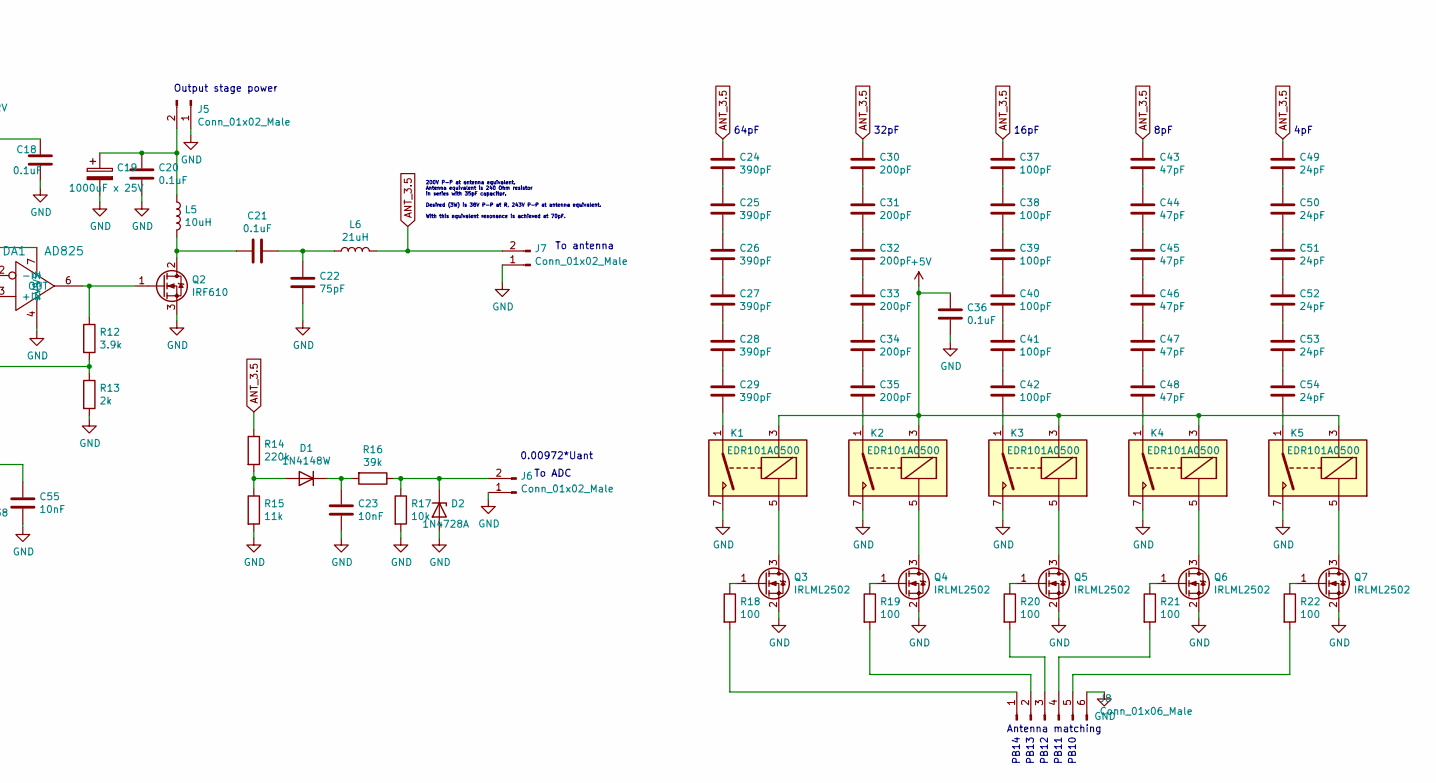
[picture p32: schematic Full schematic.sch, part in row 1, column 2]

Parts:
C1, C2, C3, C4, C5, C6, C7, C11, C17, C18, C20, C21, C36: 0.1uF; C_0805_2012Metric_Pad1.18x1.45mm_HandSolder
C8, C9, C23, C55: 10nF; C_0805_2012Metric_Pad1.18x1.45mm_HandSolder
C10: 470uF x 6V; CP_Radial_D10.0mm_P5.00mm
C12: 470uF x 10V; CP_Radial_D10.0mm_P5.00mm
C13, C16, C43, C44, C45, C46, C47, C48: 47pF; C_0805_2012Metric_Pad1.18x1.45mm_HandSolder
C14: 470uF x 16V; CP_Radial_D10.0mm_P5.00mm
C15: 56pF; C_0805_2012Metric_Pad1.18x1.45mm_HandSolder
C19: 1000uF x 25V; CP_Radial_D14.0mm_P7.50mm
C22: 75pF; C_0805_2012Metric_Pad1.18x1.45mm_HandSolder
C24, C25, C26, C27, C28, C29: 390pF; C_0805_2012Metric_Pad1.18x1.45mm_HandSolder
C30, C31, C32, C33, C34, C35: 200pF; C_0805_2012Metric_Pad1.18x1.45mm_HandSolder
C37, C38, C39, C40, C41, C42: 100pF; C_0805_2012Metric_Pad1.18x1.45mm_HandSolder
C49, C50, C51, C52, C53, C54: 24pF; C_0805_2012Metric_Pad1.18x1.45mm_HandSolder
D1: 1N4148W; D_SOD-123
D2: 1N4728A; D_DO-41_SOD81_P10.16mm_Horizontal
DA1: AD825; SOIC-8_3.9x4.9mm_P1.27mm
J1, J2: Conn_01x04_Male; PinHeader_1x04_P2.54mm_Vertical
J3, J4, J5, J6, J7: Conn_01x02_Male; PinHeader_1x02_P2.54mm_Vertical
J8: Conn_01x06_Male; PinHeader_1x06_P2.54mm_Vertical
K1, K2, K3, K4, K5: EDR101A0500; Relay_SPST_StandexMeder_SIL_Form1A
L1, L4: 3.3uH; L_Radial_D9.5mm_P5.00mm_Fastron_07HVP
L2, L3: 4.7uH; L_Radial_D9.5mm_P5.00mm_Fastron_07HVP
L5: 10uH; L_Radial_D9.5mm_P5.00mm_Fastron_07HVP
L6: 21uH; L_Radial_D9.5mm_P5.00mm_Fastron_07HVP
Q1: BSS138; SOT-23
Q2: IRF610; TO-220-3_Horizontal_TabDown
Q3, Q4, Q5, Q6, Q7: IRLML2502; SOT-23
R1, R2, R3, R4, R5, R6, R10, R18, R19, R20, R21, R22: 100; R_0805_2012Metric_Pad1.20x1.40mm_HandSolder
R7: 300; R_0805_2012Metric_Pad1.20x1.40mm_HandSolder
R8, R12: 3.9k; R_0805_2012Metric_Pad1.20x1.40mm_HandSolder
R9: 4.7k; R_0805_2012Metric_Pad1.20x1.40mm_HandSolder
R11: 56k; R_0805_2012Metric_Pad1.20x1.40mm_HandSolder
R13: 2k; R_0805_2012Metric_Pad1.20x1.40mm_HandSolder
R14: 220k; R_0805_2012Metric_Pad1.20x1.40mm_HandSolder
R15: 11k; R_0805_2012Metric_Pad1.20x1.40mm_HandSolder
R16: 39k; R_0805_2012Metric_Pad1.20x1.40mm_HandSolder
R17: 10k; R_0805_2012Metric_Pad1.20x1.40mm_HandSolder
RV1: 20k; Potentiometer_Bourns_3386C_Horizontal
U1, U2: 74LVC2T45DC; SSOP-8_3.9x5.05mm_P1.27mm
U3: AD9835; SSOP-16_4.4x5.2mm_P0.65mm
X1: 50MHz; Oscillator_DIP-8

Connections:
+3V3: C1.1, C2.1, C10.1, J2.4, U1.1 (VCCA), U1.5 (DIR), U2.1 (VCCA), U2.5 (DIR)
+5V: C3.1, C4.1, C5.1, C6.1, C7.1, C8.1, C12.1, C36.1, J2.3, K1.3, K2.3, K3.3, K4.3, K5.3, U1.8 (VCCB), U2.8 (VCCB), U3.4 (DVDD), U3.15 (AVDD), X1.8 (Vcc)
+12V: C14.1, C18.1, DA1.7 (+VS), J2.2, R11.1
ANT_3.5: C24.1, C30.1, C37.1, C43.1, C49.1, J7.2, L6.2, R14.1
GND: C1.2, C2.2, C3.2, C4.2, C5.2, C6.2, C7.2, C9.2, C10.2, C12.2, C13.2, C14.2, C15.2, C16.2, C18.2, C19.2, C20.2, C22.2, C23.2, C36.2, C55.2, D2.2 (A), DA1.4 (-VS), J1.4, J2.1, J3.1, J4.2, J5.1, J6.1, J7.1, J8.6, K1.7, K2.7, K3.7, K4.7, K5.7, Q1.2 (S), Q2.3 (S), Q3.2 (S), Q4.2 (S), Q5.2 (S), Q6.2 (S), Q7.2 (S), R7.2, R8.1, R9.2, R13.2, R15.2, R17.2, RV1.1, U1.4 (GND), U2.3 (2A), U2.4 (GND), U3.5 (DGND), U3.10 (FSELECT), U3.11 (PSEL0), U3.12 (PSEL1), U3.13 (AGND), X1.4 (GND)
unnamed: C8.2, U3.16 (COMP)
unnamed: C9.1, U3.2 (REFIN), U3.3 (REFOUT)
unnamed: C11.1, L1.1
unnamed: C11.2, R7.1, U3.14 (IOUT)
unnamed: C13.1, L1.2, L2.1
unnamed: C15.1, L2.2, L3.1
unnamed: C16.1, L3.2, L4.1
unnamed: C17.1, DA1.3 (+IN), RV1.2
unnamed: C17.2, J3.2, L4.2, R9.1
unnamed: C19.1, C20.1, J5.2, L5.1
unnamed: C21.1, C22.1, L6.1
unnamed: C21.2, L5.2, Q2.2 (D)
unnamed: C23.1, D1.1 (K), R16.2
unnamed: C24.2, C25.1
unnamed: C25.2, C26.1
unnamed: C26.2, C27.1
unnamed: C27.2, C28.1
unnamed: C28.2, C29.1
unnamed: C29.2, K1.1
unnamed: C30.2, C31.1
unnamed: C31.2, C32.1
unnamed: C32.2, C33.1
unnamed: C33.2, C34.1
unnamed: C34.2, C35.1
unnamed: C35.2, K2.1
unnamed: C37.2, C38.1
unnamed: C38.2, C39.1
unnamed: C39.2, C40.1
unnamed: C40.2, C41.1
unnamed: C41.2, C42.1
unnamed: C42.2, K3.1
unnamed: C43.2, C44.1
unnamed: C44.2, C45.1
unnamed: C45.2, C46.1
unnamed: C46.2, C47.1
unnamed: C47.2, C48.1
unnamed: C48.2, K4.1
unnamed: C49.2, C50.1
unnamed: C50.2, C51.1
unnamed: C51.2, C52.1
unnamed: C52.2, C53.1
unnamed: C53.2, C54.1
unnamed: C54.2, K5.1
unnamed: C55.1, Q1.3 (D), R11.2, RV1.3
unnamed: D1.2 (A), R14.2, R15.1
unnamed: D2.1 (K), J6.2, R16.1, R17.1
unnamed: DA1.2 (-IN), R12.2, R13.1
unnamed: DA1.6 (OUT), Q2.1 (G), R12.1
unnamed: J1.1, R1.2
unnamed: J1.2, R2.2
unnamed: J1.3, R3.2
unnamed: J4.1, R10.2
unnamed: J8.1, R18.2
unnamed: J8.2, R19.2
unnamed: J8.3, R20.2
unnamed: J8.4, R21.2
unnamed: J8.5, R22.2
unnamed: K1.5, Q3.3 (D)
unnamed: K2.5, Q4.3 (D)
unnamed: K3.5, Q5.3 (D)
unnamed: K4.5, Q6.3 (D)
unnamed: K5.5, Q7.3 (D)
unnamed: Q1.1 (G), R10.1
unnamed: Q3.1 (G), R18.1
unnamed: Q4.1 (G), R19.1
unnamed: Q5.1 (G), R20.1
unnamed: Q6.1 (G), R21.1
unnamed: Q7.1 (G), R22.1
unnamed: R1.1, U1.2 (1A)
unnamed: R2.1, U1.3 (2A)
unnamed: R3.1, U2.2 (1A)
unnamed: R4.1, U3.7 (SCLK)
unnamed: R4.2, U1.7 (1B)
unnamed: R5.1, U3.8 (SDATA)
unnamed: R5.2, U1.6 (2B)
unnamed: R6.1, U3.9 (FSYNC)
unnamed: R6.2, U2.7 (1B)
unnamed: R8.2, U3.1 (FS_ADJUST)
unnamed: U3.6 (MCLK), X1.5 (OUT)

Notes on the sheet:
PA5 - SCLK
PA7 - SDATA
PA8 - FSYNC
GND
Peak to peak (in): 3.50MHz - 0.34V 3.65MHz - 0.3V 18.00MHz - 1.5V 18.25MHz - 1V
Peak to peak (out): 3.50MHz - 1V 3.65MHz - 0.96V 18.00MHz - 0.8V 18.25MHz - 0.7V
To antenna
Manipulation 1 - OFF 0 - ON
To ICS501 - 144MHz tract
Output stage power
200V P-P at antenna equivalent. Antenna equivalent is 240 Ohm resistor in series with 35pF capacitor. Desired (3W) is 38V P-P at R, 243V P-P at antenna equivalent. With this equivalent resonance is achieved at 70pF.
To ADC
0.00972*Uant
Antenna matching
Power
4pF
8pF
16pF
32pF
64pF
PB10
PB11
PB12
PB13
PB14
PB0

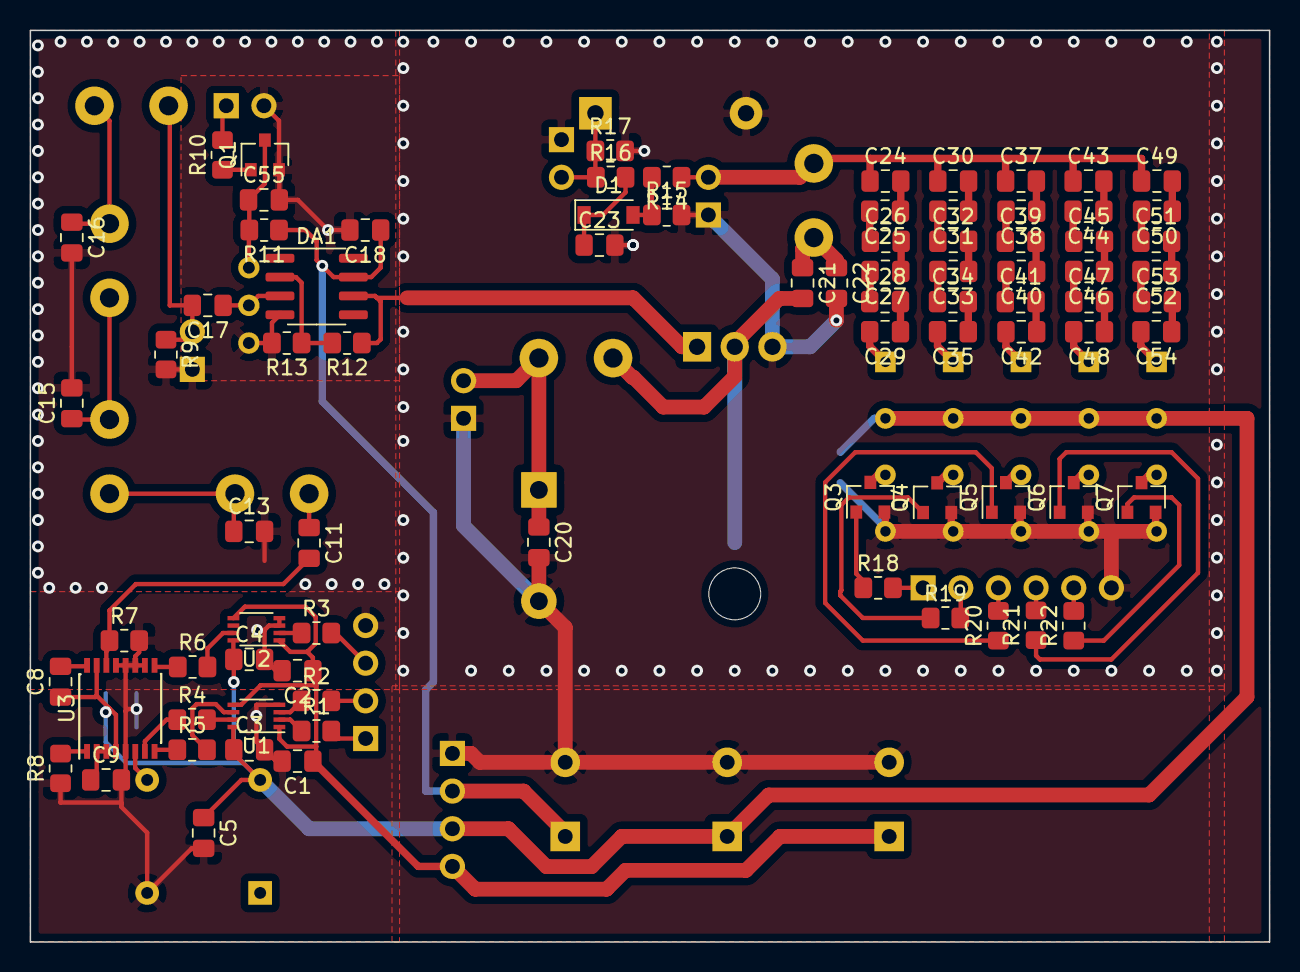
[picture p33: board Hardware/Prototype 1/Full schematic/Full schematic.kicad_pcb from above]

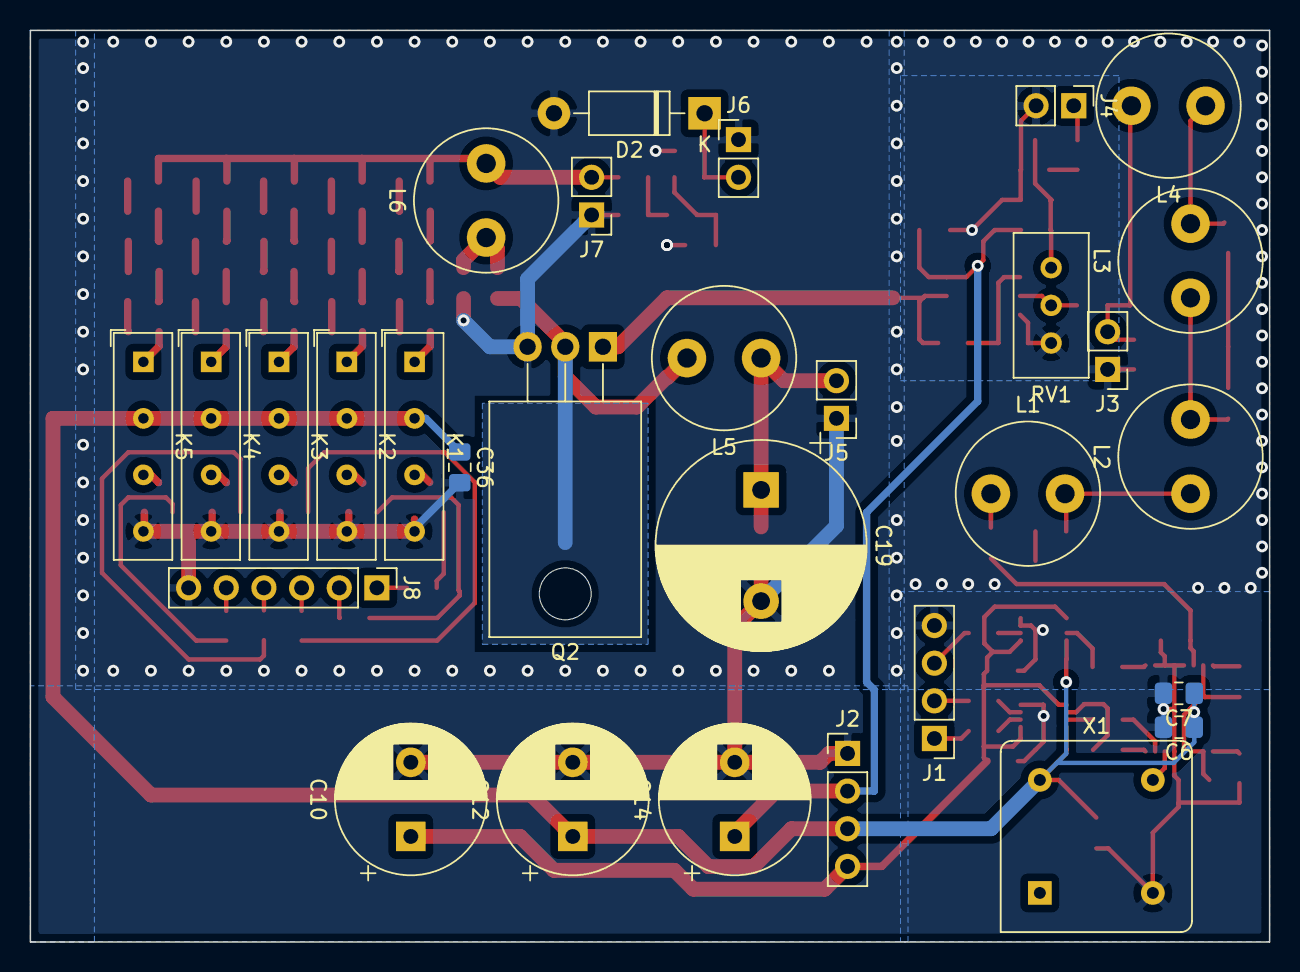
[picture p34: board Hardware/Prototype 1/Full schematic/Full schematic.kicad_pcb from below]

Board: 2 copper layers, 83.6 x 61.5 mm, 111 parts (30 on the bottom side), 84 nets.
