WhiteFossa/yiff-l/Firmware/yiff/include/MainPrivate.h

/*
 * MainPrivate.h
 *
 *  Created on: Oct 9, 2021
 *      Author: fossa
 */

#ifndef INCLUDE_MAINPRIVATE_H_
#define INCLUDE_MAINPRIVATE_H_


#include <stdint.h>
#include <l2hal.h>
#include <StatusDisplay.h>
#include <Buttons.h>
#include <RTC.h>
#include <GlobalStateMachine.h>
#include <CycleStateMachine.h>
#include <HAL.h>
#include <HardwareLogic.h>
#include <MorsePlayer.h>
#include <math.h>
#include <EEPROM.h>
#include <UART.h>
#include <PacketsProcessor.h>
#include <terminusRegular12.h>
#include <printf.h>
#include <GlobalVariables.h>
#include <Menu/MenuDisplay.h>
#include <Menu/ItemSelectionDisplay.h>
#include <Menu/InformationPopupDisplay.h>
#include <Menu/NumberInputDisplay.h>
#include <Menu/TimeInputDisplay.h>
#include <SelfDiagnostics.h>
#include <Sleepmodes.h>
#include <Random.h>
#include <Resources/boot_logo.h>
#include <AntennaMatcher.h>

/**
 * EEPROM-related stuff
 */
#define YHL_EEPROM_ADDRESS 0xA0
#define YHL_EEPROM_PAGE_SIZE 64

/**
 * Pause to let response to be transmitted before terminating bluetooth connection
 */
#define YHL_PAUSE_BEFORE_RENAMING_BLUETOOTH 100U

extern I2C_HandleTypeDef I2C_Display;
extern I2C_HandleTypeDef I2C_Other;
extern L2HAL_SSD1327_ContextStruct L2HAL_SSD1327_Context;
extern L2HAL_24x_ContextStruct EEPROMContext;
extern L2HAL_CRCContextStruct CRC_Context;
extern UART_HandleTypeDef UART_Handle;
extern L2HAL_HC06_ContextStruct HC06_Context;
extern FoxStateStruct FoxState;
extern PendingCommandsFlagsStruct PendingCommandsFlags;
extern uint8_t SwitchToThisProfileId;
extern char SetThisProfileName[YHL_PROFILE_NAME_MEMORY_SIZE];
extern HardwareControlsEventsStruct HardwareControlsEvents;
extern FMGL_API_XBMTransparencyMode transparencyMode;

/**
 * Checks if fox name changed and if so, then saves it into EEPROM and bluetooth module
 */
void Main_ProcessFoxNameChange(void);

/**
 * Checks if we need to add new profile and if so adds it.
 */
void Main_ProcessNewProfileAdd(void);

/**
 * Checks if we need to switch profile and if so - does it
 */
void Main_ProcessProfileSwitch(void);

/**
 * Checks if we need to set profile name and sets it if needed
 */
void Main_ProcessSetProfileName(void);

/**
 * Checks if we need to set frequency and sets it if needed
 */
void Main_ProcessSetFrequency(void);

/**
 * Updates fox code if we need to update it
 */
void Main_ProcessSetCode(void);

/**
 * Updates fox speed if needed
 */
void Main_ProcessSetSpeed(void);

/**
 * Updates fox cycle if needed
 */
void Main_ProcessSetCycle(void);

/**
 * Updates ending tone duration if needed
 */
void Main_ProcessSetEndingToneDuration(void);

/**
 * Updates start/end times if needed
 */
void Main_ProcessSetBeginAndEndTimes(void);

/**
 * Updates fox power if needed
 */
void Main_ProcessSetPower(void);

/**
 * Measures battery level and store it into fox state.
 */
void Main_MeasureBatteryLevel(void);

/**
 * Armes fox if needed
 */
void Main_ProcessFoxArming(void);

/**
 * Left button pressed event
 */
void Main_OnLeftButtonPressedInterrupt(void);
void Main_CheckLeftButtonPressedEvent(void);
void Main_OnLeftButtonPressed(void);

/**
 * Right button pressed event
 */
void Main_OnRightButtonPressedInterrupt(void);
void Main_CheckRightButtonPressedEvent(void);
void Main_OnRightButtonPressed(void);

/**
 * Encoder button pressed event
 */
void Main_OnEncoderButtonPressedInterrupt(void);
void Main_CheckEncoderButtonPressedEvent(void);
void Main_OnEncoderButtonPressed(void);

/**
 * Encoder rotation event
 */
void Main_OnEncoderRotationInterrupt(int8_t direction);
void Main_CheckEncoderRotationEvent(void);
void Main_OnEncoderRotation(int8_t direction);

/**
 * Call this to enter menu mode
 */
void Main_EnterMenu(void);

/**
 * Call this from main cycle to prevent fox sleeping in specific modes
 */
void Main_ControlSleep(void);

/**
 * Initialize display and show splash screen
 */
void Main_InitDisplayAndShowBootScreen(void);

/**
 * Common code for fox arming by command and by hands
 */
void Main_ProcessFoxArmingCommon(void);

/**
 * Resets last failure code if needed
 */
void Main_ProcessResetLastFailureCode(void);

/**
 * Updates fox serial number if needed
 */
void Main_ProcessSerialNumberUpdate(void);

/**
 * Updates Ubatt(ADC)->Ubatt(Volts) factors if needed
 */
void Main_ProcessSetUbattADCToUbattVoltsFactors(void);

/**
 * Updates Ubatt(Volts)->Battery level factors if needed
 */
void Main_ProcessSetUbattVoltsToBattLevelFactors(void);

/**
 * Updates U80m(ADC)->U80m(Volts) factors if needed
 */
void Main_ProcessSetU80mADCToU80mVoltsFactors(void);

/**
 * Updates P80m->U80m factors if needed
 */
void Main_ProcessSetP80mToU80mFactors(void);

/**
 * Updates Uant(ADC)->Uant(Volts) factors if needed
 */
void Main_ProcessSetUantADCToUantVoltsFactors(void);

/**
 * Activates forced TX (service mode) if needed
 */
void Main_ProcessForceTx(void);

/**
 * Deactivates forced TX (service mode) if needed
 */
void Main_ReturnFromForceTx(void);

/**
 * Sets RTC calibration value if needed
 */
void Main_SetRTCCalibrationValue(void);

/**
 * Sets disarm-on-discharge value if needed
 */
void Main_SetDisarmOnDischargeValue(void);

/**
 * As it name states, processes high priority events.
 */
void Main_ProcessHighPriorityEvents(void);

#endif /* INCLUDE_MAINPRIVATE_H_ */
