WhiteFossa/yiff-l/Firmware/yiff/src/EEPROM.c

/*
 * EEPROM.c
 *
 *  Created on: Apr 21, 2021
 *      Author: fossa
 */

#include <EEPROM.h>
#include <GlobalStateMachine.h>
#include <HardwareLogic.h>

void EEPROM_Format(void)
{
	/* Writing constant header*/
	EEPROMConstantHeaderStruct constantHeader;

	constantHeader.Version = YHL_EEPROM_DATA_VERSION;
	constantHeader.HeaderAddress = sizeof(EEPROMConstantHeaderStruct); /* Main header goes immediately after constant header */
	EEPROM_WriteConstantHeader(&constantHeader);

	/* Writing main header */
	EEPROMHeaderStruct defaultHeader;

	/* Fox name */
	/* Random digits to add to fox name */
	uint32_t foxNamePostfix = Rand_GetRandom() % YHL_DEFAULT_FOX_NAME_POSTFIX_MODULUS;
	snprintf(defaultHeader.Name, YHL_PROFILE_NAME_MEMORY_SIZE, YHL_DEFAULT_FOX_NAME_TEMPLATE, foxNamePostfix);

	defaultHeader.NumberOfProfiles = 1;

	/* Zero in profile address means "not allocated" */
	memset(defaultHeader.ProfilesAddresses, 0x00, YHL_MAX_PROFILES_COUNT * 2); /* *2 because each address is 2 bytes wide */
	defaultHeader.ProfileInUse = 0;
	defaultHeader.ProfilesAddresses[defaultHeader.ProfileInUse] = (uint16_t)(constantHeader.HeaderAddress + sizeof(EEPROMHeaderStruct)); /* First profile goes after header */

	/* Ubatt(ADC) -> Ubatt(Volts) */
	defaultHeader.UBattADCA = YHL_DEFAULT_ADC_UBATT_A;
	defaultHeader.UBattADCB = YHL_DEFAULT_ADC_UBATT_B;

	/* Ubatt(Volts) -> Battery level */
	defaultHeader.BattLevelA = YHL_DEFAULT_BATTERY_LEVEL_A;
	defaultHeader.BattLevelB = YHL_DEFAULT_BATTERY_LEVEL_B;

	/* U80m(ADC) -> U80m(Volts) */
	defaultHeader.U80mADCA = YHL_DEFAULT_ADC_U80M_A;
	defaultHeader.U80mADCB = YHL_DEFAULT_ADC_U80M_B;

	/* Factors for output power */
	defaultHeader.P80mA = YHL_DEFAULT_P80M_A;
	defaultHeader.P80mB = YHL_DEFAULT_P80M_B;

	/* Factors for antenna voltage */
	defaultHeader.UAntADCA = YHL_DEFAULT_ADC_UANT_A;
	defaultHeader.UAntADCB = YHL_DEFAULT_ADC_UANT_B;

	/* No failure after format */
	defaultHeader.LastFailure = YhlFailureCause_OK;

	/* Fox version information */
	defaultHeader.HardwareRevision = YHL_VER_HARDWARE_REVISION;
	defaultHeader.SoftwareVersion = YHL_VER_SOFTWARE_VERSION;
	defaultHeader.SerialNumber = Rand_GetRandom();

	/* RTC calibration */
	defaultHeader.RTCCalibrationValue = YHL_DEFAULT_RTC_CALIBRATION_VALUE;

	/* Disarm battery percent */
	defaultHeader.DisarmBatteryPercent = YHL_DEFAULT_DISARM_BATTERY_PERCENT;

	defaultHeader.CRCSum = 0;
	EEPROM_WriteHeader(&defaultHeader, constantHeader.HeaderAddress);

	EEPROM_ReadHeader(&defaultHeader, constantHeader.HeaderAddress);

	/* Regenerating default profile */
	EEPROMProfileStruct profile = EEPROM_GenerateDefaultProfile();
	EEPROM_WriteProfile(&profile, defaultHeader.ProfilesAddresses[defaultHeader.ProfileInUse]);

	/* Renaming bluetooth device because name was changed */
	HL_RenameBluetoothDevice(defaultHeader.Name);
}

void EEPROM_WriteConstantHeader(EEPROMConstantHeaderStruct* constantHeader)
{
	constantHeader->CRCSum = 0;
	constantHeader->CRCSum = L2HAL_CRC_Calculate(&CRC_Context, (uint8_t*)constantHeader, sizeof(EEPROMConstantHeaderStruct));
	L2HAL_24x_WriteData(&EEPROMContext, 0x00, (uint8_t*)constantHeader, sizeof(EEPROMConstantHeaderStruct));
}

void EEPROM_ReadConstantHeader(EEPROMConstantHeaderStruct* constantHeader)
{
	L2HAL_24x_ReadData(&EEPROMContext, 0x00, (uint8_t*)constantHeader, sizeof(EEPROMConstantHeaderStruct));
}

bool EEPROM_CheckConstantHeader(EEPROMConstantHeaderStruct* constantHeader)
{
	uint32_t existingCRC = constantHeader->CRCSum;
	constantHeader->CRCSum = 0;
	volatile uint32_t calculatedCRC = L2HAL_CRC_Calculate(&CRC_Context, (uint8_t*)constantHeader, sizeof(EEPROMConstantHeaderStruct));
	bool result = existingCRC == calculatedCRC;
	constantHeader->CRCSum = existingCRC;

	return result;
}

void EEPROM_WriteHeader(EEPROMHeaderStruct* header, uint16_t address)
{
	/* Calculating CRC for header with CRCSum = 0 */
	header->CRCSum = 0;
	header->CRCSum = L2HAL_CRC_Calculate(&CRC_Context, (uint8_t*)header, sizeof(EEPROMHeaderStruct));

	L2HAL_24x_WriteData(&EEPROMContext, address, (uint8_t*)header, sizeof(EEPROMHeaderStruct));
}

void EEPROM_ReadHeader(EEPROMHeaderStruct* header, uint16_t address)
{
	L2HAL_24x_ReadData(&EEPROMContext, address, (uint8_t*)header, sizeof(EEPROMHeaderStruct));
}

bool EEPROM_CheckHeader(EEPROMHeaderStruct* header)
{
	uint32_t existingCRC = header->CRCSum;
	header->CRCSum = 0;
	volatile uint32_t calculatedCRC = L2HAL_CRC_Calculate(&CRC_Context, (uint8_t*)header, sizeof(EEPROMHeaderStruct));
	bool result = existingCRC == calculatedCRC;
	header->CRCSum = existingCRC;

	return result;
}

void EEPROM_Init(void)
{
	/* Loading headers and checking them for correctness */
	if (!EEPROM_InitHeaders())
	{
		EEPROM_Format();
		if (!EEPROM_InitHeaders())
		{
			/**
			 * EEPROM is faulty
			 */
			SelfDiagnostics_HaltOnFailure(YhlFailureCause_FaultyEEPROMInHeaders);
		}
	}

	/* Validating all existing profiles, trying to format damaged ones */
	for (uint8_t profileIndex = 0; profileIndex < EEPROM_Header.NumberOfProfiles; profileIndex ++)
	{
		uint16_t profileAddress = EEPROM_Header.ProfilesAddresses[profileIndex];

		EEPROMProfileStruct profile;
		EEPROM_ReadProfile(&profile, profileAddress);
		if (!EEPROM_CheckProfile(&profile))
		{
			profile = EEPROM_GenerateDefaultProfile();
			EEPROM_WriteProfile(&profile, profileAddress);

			EEPROM_ReadProfile(&profile, profileAddress);
			if (!EEPROM_CheckProfile(&profile))
			{
				/* Faulty EEPROM */
				SelfDiagnostics_HaltOnFailure(YhlFailureCause_FaultyEEPROMInProfiles);
			}
		}
	}

	/* Loading current profile */
	uint16_t profileAddress = EEPROM_Header.ProfilesAddresses[EEPROM_Header.ProfileInUse];
	EEPROM_ReadProfile(&EEPROM_CurrentProfile, profileAddress);
}

bool EEPROM_InitHeaders(void)
{
	/* Constant header */
	EEPROM_ReadConstantHeader(&EEPROM_ConstantHeader);

	bool isConstantHeaderValid = EEPROM_CheckConstantHeader(&EEPROM_ConstantHeader);
	if (!isConstantHeaderValid)
	{
		return false;
	}

	/* Main header */
	EEPROM_ReadHeader(&EEPROM_Header, EEPROM_ConstantHeader.HeaderAddress);
	bool isHeaderValid = EEPROM_CheckHeader(&EEPROM_Header);
	if (!isHeaderValid)
	{
		return false;
	}

	/* Now we can write diagnostic codes into EEPROM */
	FoxState.IsEEPROMHeadersInitialized = true;

	/* Checking did we have a firmware update */
	if (EEPROM_Header.SoftwareVersion != YHL_VER_SOFTWARE_VERSION)
	{
		EEPROM_OnSoftwareUpdate();
	}

	return true;
}

void EEPROM_ReadProfile(EEPROMProfileStruct* profile, uint16_t address)
{
	L2HAL_24x_ReadData(&EEPROMContext, address, (uint8_t*)profile, sizeof(EEPROMProfileStruct));
}

bool EEPROM_CheckProfile(EEPROMProfileStruct* profile)
{
	uint32_t existingCRC = profile->CRCSum;
	profile->CRCSum = 0;
	volatile uint32_t calculatedCRC = L2HAL_CRC_Calculate(&CRC_Context, (uint8_t*)profile, sizeof(EEPROMProfileStruct));
	bool result = existingCRC == calculatedCRC;
	profile->CRCSum = existingCRC;

	return result;
}

void EEPROM_WriteProfile(EEPROMProfileStruct* profile, uint16_t address)
{
	profile->CRCSum = 0;
	profile->CRCSum = L2HAL_CRC_Calculate(&CRC_Context, (uint8_t*)profile, sizeof(EEPROMProfileStruct));
	L2HAL_24x_WriteData(&EEPROMContext, address, (uint8_t*)profile, sizeof(EEPROMProfileStruct));
}

EEPROMProfileStruct EEPROM_GenerateDefaultProfile(void)
{
	EEPROMProfileStruct result;
	snprintf(result.Name, YHL_PROFILE_NAME_MEMORY_SIZE, YHL_DEFAULT_PROFILE_NAME);

	result.Frequency.Is144MHz = false;
	result.Frequency.FrequencyHz = YHL_DEFAULT_80M_FREQUENCY;

	result.Code = F1;

	result.IsFast = true;

	result.Cycle.IsContinuous = false;
	result.Cycle.TxTime = 60;
	result.Cycle.PauseTime = 240;

	result.EndingToneLength = 5;

	result.Power = 3.0f;

	Time time;

	time.Days = 0;
	time.Hours = 10;
	time.Minutes = 0;
	time.Seconds = 0;
	result.StartTimespan = TimeToTimespan(time);

	time.Days = 0;
	time.Hours = 13;
	time.Minutes = 0;
	time.Seconds = 0;
	result.EndTimespan = TimeToTimespan(time);

	result.CRCSum = 0;

	return result;
}

void EEPROM_LoadProfileIntoFoxState(FoxStateStruct* foxState, EEPROMProfileStruct* profile)
{
	GSM_Disarm();

	foxState->Frequency = profile->Frequency;

	foxState->Code = profile->Code;
	foxState->IsFast = profile->IsFast;

	foxState->Cycle = profile->Cycle;

	foxState->EndingToneLength = profile->EndingToneLength;

	foxState->Power = profile->Power;

	foxState->GlobalState.StartTimespan = profile->StartTimespan;
	foxState->GlobalState.EndTimespan = profile->EndTimespan;
}

void EEPROM_UpdateHeader(void)
{
	EEPROM_WriteHeader(&EEPROM_Header, EEPROM_ConstantHeader.HeaderAddress);
}

void EEPROM_SwitchProfile(uint8_t profileId)
{
	if (profileId == EEPROM_Header.ProfileInUse)
	{
		return;
	}

	if (profileId >= EEPROM_Header.NumberOfProfiles)
	{
		SelfDiagnostics_HaltOnFailure(YhlFailureCause_WrongProfileIdInEEPROMSwitchProfile);
	}

	EEPROM_Header.ProfileInUse = profileId;
	EEPROM_UpdateHeader();

	uint16_t profileAddress = EEPROM_Header.ProfilesAddresses[profileId];
	EEPROM_ReadProfile(&EEPROM_CurrentProfile,profileAddress);
	EEPROM_LoadProfileIntoFoxState(&FoxState, &EEPROM_CurrentProfile);
}

void EEPROM_AddProfile(void)
{
	if (EEPROM_Header.NumberOfProfiles == YHL_MAX_PROFILES_COUNT)
	{
		SelfDiagnostics_HaltOnFailure(YhlFailureCause_TooManyProfiles);
	}

	EEPROMProfileStruct newProfile = EEPROM_GenerateDefaultProfile();

	uint16_t newProfileAddress = EEPROM_Header.ProfilesAddresses[EEPROM_Header.NumberOfProfiles - 1] + sizeof(EEPROMProfileStruct);
	EEPROM_WriteProfile(&newProfile, newProfileAddress);

	EEPROM_Header.NumberOfProfiles ++;
	EEPROM_Header.ProfilesAddresses[EEPROM_Header.NumberOfProfiles - 1] = newProfileAddress;
	EEPROM_UpdateHeader();
}

EEPROMProfileStruct EEPROM_GetProfile(uint8_t profileId)
{
	if (profileId >= EEPROM_Header.NumberOfProfiles)
	{
		SelfDiagnostics_HaltOnFailure(YhlFailureCause_WrongProfileIdInEEPROMGetProfile);
	}

	EEPROMProfileStruct result;
	uint16_t profileAddress = EEPROM_Header.ProfilesAddresses[profileId];
	EEPROM_ReadProfile(&result, profileAddress);

	return result;
}

void EEPROM_UpdateProfile(EEPROMProfileStruct* profile, uint8_t profileId)
{
	if (profileId >= EEPROM_Header.NumberOfProfiles)
	{
		SelfDiagnostics_HaltOnFailure(YhlFailureCause_WrongProfileIdInEEPROMUpdateProfile);
	}

	uint16_t profileAddress = EEPROM_Header.ProfilesAddresses[profileId];
	EEPROM_WriteProfile(profile, profileAddress);

	if (profileId == EEPROM_Header.ProfileInUse)
	{
		EEPROM_ReadProfile(&EEPROM_CurrentProfile, profileAddress);
		EEPROM_LoadProfileIntoFoxState(&FoxState, &EEPROM_CurrentProfile);
	}
}

bool EEPROM_IsProfileIdValid(uint8_t profileId)
{
	if (profileId > EEPROM_Header.NumberOfProfiles - 1U)
	{
		return false;
	}

	return true;
}

void EEPROM_UpdateCurrentProfile()
{
	EEPROM_UpdateProfile(&EEPROM_CurrentProfile, EEPROM_Header.ProfileInUse);
}

void EEPROM_OnSoftwareUpdate(void)
{
	/* Finally updating firmware version in EEPROM */
	EEPROM_Header.SoftwareVersion = YHL_VER_SOFTWARE_VERSION;
	EEPROM_WriteHeader(&EEPROM_Header, EEPROM_ConstantHeader.HeaderAddress);
}
