WhiteFossa/yiff-l/Firmware/yiff/include/Menu/MenuDisplayPrivate.h

/*
 * MenuDisplayPrivate.h
 *
 *  Created on: Sep 18, 2021
 *      Author: fossa
 */

#ifndef INCLUDE_MENU_MENUDISPLAYPRIVATE_H_
#define INCLUDE_MENU_MENUDISPLAYPRIVATE_H_

/**
 * Max length + 1 for frequency ranges names
 */
#define YHL_MENU_FREQUENCY_RANGE_MEMORY_SIZE 17U

/**
 * Max length + 1 for fox codes names
 */
#define YHL_MENU_FOX_CODES_MEMORY_SIZE 17U

/**
 * Max length + 1 for fox speeds names
 */
#define YHL_MENU_FOX_SPEEDS_MEMORY_SIZE 17U

/**
 * Max length + 1 for cycle types names
 */
#define YHL_MENU_CYCLE_TYPE_MEMORY_SIZE 17U

/**
 * Maximal ending tone duration in seconds
 */
#define YHL_MENU_MAX_ENDINGTONE_DURATION 10U

/**
 * Maximal transmission duration
 */
#define YHL_MENU_MAX_TX_DURATION 3600U

/**
 * Maximal pause duration
 */
#define YHL_MENU_MAX_PAUSE_DURATION 3600U

/**
 * TX power multiplier - we multiply watts to this value to use it in the integer enter display
 */
#define YHL_MENU_TX_POWER_MULTIPLIER 10U

/**
 * TX power step
 */
#define YHL_MENU_TX_POWER_STEP ((int32_t)floor(0.1f * YHL_MENU_TX_POWER_MULTIPLIER + 0.5f))

/**
 * Minimal TX power (watts * YHL_MENU_TX_POWER_MULTIPLIER)
 */
#define YHL_MENU_MIN_TX_POWER (YHL_MIN_POWER_80M * YHL_MENU_TX_POWER_MULTIPLIER)

/**
 * Maximal TX power (watts * YHL_MENU_TX_POWER_MULTIPLIER)
 */
#define YHL_MENU_MAX_TX_POWER (YHL_MAX_POWER_80M * YHL_MENU_TX_POWER_MULTIPLIER)

/**
 * How many frequency ranges do we have
 */
#define YHL_MENU_FREQUENCY_RANGES_COUNT 2U

/**
 * How many codes do we have
 */
#define YHL_MENU_CODES_COUNT 7U

/**
 * How many fox speeds do we have
 */
#define YHL_MENU_SPEEDS_COUNT 2U

/**
 * How many cycle types do we have
 */
#define YHL_MENU_CYCLES_TYPES_COUNT 2U

/**
 * Max possible nodes + leaves
 */
#define YHL_MENU_MAX_LINES_COUNT 9U

/**
 * What happened on menu item
 */
typedef enum
{
	MenuLeftButtonClick,

	MenuEncoderClick,

	MenuRightButtonClick
}
MenuActionEnum;

/**
 * Start node for the whole menu
 */
MenuNode MenuDisplay_RootNode;

/**
 * Clock node
 */
MenuNode MenuDisplay_ClockNode;

/**
 * Profile settings node
 */
MenuNode MenuDisplay_ProfileSettingsNode;

/**
 * Edit current profile node
 */
MenuNode MenuDisplay_EditCurrentProfileNode;

/**
 * Frequency settings node
 */
MenuNode MenuDisplay_FrequencySettingsNode;

/**
 * Code and speed settings node
 */
MenuNode MenuDisplay_CodeAndSpeedSettingsNode;

/**
 * Cycle settings node
 */
MenuNode MenuDisplay_CycleSettingsNode;

/**
 * Run times menu node
 */
MenuNode MenuDisplay_RunTimesSettingsNode;

/**
 * Tx power settings menu node
 */
MenuNode MenuDisplay_TxPowerSettingsNode;

/**
 * Arming settings menu node
 */
MenuNode MenuDisplay_ArmingSettingsNode;

/**
 * Pointer to current menu node
 */
MenuNode* MenuDisplay_CurrentNodePtr;

/**
 * Index of active line
 */
uint8_t MenuDisplay_ActiveLineIndex;

/**
 * How many menu lines current node have
 */
uint8_t MenuDisplay_CurrentNodeLinesCount;

/**
 * Current node lines, sub-nodes first, leaves then.
 */
char MenuDisplay_CurrentNodeLines[YHL_MENU_MAX_LINES_COUNT][YHL_MENU_MAX_ITEM_TEXT_MEMORY_SIZE];

/**
 * How many lines are currently displayed
 */
uint8_t MenuDisplay_WindowLinesCount;

/**
 * Line with this index (from MenuDisplay_CurrentNodeLines) will be displayed at the top
 */
uint8_t MenuDisplay_BaseLine;

/**
 * Names of fox profiles
 */
char MenuDisplay_ProfilesNames[YHL_MAX_PROFILES_COUNT][YHL_PROFILE_NAME_MEMORY_SIZE];

/**
 * Names of frequency ranges
 */
char MenuDisplay_FrequencyRangesNames[YHL_MENU_FREQUENCY_RANGES_COUNT][YHL_MENU_FREQUENCY_RANGE_MEMORY_SIZE];

/**
 * Names of fox codes
 */
char MenuDisplay_FoxCodesNames[YHL_MENU_CODES_COUNT][YHL_MENU_FOX_CODES_MEMORY_SIZE];

/**
 * Names of fox speeds
 */
char MenuDisplay_FoxSpeedsNames[YHL_MENU_SPEEDS_COUNT][YHL_MENU_FOX_SPEEDS_MEMORY_SIZE];

/**
 * Names of cycle types
 */
char MenuDisplay_CycleTypesNames[YHL_MENU_CYCLES_TYPES_COUNT][YHL_MENU_CYCLE_TYPE_MEMORY_SIZE];

/**
 * Draw menu lines with selected line
 */
void MenuDisplay_DrawMenuLines(uint8_t linesCount, char* lines, uint8_t activeLineIndex);

/**
 * Called when menu need to be scrolled up
 */
void MenuDisplay_ScrollUpHandler(void);

/**
 * Called when menu need to be scrolled down
 */
void MenuDisplay_ScrollDownHandler(void);

/**
 * Gets active line index (globally active, not in display window)
 */
uint8_t MenuDisplay_GetCurrentNodeActiveLineIndex(void);

/**
 * Gets current node active sub-node index or returns YHL_MENU_NOT_A_NODE if active line points to a leaf
 */
int16_t MenuDisplay_GetCurrentSubNodeIndex(uint8_t currentNodeActiveLineIndex);

/**
 * Gets current node active list index or returns YHL_MENU_NOT_A_LEAF if active line points to a sub-node
 */
int16_t MenuDisplay_GetCurrentLeafIndex(uint8_t currentNodeActiveLineIndex);

/**
 * Call it on action (e.g. button press)
 */
void MenuDisplay_OnAction(MenuActionEnum action);

/**
 * Called when something is happened on menu node
 */
void MenuDisplay_ActionOnNodeHandler(MenuNode* node, MenuActionEnum action);

/**
 * Called when something is happened on menu leaf
 */
void MenuDisplay_ActionOnLeafHandler(const MenuLeaf* leaf, MenuActionEnum action);

/**
 * Make given node current
 */
void MenuDisplay_SwitchNode(MenuNode* nodePtr);

/**
 * Go to parent of current node
 */
void MenuDisplay_GoToParentNode(void);

/**
 * Show information popup about current profile
 */
void MenuDisplay_ShowCurrentProfileInformationPopup(void);

/**
 * Call this to select current profile
 */
void MenuDisplay_SelectCurrentProfile(void);

/**
 * Call it when current profile is selected
 */
void MenuDisplay_SelectCurrentProfileCloseHandler(uint8_t profileIndex);

/**
 * Call this to select frequency range
 */
void MenuDisplay_SelectFrequencyRange(void);

/**
 * Call this when frequency range is selected
 */
void MenuDisplay_SelectFrequencyRangeCloseHandler(uint8_t rangeIndex);

/**
 * Returns frequency range index depending on range type
 */
uint8_t MenuDisplay_GetFrequencyRangeIndex(bool is144MHz);

/**
 * Returns "Is 144 MHz" flag by range index
 */
bool MenuDisplay_GetFrequencyRangeByIndex(uint8_t rangeIndex);

/**
 * Call this to enter frequency
 */
void MenuDisplay_EnterFrequency(void);

/**
 * Call this when frequency is entered
 */
void MenuDisplay_EnterFrequencyOnEnterHandler(int32_t frequency);

/**
 * Used to format frequency in frequency input display.
 */
void MenuDisplay_FormatFrequency(int32_t frequencyHz, char buffer[YHL_NUMBER_INPUT_DISPLAY_FORMATTER_BUFFER_SIZE]);

/**
 * Call this to select fox code
 */
void MenuDisplay_SelectCode(void);

/**
 * Call this when fox code is selected
 */
void MenyDisplay_SelectCodeCloseHandler(uint8_t codeIndex);

/**
 * Call this to select fox speed
 */
void MenuDisplay_SelectFoxSpeed(void);

/**
 * Call this when fox speed is selected
 */
void MenyDisplay_SelectFoxSpeedCloseHandler(uint8_t speedIndex);

/**
 * Converts fox speed to selected item index
 */
uint8_t MenuDisplay_FoxSpeedToIndex(bool isFast);

/**
 * Converts selected item index to fox speed.
 */
bool MenuDisplay_IndexToFoxSpeed(uint8_t index);

/**
 * Call this to select cycle type
 */
void MenuDisplay_SelectIsContinuousCycle(void);

/**
 * Call this when cycle type is selected
 */
void MenuDisplay_SelectIsContinuousCycleHandler(uint8_t cycleTypeIndex);

/**
 * Converts fox cycle type into item index
 */
uint8_t MenuDisplay_CycleTypeToIndex(bool isContinuous);

/**
 * Converts item index to fox cycle type
 */
bool MenuDisplay_IndexToCycleType(uint8_t index);

/**
 * Call this to enter ending tone duration
 */
void MenuDisplay_EnterEndingToneDuration(void);

/**
 * Call this when ending tone duration is entered
 */
void MenuDisplay_EnterEndingToneDurationOnEnterHandler(int32_t duration);

/**
 * Used to format ending tone duration in ending tone duration input display.
 */
void MenuDisplay_FormatEndingToneDuration(int32_t duration, char buffer[YHL_NUMBER_INPUT_DISPLAY_FORMATTER_BUFFER_SIZE]);

/**
 * Call this to show "cycle is continuous" warning
 */
void MenuDisplay_ShowCycleIsContinuousWarning(void);

/**
 * Call this to enter Tx duration
 */
void MenuDisplay_EnterTxDuration(void);

/**
 * Call this when Tx duration is entered
 */
void MenuDisplay_EnterTxDurationEnterHandler(uint32_t duration);

/**
 * Call this to enter pause duration
 */
void MenuDisplay_EnterPauseDuration(void);

/**
 * Call this when pause duration is entered
 */
void MenuDisplay_EnterPauseDurationEnterHandler(uint32_t duration);

/**
 * Call this to enter fox start time
 */
void MenuDisplay_EnterStartTime(void);

/**
 * Call this when fox start time is entered
 */
void MenuDisplay_EnterStartTimeEnterHandler(uint32_t secondsSinceMidnight);

/**
 * Call this to enter fox finish time
 */
void MenuDisplay_EnterFinishTime(void);

/**
 * Call this when fox finish time is entered
 */
void MenuDisplay_EnterFinishTimeEnterHandler(uint32_t secondsSinceMidnight);

/**
 * Call this to arm fox
 */
void MenuDisplay_Arm(void);

/**
 * Call this to disarm fox
 */
void MenuDisplay_Disarm(void);

/**
 * Call this to enter TX power
 */
void MenuDisplay_EnterTxPower(void);

/**
 * Call this when TX power is entered
 */
void MenuDisplay_EnterTxPowerOnEnterHandler(int32_t power);

/**
 * Used to format TX power in TX power input display.
 */
void MenuDisplay_FormatTxPower(int32_t TxPower, char buffer[YHL_NUMBER_INPUT_DISPLAY_FORMATTER_BUFFER_SIZE]);

/**
 * Call it to show warning message about armed fox
 */
void MenuDisplay_ShowArmedWarning(void);

/**
 * Call this to enter current time
 */
void MenuDisplay_EnterCurrentTime(void);

/**
 * Call this when current time is entered
 */
void MenuDisplay_EnterCurrentTimeEnterHandler(uint32_t secondsSinceMidnight);

/**
 * Clock -> Set current time
 */
static const MenuLeaf MenuDisplay_SetCurrentTimeLeaf =
{
	.Name = "Set current time",
	.LeftButtonText = "Set",
	.LeftButtonAction = &MenuDisplay_EnterCurrentTime
};

/**
 * Profile settings -> Show current profile
 */
static const MenuLeaf MenuDisplay_ShowCurrentProfileLeaf =
{
	.Name = "Show current profile",
	.LeftButtonText = "Show",
	.LeftButtonAction = &MenuDisplay_ShowCurrentProfileInformationPopup
};

/**
 * Profile settings -> Select profile
 */
static const MenuLeaf MenuDisplay_SelectProfileLeaf =
{
	.Name = "Select profile",
	.LeftButtonText = "Select",
	.LeftButtonAction = &MenuDisplay_SelectCurrentProfile
};

/**
 * Edit current profile -> Frequency -> Range
 */
static const MenuLeaf MenuDisplay_FrequencyRangeLeaf =
{
	.Name = "Range",
	.LeftButtonText = "Set",
	.LeftButtonAction = &MenuDisplay_SelectFrequencyRange
};

/**
 * Edit current profile -> Frequency -> Value
 */
static const MenuLeaf MenuDisplay_FrequencyValueLeaf =
{
	.Name = "Value",
	.LeftButtonText = "Set",
	.LeftButtonAction = &MenuDisplay_EnterFrequency
};

/**
 * Edit current profile -> Code and speed -> Code
 */
static const MenuLeaf MenuDisplay_CodeLeaf =
{
	.Name = "Code",
	.LeftButtonText = "Select",
	.LeftButtonAction = &MenuDisplay_SelectCode
};

/**
 * Edit current profile -> Code and speed -> Speed
 */
static const MenuLeaf MenuDisplay_SpeedLeaf =
{
	.Name = "Speed",
	.LeftButtonText = "Select",
	.LeftButtonAction = &MenuDisplay_SelectFoxSpeed
};

/**
 * Edit current profile -> Cycle -> Is continuous
 */
static const MenuLeaf MenuDisplay_IsContinuousLeaf =
{
	.Name = "Is continuous?",
	.LeftButtonText = "Select",
	.LeftButtonAction = &MenuDisplay_SelectIsContinuousCycle
};

/**
 * Edit current profile -> Cycle -> TX time
 */
static const MenuLeaf MenuDisplay_TxTimeLeaf =
{
	.Name = "TX time",
	.LeftButtonText = "Set",
	.LeftButtonAction = &MenuDisplay_EnterTxDuration
};

/**
 * Edit current profile -> Cycle -> Pause time
 */
static const MenuLeaf MenuDisplay_PauseTimeLeaf =
{
	.Name = "Pause time",
	.LeftButtonText = "Set",
	.LeftButtonAction = &MenuDisplay_EnterPauseDuration
};

/**
 * Edit current profile -> Cycle -> Ending tone duration
 */
static const MenuLeaf MenuDisplay_EndingToneLeaf =
{
	.Name = "Ending tone duration",
	.LeftButtonText = "Set",
	.LeftButtonAction = &MenuDisplay_EnterEndingToneDuration
};

/**
 * Edit current profile -> Run times -> Start time
 */
static const MenuLeaf MenuDisplay_StartTimeLeaf =
{
	.Name = "Start time",
	.LeftButtonText = "Set",
	.LeftButtonAction = &MenuDisplay_EnterStartTime
};

/**
 * Edit current profile -> Run times -> Finish time
 */
static const MenuLeaf MenuDisplay_FinishTimeLeaf =
{
	.Name = "Finish time",
	.LeftButtonText = "Set",
	.LeftButtonAction = &MenuDisplay_EnterFinishTime
};

/**
 * Edit current profile -> TX power -> TX power
 */
static const MenuLeaf MenuDisplay_TxPowerLeaf =
{
	.Name = "TX Power",
	.LeftButtonText = "Set",
	.LeftButtonAction = &MenuDisplay_EnterTxPower
};

/**
 * Arming -> Arm
 */
static const MenuLeaf MenuDisplay_ArmLeaf =
{
	.Name = "Arm",
	.LeftButtonText = "Arm",
	.LeftButtonAction = &MenuDisplay_Arm
};

/**
 * Arming -> Disarm
 */
static const MenuLeaf MenuDisplay_DisarmLeaf =
{
	.Name = "Disarm",
	.LeftButtonText = "Disarm",
	.LeftButtonAction = &MenuDisplay_Disarm
};

/**
 * Root
 */
static const char* MenuDisplay_RootNodeName = "";

/**
 * Clock
 */
static const char* MenuDisplay_ClockNodeName = "Clock";

/**
 * Profile settings
 */
static const char* MenuDisplay_ProfileSettingsNodeName = "Profile settings";

/**
 * Edit current profile
 */
static const char* MenuDisplay_EditCurrentProfileNodeName = "Edit current profile";

/**
 * Edit current profile -> Frequency
 */
static const char* MenuDisplay_FrequencyNodeName = "Frequency";

/**
 * Edit current profile -> Code and speed
 */
static const char* MenuDisplay_CodeAndSpeedNodeName = "Code and speed";

/**
 * Edit current profile -> Cycle
 */
static const char* MenuDisplay_CycleNodeName = "Cycle";

/**
 * Edit current profile -> Run times
 */
static const char* MenuDisplay_RunTimesNodeName = "Run times";

/**
 * Edit current profile -> TX power
 */
static const char* MenuDisplay_TxPowerNodeName = "TX power";

/**
 * Arming
 */
static const char* MenuDisplay_ArmingNodeName = "Arming";


#endif /* INCLUDE_MENU_MENUDISPLAYPRIVATE_H_ */
