WhiteFossa/yiff-l/Firmware/yiff/src/l2hal/include/l2hal_custom.h

/*
	This file is part of Fossa's STM32 level 2 HAL.

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
	If not, see <http://www.gnu.org/licenses/>.

	-------------------------------------------------------------------------

	Created by White Fossa, also known as Artyom Vetrov.

	Feel free to contact: whitefossa@gmail.com

	Repository: https://github.com/WhiteFossa/stm32-l2hal

	If repository above is not available, try my LiveJournal:
	fossa-white.livejournal.com

	or as last measure try to search for #WhiteFossa hashtag.

	-------------------------------------------------------------------------
 */

/**
 * @file
 * @biref File for custom hardware-related stuff.
 */

#ifndef L2HAL_INCLUDE_L2HAL_CUSTOM_H_
#define L2HAL_INCLUDE_L2HAL_CUSTOM_H_

#include <l2hal_ssd1327.h>
#include <l2hal_buttons.h>
#include <l2hal_encoders.h>
#include <l2hal_24x.h>
#include <l2hal_crc.h>
#include <l2hal_hc06.h>
#include <l2hal_ad5245.h>
#include <l2hal_ad9835.h>

extern I2C_HandleTypeDef I2C_Display;
extern I2C_HandleTypeDef I2C_Other;
extern UART_HandleTypeDef UART_Handle;
extern L2HAL_SSD1327_ContextStruct L2HAL_SSD1327_Context;
extern SPI_HandleTypeDef SPIHandle;

/**
 * Display resides here
 */
#define L2HAL_DISPLAY_BUS I2C1

/**
 * Display bus port
 */
#define L2HAL_DISPLAY_BUS_PORT GPIOB

/**
 * Clock this port when initializing display bus
 */
#define L2HAL_DISPLAY_BUS_CLOCK_PORT __HAL_RCC_GPIOB_CLK_ENABLE

/**
 * Enable display bus clock
 */
#define L2HAL_DISPLAY_BUS_CLOCK_ENABLE __HAL_RCC_I2C1_CLK_ENABLE

/**
 * Disable display bus clock
 */
#define L2HAL_DISPLAY_BUS_CLOCK_DISABLE __HAL_RCC_I2C1_CLK_DISABLE

/**
 * Display bus SCL
 */
#define L2HAL_DISPLAY_BUS_SCL GPIO_PIN_6

/**
 * Display bus SDA
 */
#define L2HAL_DISPLAY_BUS_SDA GPIO_PIN_7

/**
 * I2C1 interrupt priorities.
 */
#define I2C1_ER_IRQN_PRIORITY 2
#define I2C1_ER_IRQN_SUBPRIORITY 0

#define I2C1_EV_IRQN_PRIORITY 2
#define I2C1_EV_IRQN_SUBPRIORITY 0

/**
 * I2C2 interrupt priorities.
 */
#define I2C2_ER_IRQN_PRIORITY 15
#define I2C2_ER_IRQN_SUBPRIORITY 0

#define I2C2_EV_IRQN_PRIORITY 15
#define I2C2_EV_IRQN_SUBPRIORITY 0

/**
 * UART1 interrupt priorities
 */
#define USART1_IRQN_PRIORITY 1
#define USART1_IRQN_SUBPRIORITY 0

/**
 * Put custom hardware initialization stuff here,
 */
void L2HAL_InitCustomHardware(void);

/**
 * Settig up both I2C buses
 */
void L2HAL_SetupI2C(void);

/**
 * I2C init.
 */
volatile void HAL_I2C_MspInit(I2C_HandleTypeDef *hi2c);

/**
 * I2C shutdown.
 */
volatile void HAL_I2C_MspDeInit(I2C_HandleTypeDef* hi2c);

/**
 * I2C interrput handlers.
 */
volatile void I2C1_EV_IRQHandler(void);
volatile void I2C1_ER_IRQHandler(void);
volatile void HAL_I2C_MemTxCpltCallback(I2C_HandleTypeDef *hi2c);

volatile void I2C2_EV_IRQHandler(void);
volatile void I2C2_ER_IRQHandler(void);

/**
 * CRC calculator init and de-init
 */
volatile void HAL_CRC_MspInit(CRC_HandleTypeDef *hcrc);
volatile void HAL_CRC_MspDeInit(CRC_HandleTypeDef *hcrc);

/**
 * UART-related stuff
 */
volatile void HAL_UART_MspInit(UART_HandleTypeDef *huart);
volatile void HAL_UART_MspDeInit(UART_HandleTypeDef *huart);
volatile void USART1_IRQHandler(void);

/**
 * ADC-related stuff
 */
volatile void HAL_ADC_MspInit(ADC_HandleTypeDef *hadc);
volatile void HAL_ADC_MspDeInit(ADC_HandleTypeDef *hadc);

/**
 * SPI-related stuff
 */
volatile void HAL_SPI_MspInit(SPI_HandleTypeDef *hspi);
volatile void HAL_SPI_MspDeInit(SPI_HandleTypeDef *hspi);
void L2HAL_SetupSPI(void);

/**
 * Timer 3 (144MHz modulation generator) related stuff
 */
volatile void HAL_TIM_OC_MspInit(TIM_HandleTypeDef* htim);
volatile void HAL_TIM_OC_MspDeInit(TIM_HandleTypeDef* htim);

/**
 * Timer 2 (high priority events generation) related stuff
 */
volatile void HAL_TIM_Base_MspInit(TIM_HandleTypeDef* htim);
volatile void HAL_TIM_Base_MspDeInit(TIM_HandleTypeDef* htim);

#endif /* L2HAL_INCLUDE_L2HAL_CUSTOM_H_ */
