WhiteFossa/yiff-l/Firmware/yiff/include/Commands.h

/*
 * Commands.h
 *
 *  Created on: Jun 1, 2021
 *      Author: fossa
 */

#ifndef INCLUDE_COMMANDS_H_
#define INCLUDE_COMMANDS_H_

#include <stdbool.h>

/**
 * Flags for various commands, which fox can get
 */
typedef struct
{
	/**
	 * If true, then fox name just changed, we need to write it to EEPROM from the main thread
	 */
	bool FoxStateNameChanged;

	/**
	 * If true, then we need to add new profile in main thread
	 */
	bool NeedToAddNewProfile;

	/**
	 * If true, then we need to switch profile to one in SwitchToThisProfileId
	 */
	bool NeedToSwitchProfile;

	/**
	 * If true, then we need to set current profile name to SetThisProfileName
	 */
	bool NeedToSetProfileName;

	/**
	 * If true, then we need to update frequency
	 */
	bool NeedToSetFrequency;

	/**
	 * If true, then we need to update frequency (from fox menu)
	 */
	bool NeedToSetFrequencyByHandpaws;

	/**
	 * If true, then we need to update fox code
	 */
	bool NeedToSetCode;

	/**
	 * If true, then we need to update fox code (from fox menu)
	 */
	bool NeedToSetCodeByHandpaws;

	/**
	 * If true, then we need to update fox speed
	 */
	bool NeedToSetSpeed;

	/**
	 * If true, then we need to update fox speed (from fox menu)
	 */
	bool NeedToSetSpeedByHandpaws;

	/**
	 * If true, then we need to update fox cycle
	 */
	bool NeedToSetCycle;

	/**
	 * If true, then we need to update fox cycle (from fox menu)
	 */
	bool NeedToSetCycleByHandpaws;

	/**
	 * If true, then we need to update ending tone duration
	 */
	bool NeedToSetEndingToneDuration;

	/**
	 * If true, then we need to update ending tone duration (from fox menu)
	 */
	bool NeedToSetEndingToneDurationByHandpaws;

	/**
	 * If true, then we need to update start and end times
	 */
	bool NeedToSetBeginAndEndTimes;

	/**
	 * If true, then we need to update start and end times (from fox menu)
	 */
	bool NeedToSetBeginAndEndTimesByHandpaws;

	/**
	 * If true, then we need to set fox power
	 */
	bool NeedToSetPower;

	/**
	 * If true, then we need to set fox power (from fox menu)
	 */
	bool NeedToSetPowerByHandpaws;

	/**
	 * If true, then we need to arm fox
	 */
	bool NeedToArmFox;

	/**
	 * If true, then we need to arm fox manually
	 */
	bool NeedToArmFoxByHandpaws;

	/**
	 * If true, then we need to reset last faiulre code to OK
	 */
	bool NeedToResetLastFailureCode;

	/**
	 * If true, then we need to save new serial number into EERPOM
	 */
	bool NeedToUpdateSerialNumber;

	/**
	 * If true, then we need to save new Ubatt ADC->Volts factors
	 */
	bool NeedToSetUbattADCToUbattVoltsFactors;

	/**
	 * If true, then we need to save new Ubatt Volts->Batt level factors
	 */
	bool NeedToSetUbattVoltsToBattLevelFactors;

	/**
	 * If true, then we need to save new U80m ADC->Volts factors
	 */
	bool NeedToSetU80mADCtoU80mVoltsFactors;

	/**
	 * If true, then we need to save new P80m->U80m factors
	 */
	bool NeedToSetP80mToU80mFactors;

	/**
	 * If true, then we need to save new Uant(ADC)->Uant(Volts) factors
	 */
	bool NeedToSetUantADCToUantVoltsFactors;

	/**
	 * If true, then we need to force TX (service mode)
	 */
	bool NeedToForceTx;

	/**
	 * If true, then we need to return from force TX
	 */
	bool NeedToReturnFromForceTx;

	/**
	 * If true, then we need to set RTC calibration value
	 */
	bool NeedToSetRTCCalibrationValue;

	/**
	 * If true, then we need to set disarm-on-discharge value
	 */
	bool NeedToSetDisarmOnDischargeValue;
}
PendingCommandsFlagsStruct;



#endif /* INCLUDE_COMMANDS_H_ */
