WhiteFossa/yiff-l/Firmware/yiff/src/RTC.c

/*
 * RTC.c
 *
 *  Created on: Apr 15, 2021
 *      Author: fossa
 */

#include <RTC.h>
#include <RTCPrivate.h>

void HAL_RTC_MspInit(RTC_HandleTypeDef *hrtc)
{
	/* Clocking in backup domain */
	__HAL_RCC_PWR_CLK_ENABLE();
	HAL_PWR_EnableBkUpAccess();

	/* LSE (32.768Hz crystal) as clock source */
	RCC_OscInitTypeDef RCC_OscInitStruct;
	RCC_OscInitStruct.OscillatorType =  RCC_OSCILLATORTYPE_LSI | RCC_OSCILLATORTYPE_LSE;
	RCC_OscInitStruct.PLL.PLLState = RCC_PLL_NONE;
	RCC_OscInitStruct.LSEState = RCC_LSE_ON;
	RCC_OscInitStruct.LSIState = RCC_LSI_OFF;
	if(HAL_RCC_OscConfig(&RCC_OscInitStruct) != HAL_OK)
	{
		SelfDiagnostics_HaltOnFailure(YhlFailureCause_FailedToStartLSE);
	}

	RCC_PeriphCLKInitTypeDef PeriphClkInitStruct;
	PeriphClkInitStruct.PeriphClockSelection = RCC_PERIPHCLK_RTC;
	PeriphClkInitStruct.RTCClockSelection = RCC_RTCCLKSOURCE_LSE;
	if(HAL_RCCEx_PeriphCLKConfig(&PeriphClkInitStruct) != HAL_OK)
	{
		SelfDiagnostics_HaltOnFailure(YhlFailureCause_FailedToSwitchToLSE);
	}

	/* Clocking in RTC */
	__HAL_RCC_RTC_ENABLE();
}

void HAL_RTC_MspDeInit(RTC_HandleTypeDef *hrtc)
{
	__HAL_RCC_RTC_DISABLE();
}

void InitRTC(void)
{
	RtcHandle.Instance = RTC;
	RtcHandle.Init.AsynchPrediv = RTC_AUTO_1_SECOND;
	if (HAL_RTC_Init(&RtcHandle) != HAL_OK)
	{
		SelfDiagnostics_HaltOnFailure(YhlFailureCause_FailedToInitRTC);
	}

	/* Resetting date/time */
	CurrentDate.Year = 21U;
	CurrentDate.Month = RTC_MONTH_JANUARY;
	CurrentDate.Date = 1U;
	CurrentDate.WeekDay = RTC_WEEKDAY_FRIDAY;
	RTC_SetCurrentDate(CurrentDate);

	CurrentTime.Hours = 0U;
	CurrentTime.Minutes = 0U;
	CurrentTime.Seconds = 0U;
	RTC_SetCurrentTime(CurrentTime);

	PreviousSecond = 0U;

	/* We have no listeners initially */
	RtcOnNewSecondListenersCount = 0;
	RtcDateAndTimeChangeListenersCount = 0;
}

void RTC_CallOnDateOrTimeChangeListeners(void)
{
	for (uint8_t i = 0; i < RtcDateAndTimeChangeListenersCount; i++)
	{
		RtcDateAndTimeChangeListeners[i]();
	}
}

void RTC_SetCurrentDate(RTC_DateTypeDef date)
{
	if (HAL_RTC_SetDate(&RtcHandle, &date, RTC_FORMAT_BIN) != HAL_OK)
	{
		SelfDiagnostics_HaltOnFailure(YhlFailureCause_FailedToSetRTCDate);
	}

	CurrentDate = date;
	RTC_CallOnDateOrTimeChangeListeners();
}

void RTC_SetCurrentTime(RTC_TimeTypeDef time)
{
	if (HAL_RTC_SetTime(&RtcHandle, &time, RTC_FORMAT_BIN) != HAL_OK)
	{
		SelfDiagnostics_HaltOnFailure(YhlFailureCause_FailedToSetRTCTime);
	}

	CurrentTime = time;
	RTC_CallOnDateOrTimeChangeListeners();
}

void RTC_Poll(void)
{
	if (HAL_RTC_GetTime(&RtcHandle, &CurrentTime, RTC_FORMAT_BIN) != HAL_OK)
	{
		SelfDiagnostics_HaltOnFailure(YhlFailureCause_FailedToGetRTCTime);
	}

	if (PreviousSecond != CurrentTime.Seconds)
	{
		if (HAL_RTC_GetDate(&RtcHandle, &CurrentDate, RTC_FORMAT_BIN) != HAL_OK)
		{
			SelfDiagnostics_HaltOnFailure(YhlFailureCause_FailedToGetRTCDate);
		}

		/* Calling listeners */
		for (uint8_t i = 0; i < RtcOnNewSecondListenersCount; i++)
		{
			RtcOnNewSecondListeners[i]();
		}
	}

	PreviousSecond = CurrentTime.Seconds;
}

void RTC_AddOnNewSecondListener(void (*listener)(void))
{
	if (RtcOnNewSecondListenersCount >= YHL_MAX_ON_NEW_SECOND_LISTENERS)
	{
		/* No more, please */
		SelfDiagnostics_HaltOnFailure(YhlFailureCause_TooMuchSecondChangeListeners);
	}

	RtcOnNewSecondListenersCount ++;
	RtcOnNewSecondListeners[RtcOnNewSecondListenersCount - 1] = listener;
}

void RTC_AddOnDateOrTimeChangeListener(void (*listener)(void))
{
	if (RtcDateAndTimeChangeListenersCount >= YHL_MAX_ON_DATE_AND_TIME_CHANGE_LISTENERS)
	{
		SelfDiagnostics_HaltOnFailure(YhlFailureCause_TooMuchDateOrTimeListeners);
	}

	RtcDateAndTimeChangeListenersCount ++;
	RtcDateAndTimeChangeListeners[RtcDateAndTimeChangeListenersCount - 1] = listener;
}

uint8_t GetWeekdayFromDayNumber(uint8_t dayNumber)
{
	switch (dayNumber)
	{
		case 1U:
			return RTC_WEEKDAY_MONDAY;

		case 2U:
			return RTC_WEEKDAY_TUESDAY;

		case 3U:
			return RTC_WEEKDAY_WEDNESDAY;

		case 4U:
			return RTC_WEEKDAY_THURSDAY;

		case 5U:
			return RTC_WEEKDAY_FRIDAY;

		case 6U:
			return RTC_WEEKDAY_SATURDAY;

		case 7U:
			return RTC_WEEKDAY_SUNDAY;

		default:
			SelfDiagnostics_HaltOnFailure(YhlFailureCause_WrongWeekDayInGetWeekdayFromDayNumber);

			return 0; /* Never will be reached */
	}
}

void RTC_SetCalibrationValue(uint8_t calibrationValue)
{
	HAL_SetRTCCalibrationValue(calibrationValue);
}
