WhiteFossa/yiff-l/Firmware/yiff/include/RTCPrivate.h

/*
 * RTCPrivate.h
 *
 *  Created on: May 31, 2021
 *      Author: fossa
 */

#ifndef INCLUDE_RTCPRIVATE_H_
#define INCLUDE_RTCPRIVATE_H_

#include <RTC.h>

/**
 * RTC handle
 */
RTC_HandleTypeDef RtcHandle;

/**
 * Second number at the moment of previous call of RTC_Poll();
 */
uint8_t PreviousSecond;

/**
 * How many listeners we have.
 */
uint8_t RtcOnNewSecondListenersCount;

/**
 * This functions listens for new second event.
 */
void (*RtcOnNewSecondListeners[YHL_MAX_ON_NEW_SECOND_LISTENERS])(void);

/**
 * How many date and time change listeners we have.
 */
uint8_t RtcDateAndTimeChangeListenersCount;

/**
 * This functions listens for date and time change.
 */
void (*RtcDateAndTimeChangeListeners[YHL_MAX_ON_DATE_AND_TIME_CHANGE_LISTENERS])(void);


#endif /* INCLUDE_RTCPRIVATE_H_ */
