WhiteFossa/yiff-l/Firmware/yiff/include/Buttons.h

/*
 * Buttons.h
 *
 *  Created on: Apr 13, 2021
 *      Author: fossa
 */

#ifndef INCLUDE_BUTTONS_H_
#define INCLUDE_BUTTONS_H_

#include <GraphicsBase.h>

/**
 * Buttons positions
 */
#define YHL_BUTTONS_TOP_LINE 110
#define YHL_BUTTONS_WIDTH 59
#define YHL_BUTTONS_HEIGHT 17
#define YHL_BUTTONS_LEFT_BUTTON_LEFT 0
#define YHL_BUTTONS_RIGHT_BUTTON_LEFT 68


/**
 * Text on buttons must be no longer then this
 */
#define YHL_MAX_BUTTON_TEXT_LENGTH 16

#define YHL_MAX_BUTTON_TEXT_MEMORY_SIZE (YHL_MAX_BUTTON_TEXT_LENGTH + 1)

/**
 * Button descriptor.
 */
typedef struct
{
	/**
	 * True, if button is pressed (such button is displayed inverted).
	 */
	bool IsPressed;

	/**
	 * Button text.
	 */
	char Text[YHL_MAX_BUTTON_TEXT_MEMORY_SIZE];
}
FoxButtonStruct;

extern FoxButtonStruct LeftButton;
extern FoxButtonStruct RightButton;

/**
 * Draw buttons (does not flush framebuffer, flush it yourself)
 */
void DrawButtons(void);

void DrawButton(FoxButtonStruct* button, uint16_t x, uint16_t y, uint16_t width, uint16_t height);

#endif /* INCLUDE_BUTTONS_H_ */
