WhiteFossa/yiff-l/Firmware/yiff/include/Menu/InformationPopupDisplayPrivate.h

/*
 * InformationPopupDisplayPrivate.h
 *
 *  Created on: Sep 11, 2021
 *      Author: fossa
 */

#ifndef INCLUDE_INFORMATIONPOPUPDISPLAYPRIVATE_H_
#define INCLUDE_INFORMATIONPOPUPDISPLAYPRIVATE_H_

/**
 * Return to this display when popup is closed.
 */
FoxDisplayEnum InformationPopup_PreviousDisplay;



#endif /* INCLUDE_INFORMATIONPOPUPDISPLAYPRIVATE_H_ */
