WhiteFossa/yiff-l/Firmware/yiff/include/GraphicsBase.h

/*
 * GraphicsBase.h
 *
 *  Created on: Apr 7, 2021
 *      Author: fossa
 */

#ifndef INCLUDE_GRAPHICSBASE_H_
#define INCLUDE_GRAPHICSBASE_H_

#include <fmgl.h>

extern FMGL_API_DriverContext fmglContext;
extern FMGL_API_FontSettings commonFont;
extern FMGL_API_FontSettings invertedCommonFont;
extern FMGL_API_FontSettings frequencyFont;
extern FMGL_API_ColorStruct OffColor;
extern FMGL_API_ColorStruct OnColor;

#endif /* INCLUDE_GRAPHICSBASE_H_ */
