WhiteFossa/yiff-l/(commit log)

2018-08-12 Initial VCO version
    [VCO.kicad_pcb, VCO.sch]
2018-08-12 Fixed incorrectly-connected VT1
    [VCO.sch]
2018-08-13 Preliminary VCO schematic with tuning and buffer amplifier.
    [VCO.sch]
2018-08-18 -Simpler (and working) VCO with good sinusoidal output.
    [VCO.sch]
2018-08-18 Actually generating with this sceme
    [VCO.sch]
2018-08-18 - Hope that variant of VCO out amplifier will work (will check it tomorrow).
    - Some simulations (QUCS is good, but still fail to simulate my schemes properly).
    [VCO.sch, VCO_amplifier.sch]
2018-08-21 Added current project status
    [VCO.sch]
2018-09-23 - Added BOM
    [VCO.sch, VCO_BOM.csv, VCO_BOM.ods]
2018-09-30 Created VCO testing board
    [FullSchematic.kicad_pcb, FullSchematic.sch, VCO-testboard.kicad_pcb, VCO-testboard.sch]
2018-09-30 Fixed layout a bit
    [VCO-testboard.kicad_pcb]
2018-09-30 Changed layout a bit
    [VCO-testboard.kicad_pcb]
2018-10-06 Tuning to avoid 6V source instability and make startup stable
    [FullSchematic.sch, VCO-testboard.kicad_pcb, VCO-testboard.sch]
2018-10-21 VCO is now fully ready
    [VCO-testboard.sch]
2018-10-24 Modifid oscillator (see full schematic) to use 0V-5V tuning voltage.
    [FullSchematic.sch]
2020-12-06 Started experimental firmware implementation
    [FullSchematic-2019-11-10-22-56-42.sch, FullSchematic-2020-11-30-10-20-26.sch, FullSchematic.sch]
2020-12-11 Got SPI signal for PLL, some more driver work needed
    [FullSchematic.sch]
2020-12-11 Driver is ready, time to connect PLL
2020-12-13 PLL is controllable, Fvco is too weak
    [FullSchematic.sch]
2020-12-20 Some problems with initialization, but works in general
    [DDS.kicad_pcb, DDS.sch, FullSchematic.sch]
2020-12-21 Noise suppression resistors + fixed FSYNC delay + 18MHz support
    [l2hal_ad9835.c, l2hal_ad9835_private.h, l2hal_adf4001.c, l2hal_adf4001.h, l2hal_adf4001_defines.h, l2hal_adf4001_private.h, main.c, main.h]
2020-12-21 Committing forgotten changes
    [DDS.sch]
2020-12-21 Added full schematic v2
    [Full schematic.kicad_pcb, Full schematic.sch, FullSchematic-2019-11-10-22-56-42.sch, FullSchematic-2020-11-30-10-20-26.sch, FullSchematic.kicad_pcb, FullSchematic.sch]
2020-12-24 Fixed power control bug
    [Active filter.sch, Full schematic.sch, Passive filter.sch]
2020-12-27 Working 3.5MHz tract.
    [Filter response.ods, Full schematic.sch]
2020-12-28 Added amplitude at antenna detector
    [Full schematic.sch]
2021-01-02 Added antenna matching, ready to draw PCB
    [Full schematic.sch]
2021-01-07 PCB is ready
    [Full schematic.sch]
2021-01-17 After prototype built
    [Full schematic.kicad_pcb, Full schematic.sch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]
2021-01-17 Getting data from antenna detector
2021-01-24 Looks like 3.5MHz part is completely OK now
    [Full schematic.sch, Power vs Upower.ods]
2021-01-24 Added manipulation
    [Full schematic.sch]
2021-02-06 Started 144MHz part, have modulated 144MHz carrier
    [Filter response.ods, Full schematic.kicad_pcb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]
2021-02-15 144MHz preamp is ready
    [Full schematic.sch, Power vs Upower.ods]
2021-03-02 Second prototype PCB is almost ready
    [Full schematic.kicad_pcb, Full schematic.sch]
2021-03-04 Second prototype PCB seems to be ready
    [Full schematic.kicad_pcb]
2021-03-25 144MHz part is ready except antenna
    [Full schematic.kicad_pcb, Full schematic.sch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]
2021-04-17 Buttons don't blink, fast display draw
2021-04-19 Second I2C added, ready for 24c256 driver
    [Full schematic.sch]
2021-04-21 Kosher 24x EEPROMs driver.
2021-04-28 Able to get packets via bluetooth
    [Full schematic.sch]
2021-05-01 Added some voltage regulators
    [Full schematic.sch]
2021-05-02 Switching regulators to feed my fox
    [Full schematic.sch]
2021-05-03 Support for Bluetooth name and PIN setting
    [Full schematic.sch]
2021-05-03 List for bluetooth devices
2021-05-04 Able to list bluetooth devices
2021-05-06 Able to select device to connect + connector draft.
2021-05-14 Able to fix global fox state machine state after date change.
    [EEPROM.c, FoxStatus.c, FoxStatus.h, GlobalStateMachine.c, GlobalStateMachine.h, RTC.c, RTC.h, main.c]
2021-05-16 Fixed bug with ending tone
    [CycleStateMachine.c]
2021-05-16 Fixed one second lag
    [Time.c]
2021-05-22 Added Vbat->Vout3.5 power convertor
    [Full schematic.sch]
2021-05-22 Added filter and modified feedback network
    [Full schematic.sch]
2021-05-23 Fox is returning her name + fixed critical bug in packets processor
    [PacketsProcessor.c, PacketsProcessor.h]
2021-05-31 Switched to mapland-printf
2021-06-01 More filtering capacitors
    [Full schematic.sch]
2021-06-02 Power distribution seems to be completed
    [Full schematic.sch]
2021-06-02 - Added new manipulation for 144MHz
    - Added "Get current profile ID" command description
    [Full schematic.sch]
2021-06-02 Able to send "Get current profile ID" command
2021-06-02 Able to respond to "Get current profile ID" command.
2021-06-02 Added "Switch to current profile ID" command description
2021-06-02 Selecting current profile in list.
2021-06-03 Sending switch to profile command
2021-06-03 Able to switch proflie by command
2021-06-05 Some refactoring and bugfixing
    [PacketsProcessor.c]
2021-06-07 Some finishing touches on schematics
    [Full schematic.sch]
2021-06-07 It seems that schematics is ready
    [Full schematic.sch]
2021-06-08 Added "get begin and end times" command description
    [Full schematic.sch]
2021-06-08 It seems that I generate correct response to "Get begin and end times", however smartphone unable to get it.
    [PacketsProcessor.c, PacketsProcessor.h]
2021-06-08 Added programming connector
    [Full schematic.sch]
2021-06-08 Added "arm fox" command description
2021-06-08 Able to send "Arm fox" command
2021-06-08 Able to arm fox by command
2021-06-09 Assigned cases to parts, ready to trace PCB
    [Filter response.ods, Full schematic.kicad_pcb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]
2021-06-09 PCB tracing in progress
    [Full schematic.kicad_pcb]
2021-06-11 Get fox power command description
2021-06-11 Able to send "Get fox power" command
2021-06-11 Able to report fox power
2021-06-11 "Set fox power" command description
2021-06-11 Able to send "Set fox power" command
2021-06-11 Able to set fox power
2021-06-12 Added "Get battery level" command description
2021-06-12 Able to send "Get battery level" command
2021-06-12 Able to report battery level
2021-06-14 PCB tracing in progress - almost done
    [Full schematic.kicad_pcb]
2021-06-18 PCB tracing in progress - need to connect transmitters unit
    [Full schematic.kicad_pcb]
2021-06-19 PCB tracing - all parts are connected as needed
    [Full schematic.kicad_pcb]
2021-06-19 PCB seems to be ready
    [Full schematic.kicad_pcb]
2021-06-19 Generated gerber files
    [Full schematic-B_Cu.gbr, Full schematic-B_Mask.gbr, Full schematic-Edge_Cuts.gbr, Full schematic-F_Cu.gbr, Full schematic-F_Mask.gbr, Full schematic-NPTH.drl, Full schematic-PTH.drl, Full schematic-job.gbrjob]
2021-07-01 Fixed short-sircuit on PCB
    [Full schematic.kicad_pcb]
2021-07-01 Updated Gerber files
    [Full schematic.kicad_pcb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]
2021-07-03 Switched to serial hardware, writing HAL for it.
2021-07-04 HAL is able to measure various voltages (in ADC values)
2021-07-04 Added new commands to get various fox voltages
2021-07-04 Able to sent "Get UAnt ADC" service command
2021-07-04 Able to report UAnt (ADC)
2021-07-04 Able to send "Get UBatt ADC" command.
2021-07-04 Able to respond to "Get UBatt ADC" and "Get U80m ADC" commands
2021-07-04 Able to send "Get U80m ADC" command.
2021-07-04 Able to display (both on fox and on phone) real battery level.
    [Active filter.sch, DDS.kicad_pcb, DDS.sch, Filter response.ods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]
2021-07-04 Able to regulate U80m voltage
2021-07-04 U80m calibration
    [Full schematic.kicad_pcb, Full schematic.sch]
2021-07-04 Two new commands to get fox voltages
2021-07-05 Able to display Ubatt in volts
2021-07-05 Able to display U80m in volts
2021-07-06 - Required power -> U80m - 3.5MHz de-initialization
2021-07-06 Power calibrations
2021-07-10 - Fox case (in progress) - Initial antenna matching
    [Case - bottom (Meshed).stl, Case - bottom.FCStd]
2021-07-10 Antenna matching working
2021-07-10 - Fixed bug with 3.5MHz high power setting - Described events
    [HAL.c]
2021-07-10 Fox is able to send events about arming and antenna matching
2021-07-13 - PCB fixers
    - Some events changes
    [PCB Fixer (Meshed).stl, PCB fixers.FCStd]
2021-07-13 Able to see antenna matching events
2021-07-13 Fixed max antenna matching position
    [HardwareLogic.c]
2021-07-13 Forgot to enable antenna matching pins
2021-07-14 Fixed suicidal fox behaviour (enabled 144MHz tract and manipulator on reset)
    [HAL.c]
2021-07-16 Case front panel
    [Case - top (Meshed).stl, Case - top.FCStd]
2021-07-16 Able to rename bluetooth device after fox rename.
2021-07-16 Second antenna matching before transmission start
2021-07-31 Antenna matching graph
2021-08-03 Switched to new time counting mechanism
2021-08-03 Block fox disarming when it not armed or antenna matching in progress
2021-08-08 - Encoder stabilization - Initial menu implementation
2021-09-11 Hardware buttons noise suppression
    [HAL.c, HAL.h, HALPrivate.h, main.c]
2021-09-11 Varying text for left button when menu nodes are selected
2021-09-11 - Fixed the bug with incorrect profile name after setting it from phone
    [Buttons.c, Buttons.h, FoxStatus.h, InformationPopupDisplay.c, InformationPopupDisplay.h, InformationPopupDisplayPrivate.h, MenuDisplay.c, MenuDisplay.h]
2021-09-18 Able to switch profiles from fox
2021-09-19 Able to switch frequency range
2021-10-30 Able to arm fox from meny
2021-10-30 Able to disarm fox, but memory seems to be damaged
    [MainPrivate.h, MenuDisplay.c, MenuDisplay.h, MenuDisplayPrivate.h, main.h]
2021-10-30 Fixed some const violations
    [MenuDisplay.c, MenuDisplay.h, MenuDisplayPrivate.h]
2021-10-31 Able to set TX power from fox menu
2021-10-31 Able to set current time from fox menu
2021-10-31 Fox is able to report last failure code via bluetooth
    [EEPROM.c, EEPROM.h, PacketsProcessor.c, PacketsProcessor.h, SelfDiagnostics.h]
2021-10-31 Graceful shutdown with error logging in case of failure
    [HAL.c, HAL.h, MainPrivate.h, SelfDiagnostics.c, SelfDiagnostics.h]
2021-11-03 Fixed a bug in self-diagnostics
    [SelfDiagnostics.c]
2021-11-05 Correct display initialization on first power on
    [FoxStatus.c, FoxStatusPrivate.h, HAL.c, HAL.h, HALPrivate.h, HardwareLogic.c, HardwareLogic.h, InformationPopupDisplay.c]
2021-11-05 Fixed a bug with display re-initialization
    [HAL.c, HardwareLogic.c, HardwareLogic.h]
2021-11-07 Sleepmode current is 4.3mA
2021-11-07 Sleepmode current is 4mA
2021-11-07 Two sleepmodes, correct sleep during cycle.
    [FoxStatusPrivate.h, HardwareLogic.c, HardwareLogic.h, MainPrivate.h, PacketsProcessor.c, SelfDiagnostics.h, Sleepmodes.c, Sleepmodes.h]
2021-11-08 Disabling UART during economy mode
2021-11-08 Sleep consumption is 3.56mA
2021-11-10 Fixed a bug with inability to connect to fox after sleepmode.
    [Sleepmodes.c, Sleepmodes.h]
2021-11-10 Fixed a bug with inability to send "entering sleepmode" event
    [Sleepmodes.c, Sleepmodes.h]
2021-11-11 Debugging define to disable antenna matching
2021-11-13 Fixed CRC initialization issue
    [l2hal_crc.c, l2hal_custom.h, l2hal_hc06.h]
2021-11-13 Fixed a bug in menu text
    [MenuDisplay.c]
2021-11-13 Able to switch "Connect" button.
2021-11-14 Fox connector initial implementation
2021-11-15 Fixed a bug with losing fonts due to transparency corruption.
    [GlobalVariables.h, MainPrivate.h, main.c]
2021-11-18 Fixed a bug with renaming bluetooth module during EEPROM format
    [EEPROM.c, EEPROM.h, HardwareLogic.c, l2hal_hc06.c, l2hal_hc06.h, main.c]
2021-11-18 Able to identify is device a fox or not
2021-11-19 Hope that now it will be no memory damage after antenna matching
    [FoxStatus.h, FoxStatusPrivate.h, HAL.h, main.c]
2021-11-19 Fixed a bug with U80m control loop still enabled after a cycle
    [HAL.h, HardwareLogic.c, HardwareLogic.h]
2021-11-19 Fixed a bug with EndTime < StartTime when times wraps around a midnight
    [FoxStatus.c, FoxStatus.h, MenuDisplay.c, PacketsProcessor.c, SelfDiagnostics.h]
2021-11-21 Buttons for update fox name and firmware update
2021-11-21 Able to rename a fox without a problem
    [HardwareLogic.c, HardwareLogic.h]
2021-11-23 Profiles count + control over "Add profile" button
2021-11-30 Fixed a bug with missing await on detect current profile
2021-12-04 Able to switch cycle type
2021-12-05 Fast durations change buttons
2021-12-12 Able to load fox power
2021-12-15 - Able to display battery level - Fox doesn't go to sleep while app is connected
2021-12-15 - No need to disable buttons after click - Fixed some XAML logic bugs - Dirty hack with after command wait time
2021-12-16 Found a bug in firmware, when "Arm Fox OK" response is being sent when fox armed manually.
2021-12-16 Now not sending "Arm fox" response if fox armed manually
2021-12-17 - Able to arm fox - Need to make events processing in firmware faster
2021-12-19 Able to arm and disarm fox
2021-12-20 - Fixed a couple of bugs with redundant profile settigns changes - Increased timeout to infinity (for debug).
2021-12-20 Fixed a bug with incorrect commands execution when interrupd came during EEPROM write
    [Commands.h, FoxStatus.c, MainPrivate.h, PacketsProcessor.c, main.c]
2021-12-20 100% of charge is 8.4V now
2021-12-22 Matching event now contains information about total matching steps + antenna voltage now in volts.
2021-12-22 Must process new antenna matching event correctly.
2021-12-22 Fixed wrong antenna matching event packet size
    [PacketsProcessor.c]
2021-12-22 Displaying antenna matching stage
2021-12-22 Partially completed antenna matching graph.
2021-12-23 Working antenna matching graph
2021-12-25 Reduced framebuffer by 6Kb. Now I have plenty of RAM
2021-12-25 Re-enabled antenna matching
2021-12-25 STM32 HAL bumped to 1.8.0
2021-12-25 Fixed minor noise on the display
    [l2hal_ssd1327.c, l2hal_ssd1327_private.h]
2021-12-25 Fixed buffer lengths for meny items
    [MenuDisplayPrivate.h]
2021-12-25 - Increased interline timeout for display - Disabled UART lock
2021-12-25 Buttons enable/disable logic
2021-12-25 More logic for buttons
2021-12-26 Added information on antenna equivalents
    [Full schematic.sch]
2021-12-26 Sending "Profile switched" event
2021-12-26 Processing profile switch from the fox side
2021-12-27 Fast UART interrupt handler
2021-12-27 Antenna matching from main cycle, without dumb delays.
2021-12-27 Updated L12 value for matching with antennas of different lengths
    [Full schematic.sch]
2021-12-27 Protocol update:
    - Removed antenna matching event
    - Added commands to read matcher status and data
2021-12-28 Some antenna matching data in FoxState.AntennaMatching
2021-12-28 All data for antenna matching are in FoxState.AntennaMatching.
2021-12-28 Fox is able to respond to "Get antenna matching data" command
2021-12-28 Able to get antenna matching status from fox.
2021-12-28 Partially reworked antenna matching display
2021-12-28 Added current antenna voltage to matching status
2021-12-28 Able to report matching voltage postfactum
2021-12-29 Moved some code to antenna matching manager
2021-12-30 Eliminated "On Profile Switched" event
2021-12-31 Fixed a bug with non-reset "Is profile settings changes" flag.
    [HAL.h, PacketsProcessor.c]
2022-01-05 Updated Full schematic.pdf
2022-01-07 After system reinstallation (different version of KiCAD)
    [Full schematic.sch]
2022-01-07 Fixed display output for new version of compiler
    [l2hal_ssd1327.c, l2hal_ssd1327_private.h]
2022-01-08 Really fixed up for a new compiler
    [l2hal_ad5245.h, l2hal_ssd1327.c, l2hal_ssd1327_private.h, main.c]
2022-01-09 Priority events are now in separate thread to make events processing faster
2022-01-11 Lots of bugfixes, fox must not hang anymore
    [HAL.c, HAL.h, HardwareLogic.h, Version.h, l2hal.c, l2hal.h, l2hal_custom.c, l2hal_custom.h]
2022-01-12 Command to reset last error code
    [Commands.h, FoxStatus.c, MainPrivate.h, PacketsProcessor.c, PacketsProcessor.h, main.c]
2022-01-13 Fixed a response to "Reset last error code" command
    [main.c]
2022-01-16 Able to display battery level averaaged ADC value
2022-01-17 Able to display battery voltage
2022-01-17 Commands to get and set Ubatt(ADC) -> Ubatt(Volts) factors.
2022-01-17 Able to read UBatt(ADC) -> UBatt(volts) factors.
2022-01-18 Able to reset Ubatt(ADC)->Ubatt(Volts) factors
2022-01-18 Fixed a bug with setting Ubatt(ADC)->Ubatt(Volts) factors
    [PacketsProcessor.c]
2022-01-20 Fox is able now to accept Ubatt(Volts) to Battery level factors
2022-01-20 Able to get Ubatt(Volts) to battery level factors
2022-01-20 Able to set Ubatt(Volts) -> Battery level factors
2022-01-22 Fox must be able now to get/set U80m(ADC)->U80m(Volts) factors.
2022-01-24 Able to get U80m ADC value
2022-01-24 Able to read U80m voltage
2022-01-26 Able to get U80m(ADC) -> U80m(Volts) factors
2022-01-28 Fox must be able to get/set Uant(ADC)->Uant(Volts) factors.
2022-01-29 Able to get Uant ADC and voltage values
2022-01-29 Able to send Uant(ADC) -> Uant(Volts) factors, but fox always returns 0 as B factor.
2022-01-29 Fixed a bug with incorrectly setting Uant factors.
    [FoxStatus.c]
2022-01-31 Fixed a bug with force TX on
    [HardwareLogic.c, main.c]
2022-01-31 Fixed a bug with a matcher position during forced TX
    [HardwareLogic.c]
2022-02-01 - Fixed bugs with renaming bluetooth device and data packing
    [EEPROM.c, EEPROM.h, FoxStatusPrivate.h, GlobalVariables.h, HAL.c, HAL.h, RTC.c, RTC.h]
2022-02-01 - Fixed a bug with incorrect pointers to data in "Get AB factors" commands
    - Implemented "Read RTC calibration data" command
    [PacketsProcessor.c, PacketsProcessor.h]
2022-02-01 Fox-side RTC calibration
2022-02-01 Able to get RTC calibration value
2022-02-01 Able to set RTC calibration value, but fox reports failure.
2022-02-01 Fixed an incorrect validation response.
    [FoxStatus.c]
2022-02-04 Forced 1-byte EEPROM exchange, it removed random I/O EEPROM errors.
    [EEPROM.c, EEPROM.h, FoxStatusPrivate.h, GlobalVariables.h, MainPrivate.h, l2hal_crc.c, main.c]
2022-02-05 Decreased EEPROM's I2C speed, decreased interwrite interval
2022-02-05 Fox disarmes when battery is discharged.
2022-02-07 I2C bus speed-up
2022-02-08 2m antenna (3d printable!)
    [Antenna 2m - base.FCStd, Antenna 2m - base.stl, Antenna 2m - wire tip.FCStd, Antenna 2m - wire tip.stl]
2022-02-08 Squashed a bug with wrong buttons text on manual arming.
    [MenuDisplay.c, MenuDisplay.h]
2022-08-07 Split current schematic version into two
    [Full schematic-B_Cu.gbr, Full schematic-B_Mask.gbr, Full schematic-Edge_Cuts.gbr, Full schematic-F_Cu.gbr, Full schematic-F_Mask.gbr, Full schematic-NPTH.drl, Full schematic-PTH.drl, Full schematic-job.gbrjob]
2022-08-07 Changed 3.3V regulator to more efficient
    [Full schematic.kicad_sch]
2022-08-07 MCU is able to shut-down most of 3.3V-powered circuits to reduce battery consumption
    [Full schematic.kicad_sch]
2022-08-07 Removed 30 capacitors from antenna tuner by swithcing to high-voltage capacitors
    [Full schematic.kicad_sch]
2022-08-07 New antenna matcher with smaller relays
    [Full schematic.kicad_sch]
2022-08-08 Prepared to start PCB tracing
    [Full schematic.kicad_pcb, Full schematic.kicad_sch]
2022-08-08 All inductors are SMD now
    [Full schematic.kicad_pcb, Full schematic.kicad_sch]
2022-08-08 - New antenna matcher
    - Ready to trace PCB
    [Full schematic.kicad_pcb, Full schematic.kicad_sch]
2022-08-09 Partially traced new PCB
    [Full schematic.kicad_pcb]
2022-08-10 - some schematic fixes
    - PCB tracing in progress
    [Full schematic.kicad_pcb, Full schematic.kicad_sch]
2022-08-10 - PCB tracing in progress
    [Full schematic.kicad_pcb]
2022-08-11 RF parts and frequency synthesizer traced
    [Full schematic.kicad_pcb]
2022-08-14 PCB tracing is close to an end
    [Full schematic.kicad_pcb, Full schematic.kicad_sch]
2022-08-14 Traced all connections, now need to fill everything with ground
    [Full schematic.kicad_pcb]
2022-08-15 PCB seems to be production-ready
    [Full schematic.kicad_pcb]
2023-02-07 Gerbers for JLC PCB
    [Full schematic-B_Cu.gbl, Full schematic-B_Cu.gbr, Full schematic-B_Mask.gbr, Full schematic-B_Mask.gbs, Full schematic-B_Paste.gbp, Full schematic-B_Silkscreen.gbo, Full schematic-Edge_Cuts.gbr, Full schematic-Edge_Cuts.gm1]
