WhiteFossa/yiff-l/(notices)

Notices in the files:
Firmware/yiff/src/l2hal/drivers/display/ssd1306/src/l2hal_ssd1306.c:
you can redistribute it and/or modify it under the terms of the
GNU General Public License as published by the Free Software
